mibs510/OpenXTCM5-Head-Unit/docs/portfolio/openxtcm5-head-unit/README.md

# OpenXTCM5 Portfolio Draft

This directory contains the long-form portfolio draft and editable Mermaid sources for the OpenXTCM5 project.

| Path | Purpose |
| --- | --- |
| [openxtcm5-head-unit.md](openxtcm5-head-unit.md) | Long-form technical portfolio draft. |
| [01-openxtcm5-recoverable-system-draft.md](01-openxtcm5-recoverable-system-draft.md) | Condensed first-article draft; explicitly pre-layout and not published. |
| [gap-analysis.md](gap-analysis.md) | Editorial and engineering evidence gaps before publication. |
| [publication-roadmap.md](publication-roadmap.md) | Three-revision plan: schematic, layout, then prototype evidence and corrections. |
| [diagrams/system-architecture.mmd](diagrams/system-architecture.mmd) | System ownership diagram. |
| [diagrams/power-state-machine.mmd](diagrams/power-state-machine.mmd) | Global power sequencing diagram. |
| [diagrams/display-touch-stack.mmd](diagrams/display-touch-stack.mmd) | Display-bias and GT911 touch diagram. |
| [diagrams/rp2354-firmware-update.mmd](diagrams/rp2354-firmware-update.mmd) | CM5-controlled RP2354 USB BOOTSEL firmware-update sequence, with recovery as a fallback use. |
| [diagrams/design-review-loop.mmd](diagrams/design-review-loop.mmd) | Iterative review and validation loop. |
| [diagrams/mermaid-static-config.json](diagrams/mermaid-static-config.json) | Shared visual style for static Mermaid renders. |
| [diagrams/static/](diagrams/static/) | High-resolution PNG renders ready to upload to Ghost. |

The Mermaid diagrams remain the editable source. The matching PNGs in `diagrams/static/` are the static article assets; regenerate them after changing a source diagram or the shared render configuration.
