mibs510/OpenXTCM5-Head-Unit/pcb/audio-amplifier.kicad_sch

## KiCad design pcb/audio-amplifier.kicad_sch (2026-10-04)

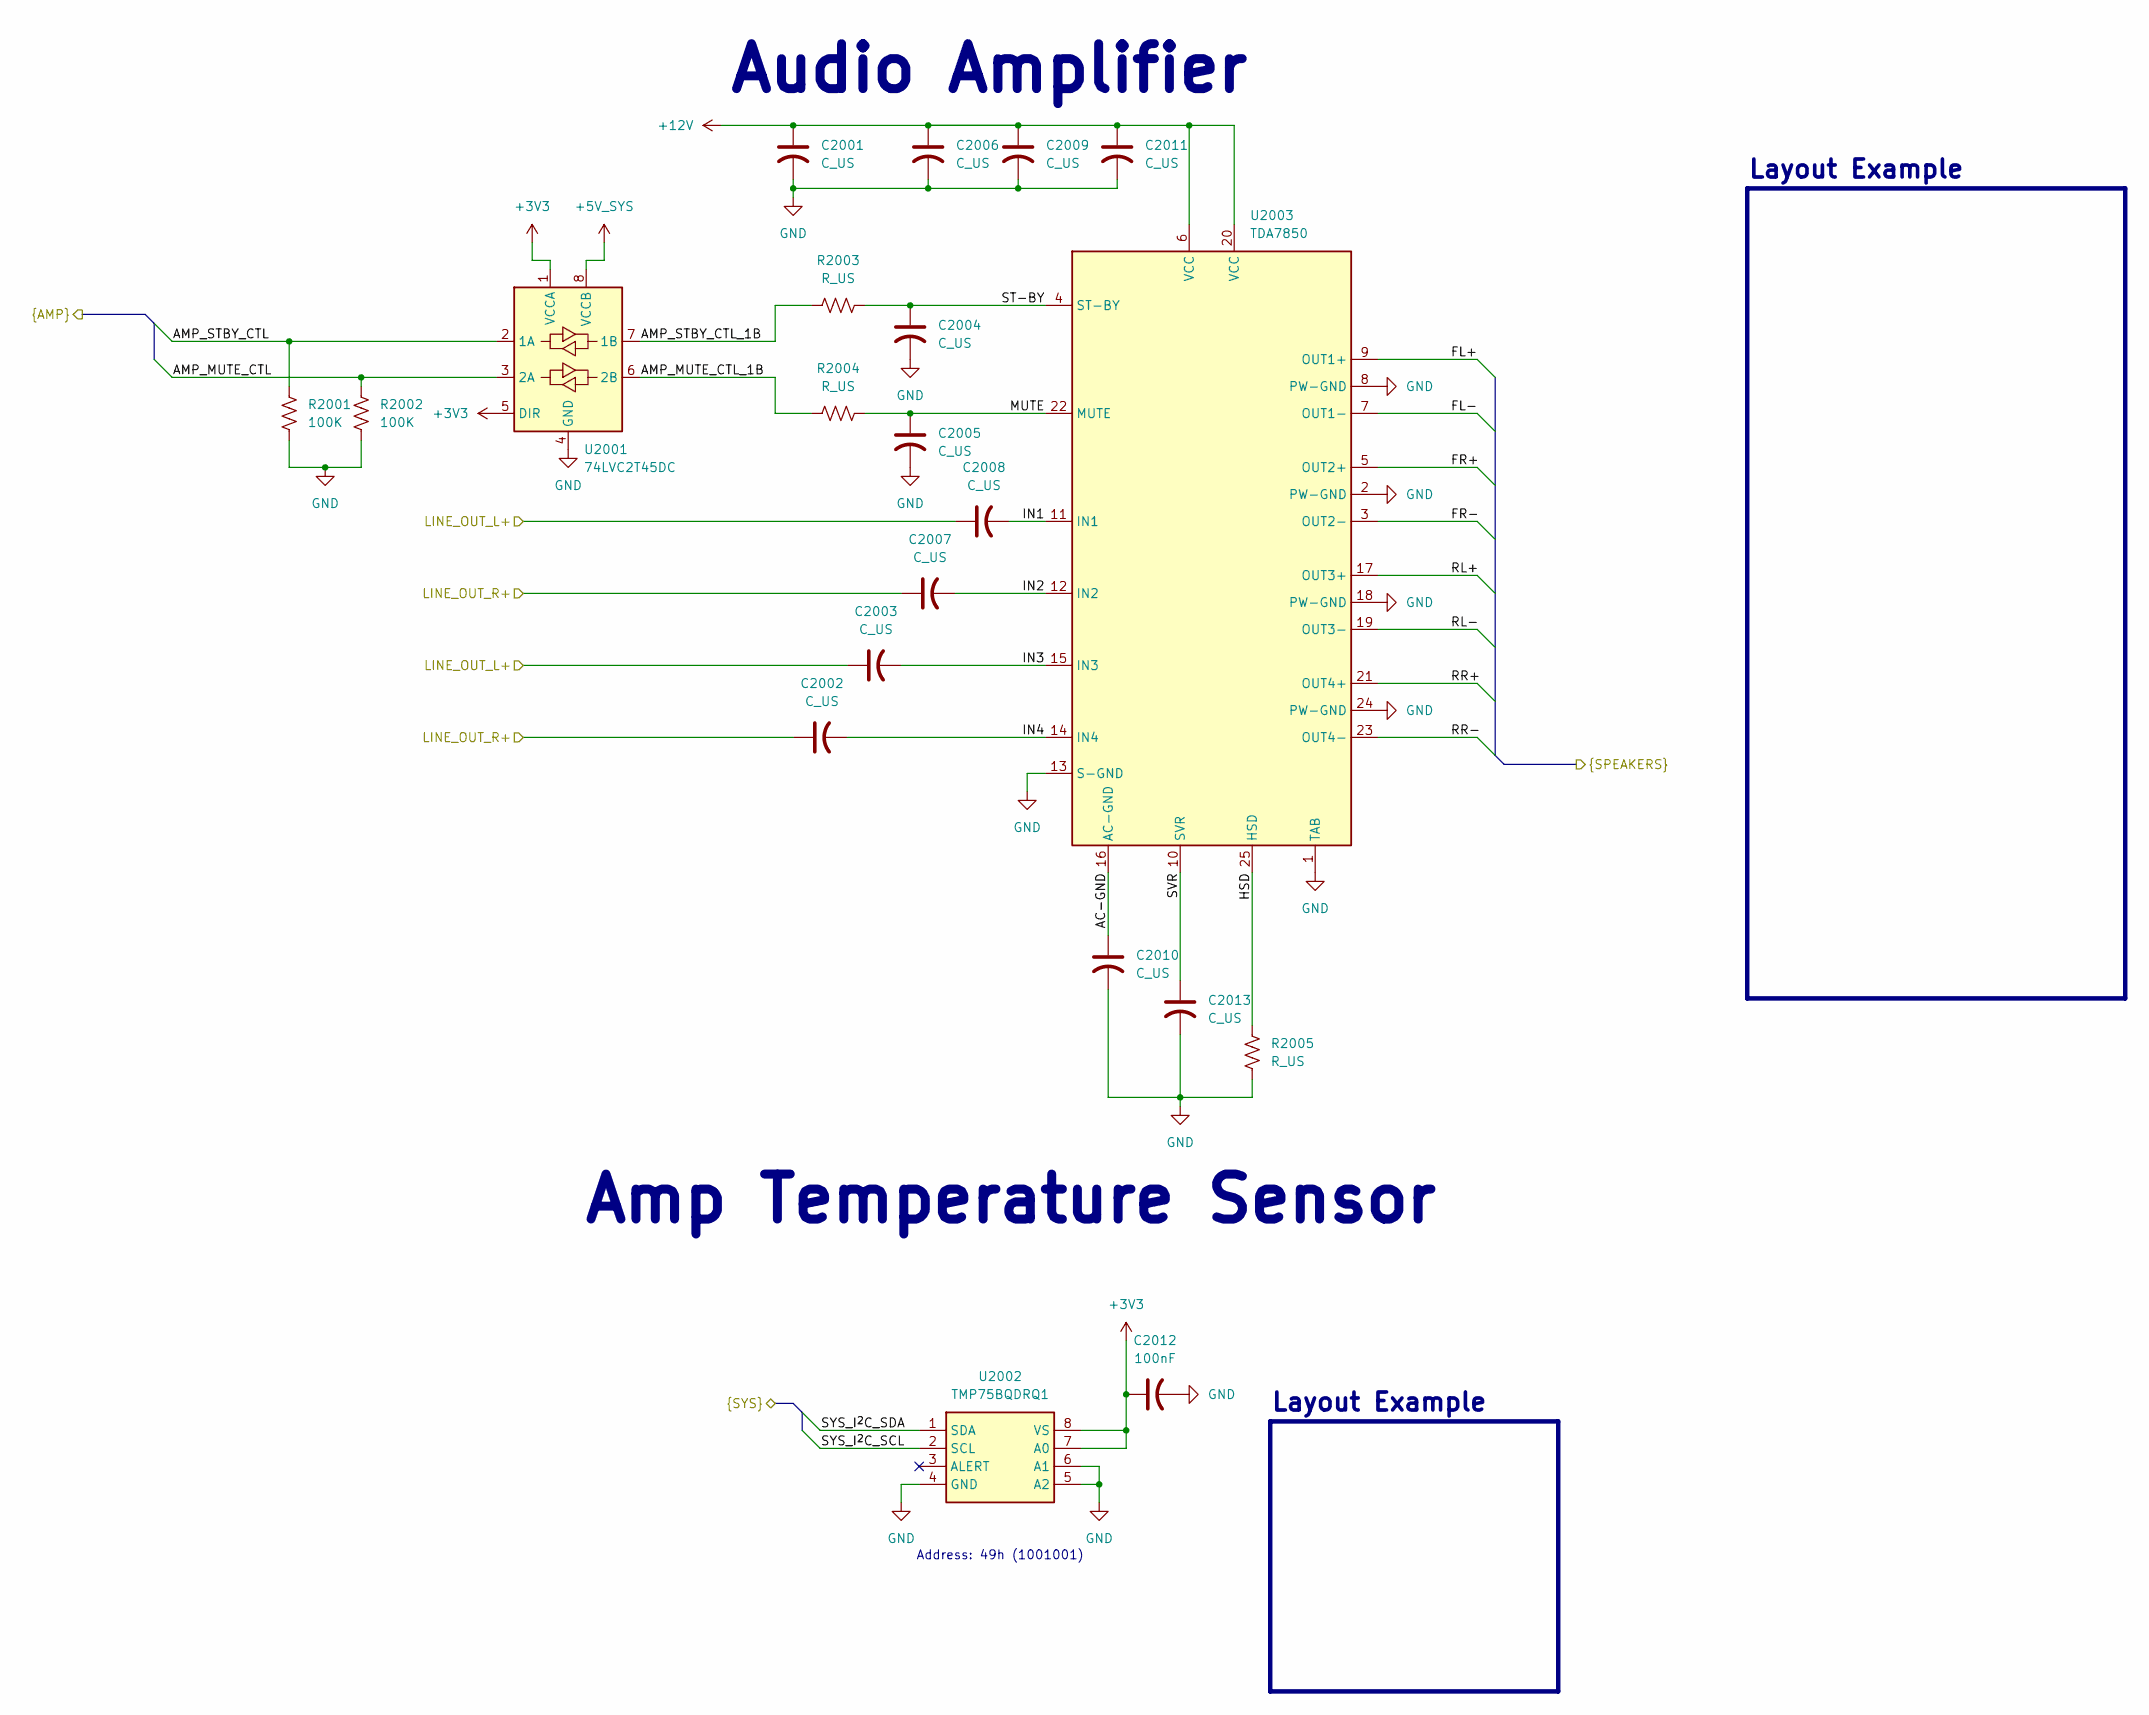
[picture p1: schematic audio-amplifier.kicad_sch]

Parts:
C2001, C2002, C2003, C2004, C2005, C2006, C2007, C2008, C2009, C2010, C2011, C2013: C_US; C_0603_1608Metric
C2012: 100nF; C_0603_1608Metric
R2001, R2002: 100K; R_0603_1608Metric
R2003, R2004, R2005: R_US; R_0603_1608Metric
U2001: 74LVC2T45DC; VSSOP-8_2.3x2mm_P0.5mm
U2002: TMP75BQDRQ1; SOIC127P600X175-8N; Mouser Part Number 595-TMP75BQDRQ1
U2003: TDA7850; TO100P465X2910X1977-25P; Mouser Part Number 511-TDA7850

Connections:
+3V3: C2012.1, U2001.1 (VCCA), U2001.5 (DIR), U2002.7 (A0), U2002.8 (VS)
+5V_SYS: U2001.8 (VCCB)
+12V: C2001.1, C2006.1, C2009.1, C2011.1, U2003.6 (VCC), U2003.20 (VCC)
AC-GND: C2010.1, U2003.16 (AC-GND)
AMP_MUTE_CTL: R2002.1, U2001.3 (2A)
AMP_MUTE_CTL_1B: R2004.1, U2001.6 (2B)
AMP_STBY_CTL: R2001.1, U2001.2 (1A)
AMP_STBY_CTL_1B: R2003.1, U2001.7 (1B)
FL+: U2003.9 (OUT1+)
FL-: U2003.7 (OUT1-)
FR+: U2003.5 (OUT2+)
FR-: U2003.3 (OUT2-)
GND: C2001.2, C2004.2, C2005.2, C2006.2, C2009.2, C2010.2, C2011.2, C2012.2, C2013.2, R2001.2, R2002.2, R2005.2, U2001.4 (GND), U2002.4 (GND), U2002.5 (A2), U2002.6 (A1), U2003.1 (TAB), U2003.2 (PW-GND), U2003.8 (PW-GND), U2003.13 (S-GND), U2003.18 (PW-GND), U2003.24 (PW-GND)
HSD: R2005.1, U2003.25 (HSD)
IN1: C2008.2, U2003.11 (IN1)
IN2: C2007.2, U2003.12 (IN2)
IN3: C2003.2, U2003.15 (IN3)
IN4: C2002.2, U2003.14 (IN4)
LINE_OUT_L+: C2003.1, C2008.1
LINE_OUT_R+: C2002.1, C2007.1
MUTE: C2005.1, R2004.2, U2003.22 (MUTE)
RL+: U2003.17 (OUT3+)
RL-: U2003.19 (OUT3-)
RR+: U2003.21 (OUT4+)
RR-: U2003.23 (OUT4-)
ST-BY: C2004.1, R2003.2, U2003.4 (ST-BY)
SVR: C2013.1, U2003.10 (SVR)
SYS_I^{2}C_SCL: U2002.2 (SCL)
SYS_I^{2}C_SDA: U2002.1 (SDA)

Notes on the sheet:
Audio Amplifier
Address: 49h (1001001)
Amp Temperature Sensor
Layout Example
