mibs510/OpenXTCM5-Head-Unit/pcb/audio.kicad_sch

## KiCad design pcb/audio.kicad_sch (2026-10-04)

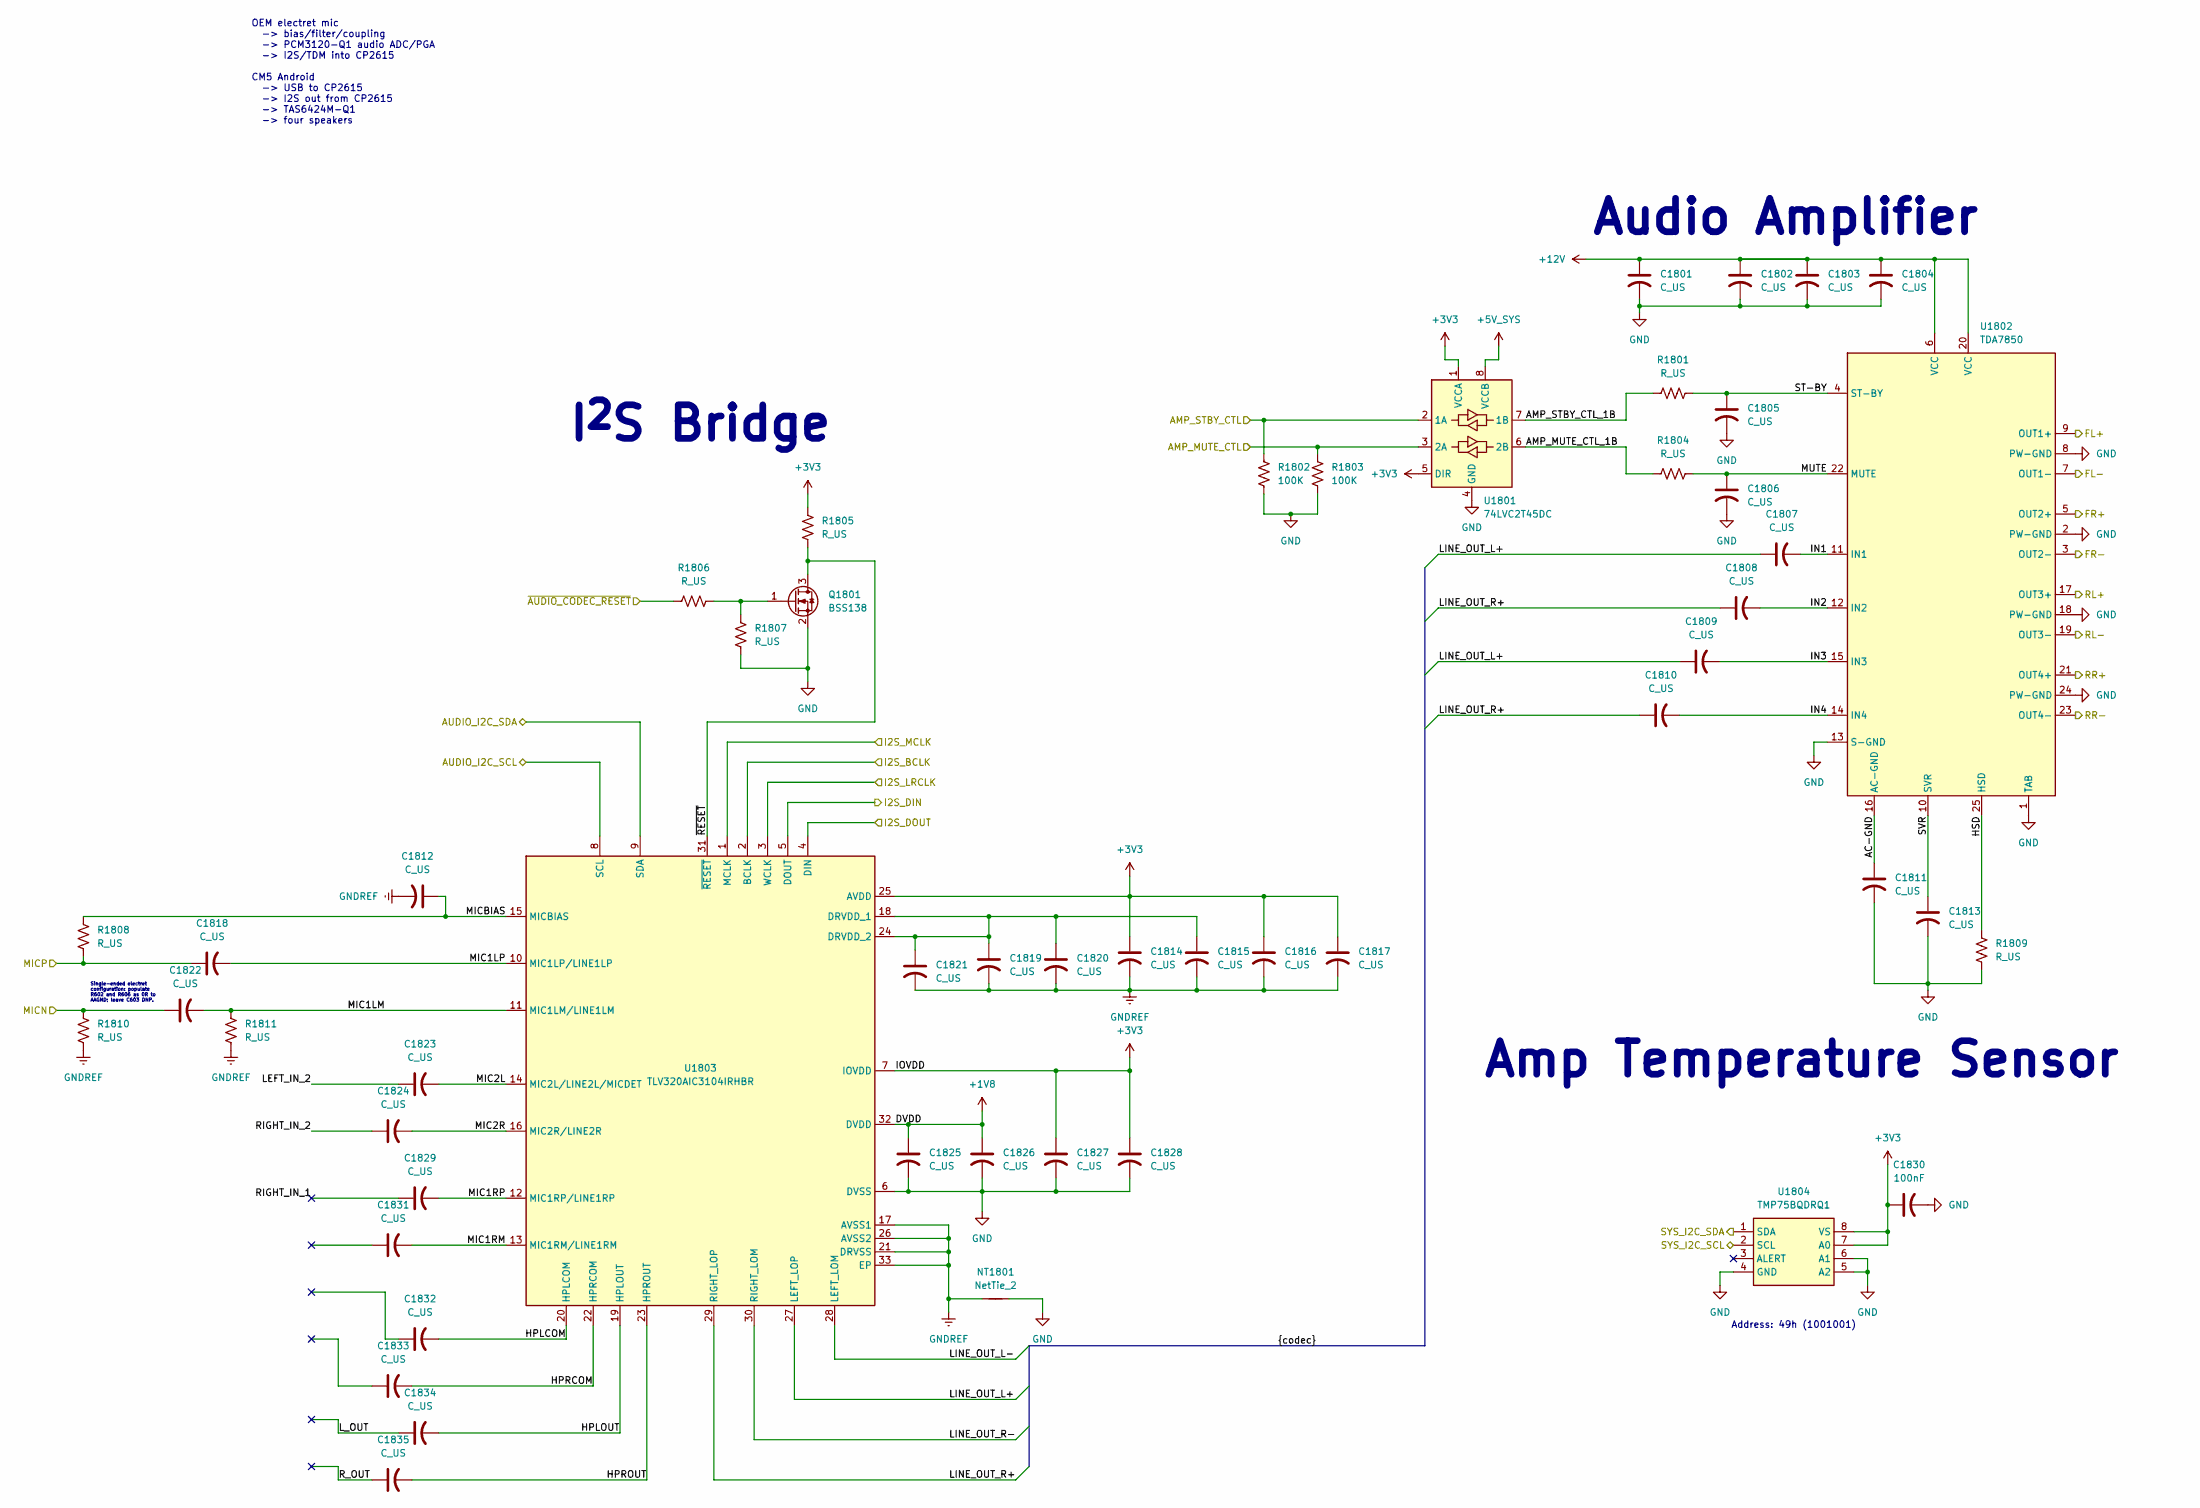
[picture p2: schematic audio.kicad_sch]

Parts:
C1801, C1802, C1803, C1804, C1805, C1806, C1807, C1808, C1809, C1810, C1811, C1812, C1813, C1818, C1822, C1823, C1824, C1829, C1831, C1832, C1833, C1834, C1835: C_US; C_0603_1608Metric
C1814, C1815, C1816, C1817, C1819, C1820, C1821, C1825, C1826, C1827, C1828: C_US; C_0805_2012Metric
C1830: 100nF; C_0603_1608Metric
NT1801: NetTie_2; NetTie-2_THT_Pad0.3mm
Q1801: BSS138; SOT-23
R1801, R1804, R1805, R1806, R1807, R1808, R1809, R1810, R1811: R_US; R_0603_1608Metric
R1802, R1803: 100K; R_0603_1608Metric
U1801: 74LVC2T45DC; VSSOP-8_2.3x2mm_P0.5mm
U1802: TDA7850; TO100P465X2910X1977-25P; Mouser Part Number 511-TDA7850
U1803: TLV320AIC3104IRHBR; QFN50P500X500X100-33N-D; Mouser Part Number 595-TLV320C3104IRHBR
U1804: TMP75BQDRQ1; SOIC127P600X175-8N; Mouser Part Number 595-TMP75BQDRQ1

Connections:
+1V8: C1825.1, C1826.1, U1803.32 (DVDD)
+3V3: C1814.1, C1816.1, C1817.1, C1827.1, C1828.1, C1830.1, R1805.2, U1801.1 (VCCA), U1801.5 (DIR), U1803.7 (IOVDD), U1803.25 (AVDD), U1804.7 (A0), U1804.8 (VS)
+5V_SYS: U1801.8 (VCCB)
+12V: C1801.1, C1802.1, C1803.1, C1804.1, U1802.6 (VCC), U1802.20 (VCC)
AC-GND: C1811.1, U1802.16 (AC-GND)
AMP_MUTE_CTL: R1803.1, U1801.3 (2A)
AMP_MUTE_CTL_1B: R1804.1, U1801.6 (2B)
AMP_STBY_CTL: R1802.1, U1801.2 (1A)
AMP_STBY_CTL_1B: R1801.1, U1801.7 (1B)
AUDIO_I2C_SCL: U1803.8 (SCL)
AUDIO_I2C_SDA: U1803.9 (SDA)
FL+: U1802.9 (OUT1+)
FL-: U1802.7 (OUT1-)
FR+: U1802.5 (OUT2+)
FR-: U1802.3 (OUT2-)
GND: C1801.2, C1802.2, C1803.2, C1804.2, C1805.2, C1806.2, C1811.2, C1813.2, C1825.2, C1826.2, C1827.2, C1828.2, C1830.2, NT1801.2, Q1801.2 (S), R1802.2, R1803.2, R1807.1, R1809.2, U1801.4 (GND), U1802.1 (TAB), U1802.2 (PW-GND), U1802.8 (PW-GND), U1802.13 (S-GND), U1802.18 (PW-GND), U1802.24 (PW-GND), U1803.6 (DVSS), U1804.4 (GND), U1804.5 (A2), U1804.6 (A1)
GNDREF: C1812.2, C1814.2, C1815.2, C1816.2, C1817.2, C1819.2, C1820.2, C1821.2, NT1801.1, R1810.2, R1811.2, U1803.17 (AVSS1), U1803.21 (DRVSS), U1803.26 (AVSS2), U1803.33 (EP)
HPLCOM: C1832.2, U1803.20 (HPLCOM)
HPLOUT: C1834.2, U1803.19 (HPLOUT)
HPRCOM: C1833.2, U1803.22 (HPRCOM)
HPROUT: C1835.2, U1803.23 (HPROUT)
HSD: R1809.1, U1802.25 (HSD)
I2S_BCLK: U1803.2 (BCLK)
I2S_DIN: U1803.5 (DOUT)
I2S_DOUT: U1803.4 (DIN)
I2S_LRCLK: U1803.3 (WCLK)
I2S_MCLK: U1803.1 (MCLK)
IN1: C1807.2, U1802.11 (IN1)
IN2: C1808.2, U1802.12 (IN2)
IN3: C1809.2, U1802.15 (IN3)
IN4: C1810.2, U1802.14 (IN4)
LEFT_IN_2: C1823.1
LINE_OUT_L+: C1807.1, C1809.1, U1803.27 (LEFT_LOP)
LINE_OUT_L-: U1803.28 (LEFT_LOM)
LINE_OUT_R+: C1808.1, C1810.1, U1803.29 (RIGHT_LOP)
LINE_OUT_R-: U1803.30 (RIGHT_LOM)
L_OUT: C1834.1
MIC1LM: C1822.2, R1811.1, U1803.11 (MIC1LM/LINE1LM)
MIC1LP: C1818.2, U1803.10 (MIC1LP/LINE1LP)
MIC1RM: C1831.2, U1803.13 (MIC1RM/LINE1RM)
MIC1RP: C1829.2, U1803.12 (MIC1RP/LINE1RP)
MIC2L: C1823.2, U1803.14 (MIC2L/LINE2L/MICDET)
MIC2R: C1824.2, U1803.16 (MIC2R/LINE2R)
MICBIAS: C1812.1, R1808.1, U1803.15 (MICBIAS)
MICN: C1822.1, R1810.1
MICP: C1818.1, R1808.2
MUTE: C1806.1, R1804.2, U1802.22 (MUTE)
unnamed: C1815.1, C1819.1, C1820.1, C1821.1, U1803.18 (DRVDD_1), U1803.24 (DRVDD_2)
unnamed: Q1801.1 (G), R1806.2, R1807.2
RIGHT_IN_1: C1829.1
RIGHT_IN_2: C1824.1
RL+: U1802.17 (OUT3+)
RL-: U1802.19 (OUT3-)
RR+: U1802.21 (OUT4+)
RR-: U1802.23 (OUT4-)
R_OUT: C1835.1
ST-BY: C1805.1, R1801.2, U1802.4 (ST-BY)
SVR: C1813.1, U1802.10 (SVR)
SYS_I2C_SCL: U1804.2 (SCL)
SYS_I2C_SDA: U1804.1 (SDA)
~AUDIO_CODEC_RESET: R1806.1
~RESET: Q1801.3 (D), R1805.1, U1803.31 (~RESET)

Notes on the sheet:
Address: 49h (1001001)
Single-ended electret configuration: populate R602 and R606 as 0R to AAGND; leave C603 DNP.
Amp Temperature Sensor
Audio Amplifier
I^{2}S Bridge
OEM electret mic -> bias/filter/coupling -> PCM3120-Q1 audio ADC/PGA -> I2S/TDM into CP2615 CM5 Android -> USB to CP2615 -> I2S out from CP2615 -> TAS6424M-Q1 -> four speakers
