mibs510/OpenXTCM5-Head-Unit/pcb/can.kicad_sch

## KiCad design pcb/can.kicad_sch (2026-10-04)

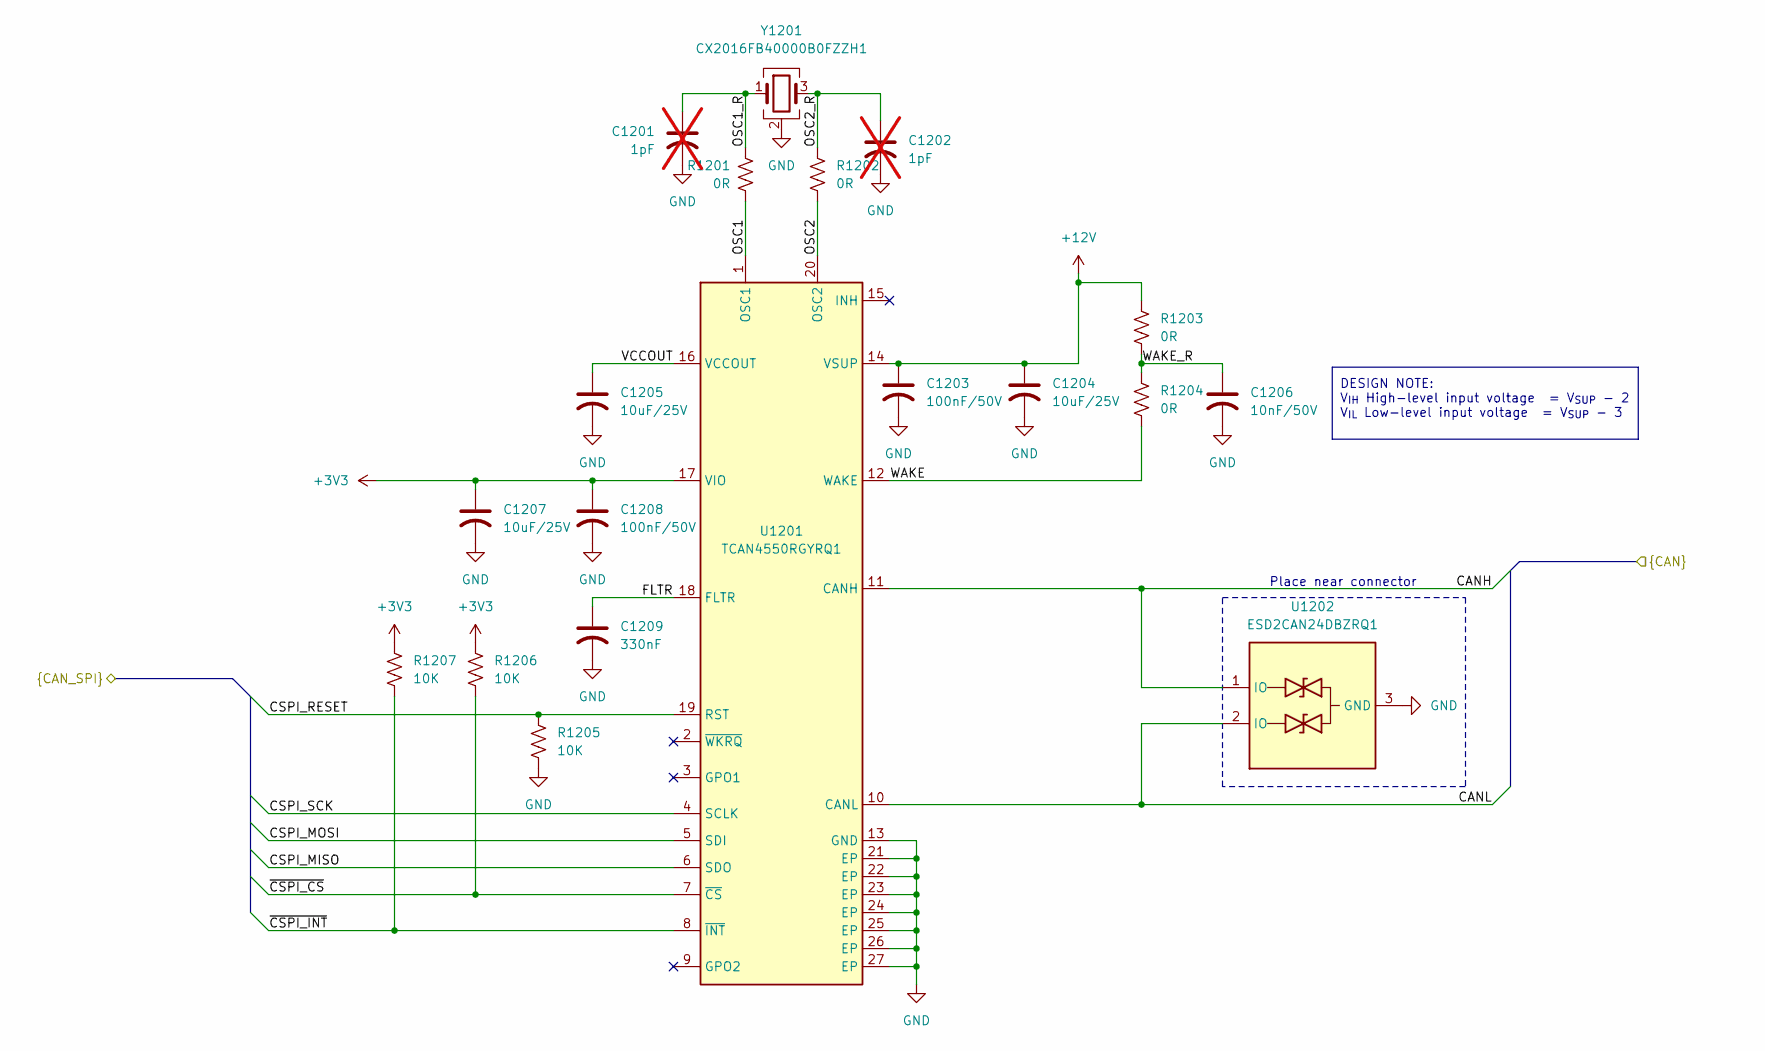
[picture p3: schematic can.kicad_sch]

Parts:
C1201, C1202: 1pF; C_0603_1608Metric; not fitted
C1203, C1208: 100nF/50V; C_0603_1608Metric
C1204, C1205, C1207: 10uF/25V; C_0805_2012Metric
C1206: 10nF/50V; C_0603_1608Metric
C1209: 330nF; C_0603_1608Metric
R1201, R1202, R1203, R1204: 0R; R_0603_1608Metric
R1205, R1206, R1207: 10K; R_0603_1608Metric
U1201: TCAN4550RGYRQ1; TCAN4551RGYRQ1; Mouser Part Number 595-TCAN4550RGYRQ1
U1202: ESD2CAN24DBZRQ1; SOT95P237X112-3N; Mouser Part Number 595-ESD2CAN24DBZRQ1
Y1201: CX2016FB40000B0FZZH1; Crystal_SMD_2016-4Pin_2.0x1.6mm

Connections:
+3V3: C1207.1, C1208.1, R1206.1, R1207.1, U1201.17 (VIO)
+12V: C1203.1, C1204.1, R1203.1, U1201.14 (VSUP)
CANH: U1201.11 (CANH), U1202.1 (IO)
CANL: U1201.10 (CANL), U1202.2 (IO)
CSPI_MISO: U1201.6 (SDO)
CSPI_MOSI: U1201.5 (SDI)
CSPI_RESET: R1205.1, U1201.19 (RST)
CSPI_SCK: U1201.4 (SCLK)
FLTR: C1209.1, U1201.18 (FLTR)
GND: C1201.2, C1202.2, C1203.2, C1204.2, C1205.2, C1206.2, C1207.2, C1208.2, C1209.2, R1205.2, U1201.13 (GND), U1201.21 (EP), U1201.22 (EP), U1201.23 (EP), U1201.24 (EP), U1201.25 (EP), U1201.26 (EP), U1201.27 (EP), U1202.3 (GND), Y1201.2 (G), Y1201.4 (G)
OSC1: R1201.2, U1201.1 (OSC1)
OSC1_R: C1201.1, R1201.1, Y1201.1
OSC2: R1202.2, U1201.20 (OSC2)
OSC2_R: C1202.1, R1202.1, Y1201.3
VCCOUT: C1205.1, U1201.16 (VCCOUT)
WAKE: R1204.2, U1201.12 (WAKE)
WAKE_R: C1206.1, R1203.2, R1204.1
~CSPI_CS: R1206.2, U1201.7 (~CS)
~CSPI_INT: R1207.2, U1201.8 (~INT)

Notes on the sheet:
DESIGN NOTE: V_{IH} High-level input voltage = V_{SUP} - 2 V_{IL} Low-level input voltage = V_{SUP} - 3
Place near connector
