mibs510/OpenXTCM5-Head-Unit/pcb/cm5.kicad_sch

## KiCad design pcb/cm5.kicad_sch (2026-10-04)

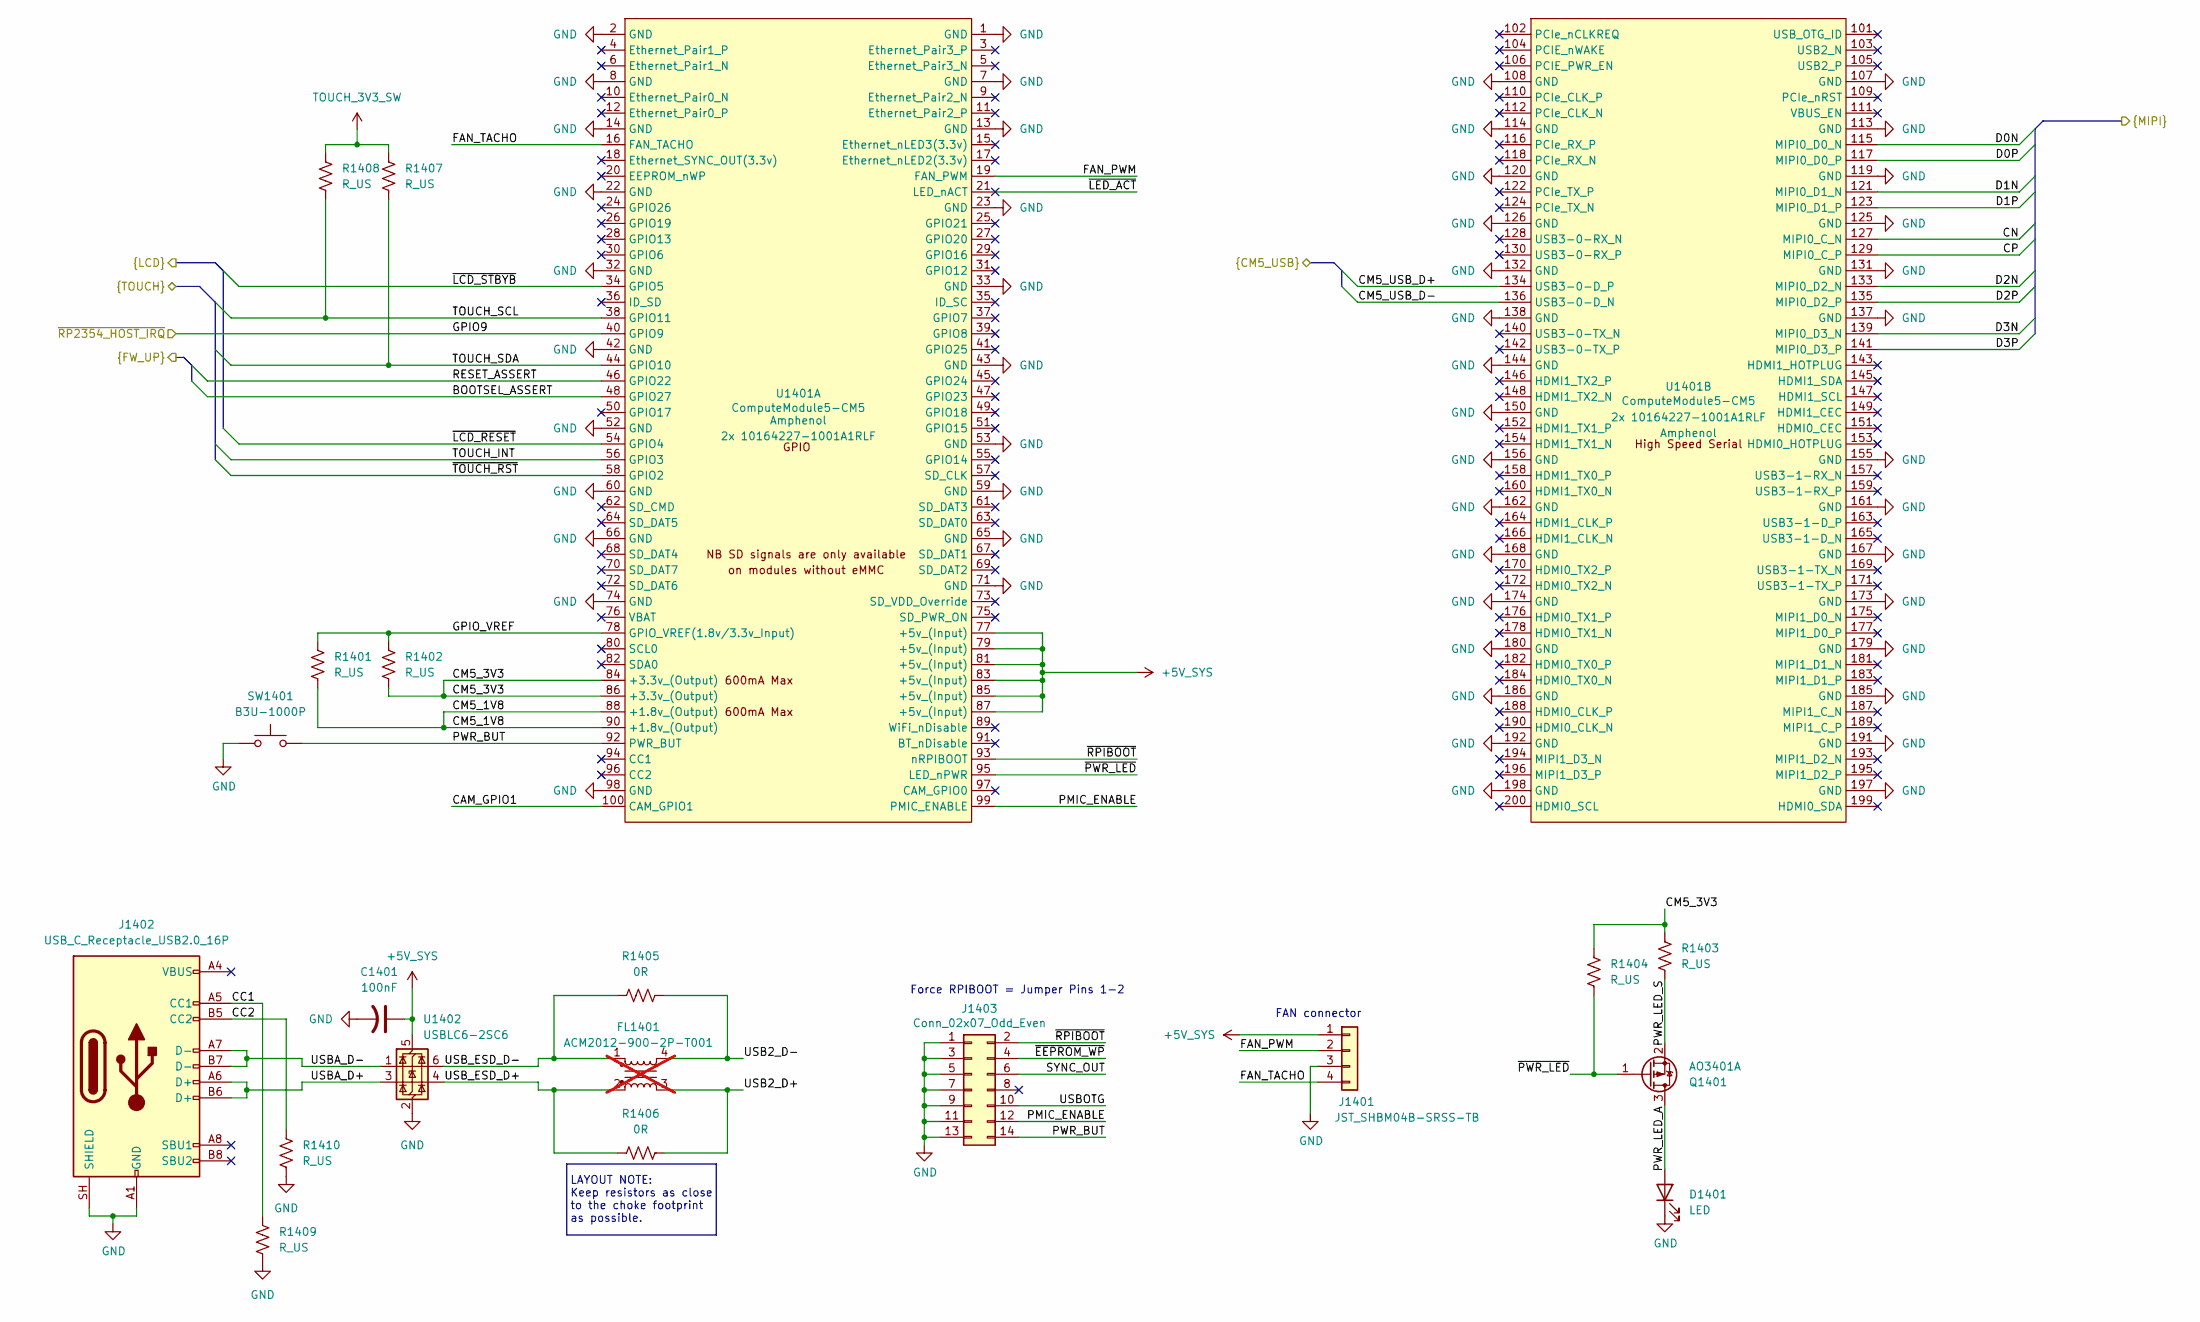
[picture p4: schematic cm5.kicad_sch]

Parts:
C1401: 100nF; C_0603_1608Metric
D1401: LED; LED_0805_2012Metric
FL1401: ACM2012-900-2P-T001; ACM20121022PT001; Mouser Part Number 810-ACM20129002PT001; not fitted
J1401: JST_SHBM04B-SRSS-TB; JST_SH_BM04B-SRSS-TB_1x04-1MP_P1.00mm_Vertical; Part Description 4 pin vertical 1mm pitch connector
J1402: USB_C_Receptacle_USB2.0_16P; USB_C_Receptacle_GCT_USB4105-xx-A_16P_TopMnt_Horizontal
J1403: Conn_02x07_Odd_Even; PinHeader_2x07_P2.54mm_Vertical; Part Description PinHeader_2x07_P2.54mm_Vertical
Q1401: AO3401A; SOT-23
R1401, R1402, R1403, R1404, R1407, R1408, R1409, R1410: R_US; R_0603_1608Metric
R1405, R1406: 0R; R_0603_1608Metric
SW1401: B3U-1000P; SW_SPST_B3U-1000P
U1401: ComputeModule5-CM5; Raspberry-Pi-5-Compute-Module; Part Description 100 Position Connector Receptacle, Cent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
U1402: USBLC6-2SC6; SOT-23-6

Connections:
+5V_SYS: C1401.1, J1401.1, U1401.77 (+5v_(Input)), U1401.79 (+5v_(Input)), U1401.81 (+5v_(Input)), U1401.83 (+5v_(Input)), U1401.85 (+5v_(Input)), U1401.87 (+5v_(Input)), U1402.5 (VBUS)
BOOTSEL_ASSERT: U1401.48 (GPIO27)
CAM_GPIO1: U1401.100 (CAM_GPIO1)
CC1: J1402.A5 (CC1), R1409.1
CC2: J1402.B5 (CC2), R1410.1
CM5_1V8: R1401.1, U1401.88 (+1.8v_(Output)), U1401.90 (+1.8v_(Output))
CM5_3V3: R1402.2, R1403.1, R1404.1, U1401.84 (+3.3v_(Output)), U1401.86 (+3.3v_(Output))
CM5_USB_D+: U1401.134 (USB3-0-D_P)
CM5_USB_D-: U1401.136 (USB3-0-D_N)
CN: U1401.127 (MIPI0_C_N)
CP: U1401.129 (MIPI0_C_P)
D0N: U1401.115 (MIPI0_D0_N)
D0P: U1401.117 (MIPI0_D0_P)
D1N: U1401.121 (MIPI0_D1_N)
D1P: U1401.123 (MIPI0_D1_P)
D2N: U1401.133 (MIPI0_D2_N)
D2P: U1401.135 (MIPI0_D2_P)
D3N: U1401.139 (MIPI0_D3_N)
D3P: U1401.141 (MIPI0_D3_P)
FAN_PWM: J1401.2, U1401.19 (FAN_PWM)
FAN_TACHO: J1401.4, U1401.16 (FAN_TACHO)
GND: C1401.2, D1401.1 (K), J1401.3, J1402.A1 (GND), J1402.A12 (GND), J1402.B1 (GND), J1402.B12 (GND), J1402.SH (SHIELD), J1403.1, J1403.3, J1403.5, J1403.7, J1403.9, J1403.11, J1403.13, R1409.2, R1410.2, SW1401.1, U1401.1 (GND), U1401.2 (GND), U1401.7 (GND), U1401.8 (GND), U1401.13 (GND), U1401.14 (GND), U1401.22 (GND), U1401.23 (GND), U1401.32 (GND), U1401.33 (GND), U1401.42 (GND), U1401.43 (GND), U1401.52 (GND), U1401.53 (GND), U1401.59 (GND), U1401.60 (GND), U1401.65 (GND), U1401.66 (GND), U1401.71 (GND), U1401.74 (GND), U1401.98 (GND), U1401.107 (GND), U1401.108 (GND), U1401.113 (GND), U1401.114 (GND), U1401.119 (GND), U1401.120 (GND), U1401.125 (GND), U1401.126 (GND), U1401.131 (GND), U1401.132 (GND), U1401.137 (GND), U1401.138 (GND), U1401.144 (GND), U1401.150 (GND), U1401.155 (GND), U1401.156 (GND), U1401.161 (GND), U1401.162 (GND), U1401.167 (GND), U1401.168 (GND), U1401.173 (GND), U1401.174 (GND), U1401.179 (GND), U1401.180 (GND), U1401.185 (GND), U1401.186 (GND), U1401.191 (GND), U1401.192 (GND), U1401.197 (GND), U1401.198 (GND), U1402.2 (GND)
GPIO9: U1401.40 (GPIO9)
GPIO_VREF: R1401.2, R1402.1, U1401.78 (GPIO_VREF(1.8v/3.3v_Input))
unnamed: J1402.A4 (VBUS), J1402.A9 (VBUS), J1402.B4 (VBUS), J1402.B9 (VBUS)
PMIC_ENABLE: J1403.12, U1401.99 (PMIC_ENABLE)
PWR_BUT: J1403.14, SW1401.2, U1401.92 (PWR_BUT)
PWR_LED_A: D1401.2 (A), Q1401.3 (D)
PWR_LED_S: Q1401.2 (S), R1403.2
RESET_ASSERT: U1401.46 (GPIO22)
SYNC_OUT: J1403.6
TOUCH_3V3_SW: R1407.1, R1408.1
TOUCH_INT: U1401.56 (GPIO3)
TOUCH_SCL: R1408.2, U1401.38 (GPIO11)
TOUCH_SDA: R1407.2, U1401.44 (GPIO10)
USB2_D+: FL1401.3, R1406.2
USB2_D-: FL1401.4, R1405.2
USBA_D+: J1402.A6 (D+), J1402.B6 (D+), U1402.3 (I/O2)
USBA_D-: J1402.A7 (D-), J1402.B7 (D-), U1402.1 (I/O1)
USBOTG: J1403.10
USB_ESD_D+: FL1401.2, R1406.1, U1402.4 (I/O2)
USB_ESD_D-: FL1401.1, R1405.1, U1402.6 (I/O1)
~EEPROM_WP: J1403.4
~LCD_RESET: U1401.54 (GPIO4)
~LCD_STBYB: U1401.34 (GPIO5)
~LED_ACT: U1401.21 (LED_nACT)
~PWR_LED: Q1401.1 (G), R1404.2, U1401.95 (LED_nPWR)
~RPIBOOT: J1403.2, U1401.93 (nRPIBOOT)
~TOUCH_RST: U1401.58 (GPIO2)

Notes on the sheet:
FAN connector
Force RPIBOOT = Jumper Pins 1-2
LAYOUT NOTE: Keep resistors as close to the choke footprint as possible.
