mibs510/OpenXTCM5-Head-Unit/pcb/display-power.kicad_sch

## KiCad design pcb/display-power.kicad_sch (2026-10-04)

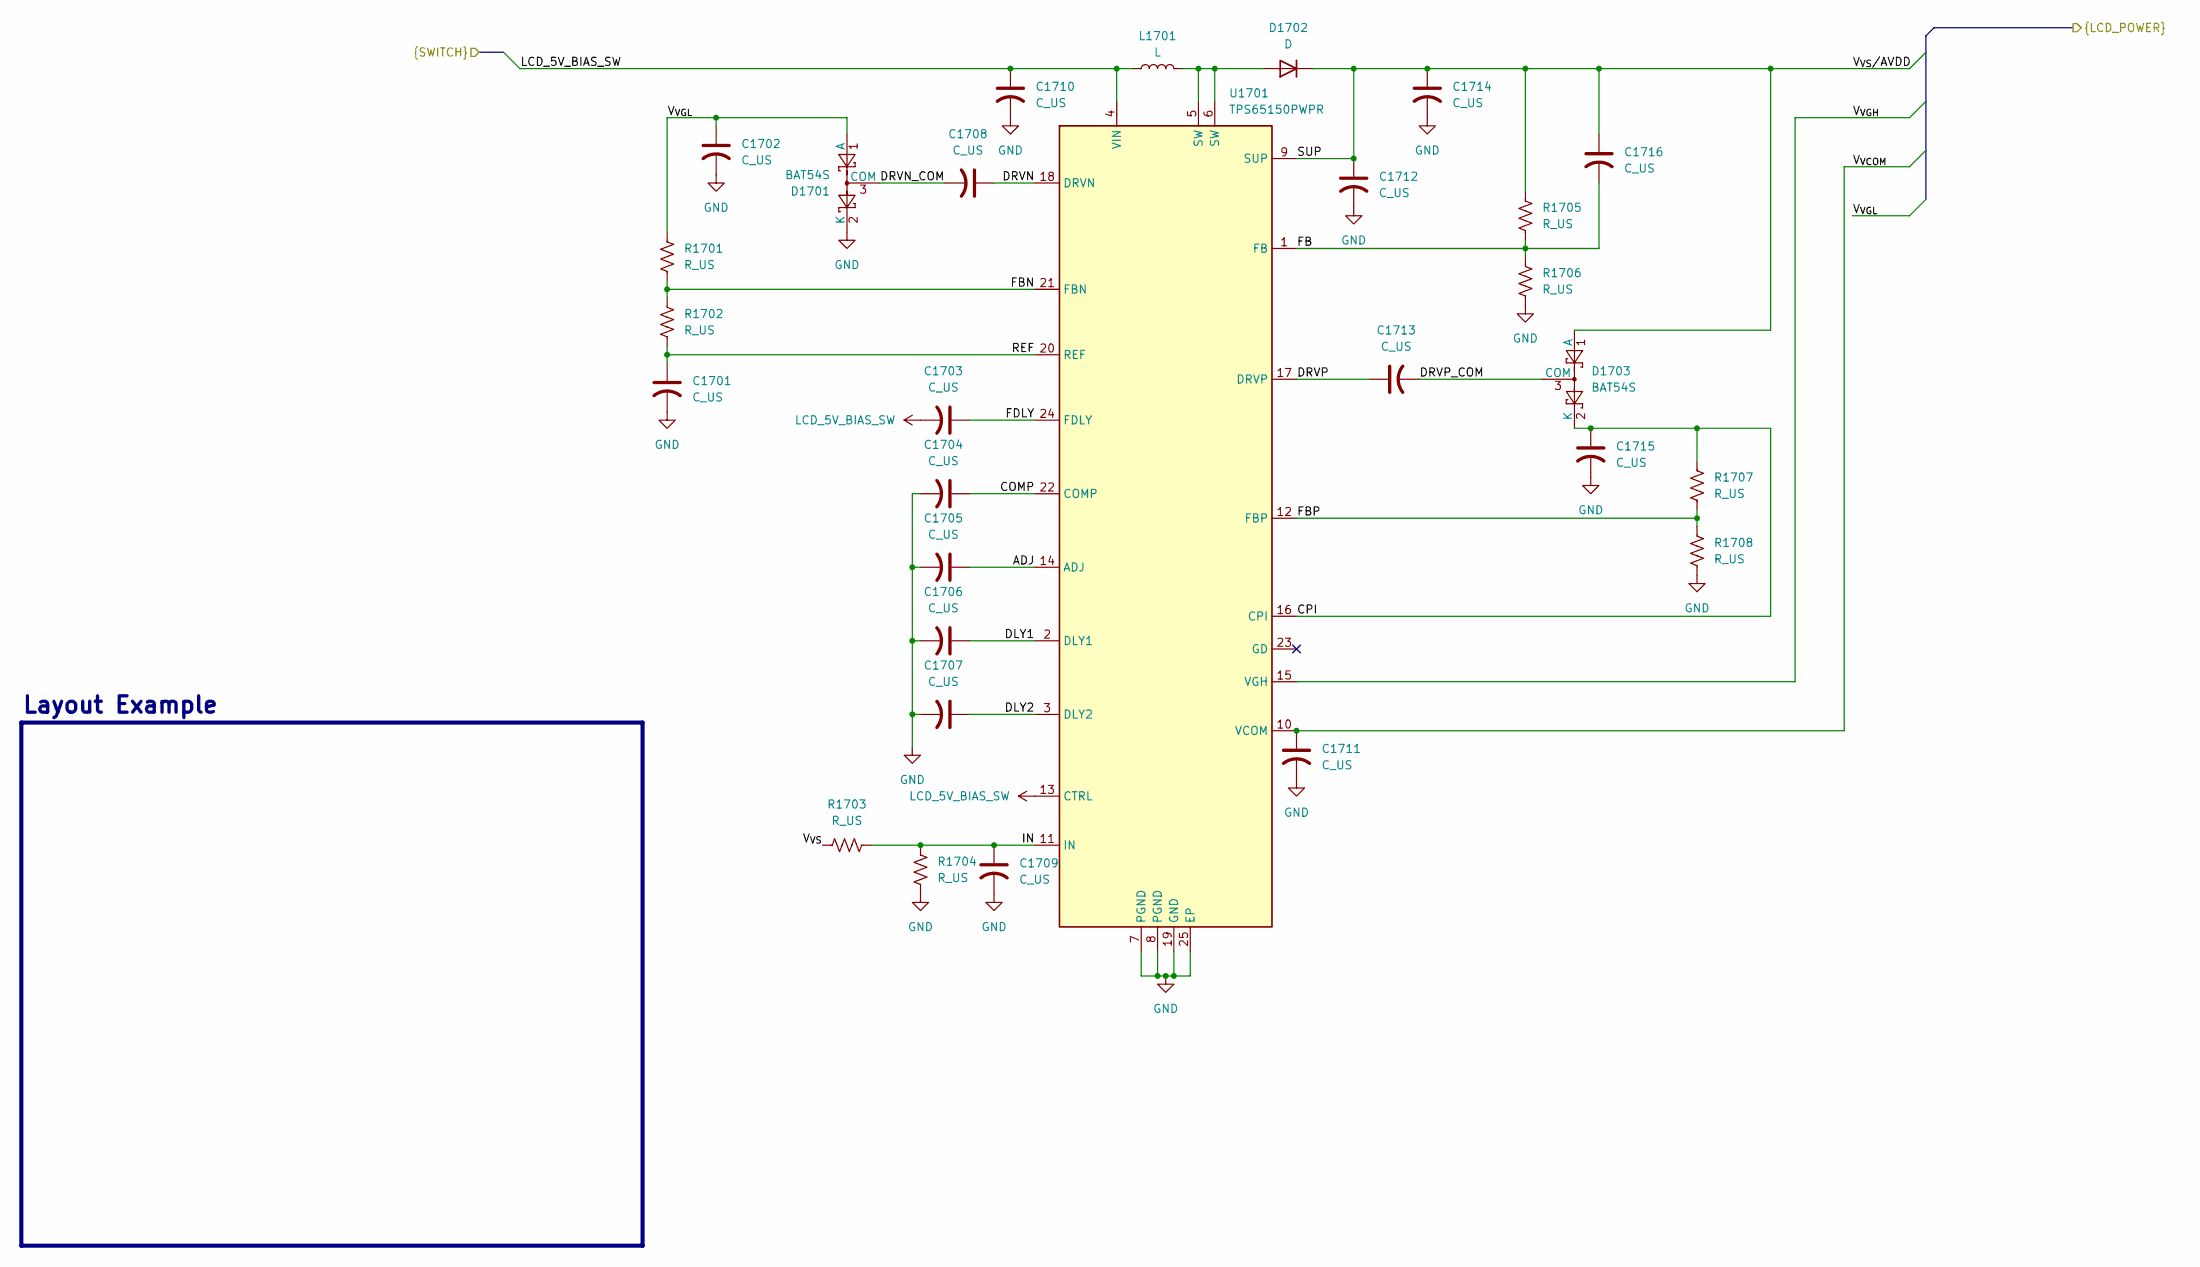
[picture p5: schematic display-power.kicad_sch]

Parts:
C1701, C1702, C1703, C1704, C1705, C1706, C1707, C1708, C1709, C1710, C1711, C1712, C1713, C1714, C1715, C1716: C_US; C_0805_2012Metric
D1701, D1703: BAT54S; SOT-23
D1702: D; D_SMB
L1701: L
R1701, R1702, R1703, R1704, R1705, R1706, R1707, R1708: R_US; R_0603_1608Metric
U1701: TPS65150PWPR; SOP65P640X120-25N; Mouser Part Number 595-TPS65150PWPR

Connections:
ADJ: C1705.1, U1701.14 (ADJ)
COMP: C1704.1, U1701.22 (COMP)
CPI: C1715.1, D1703.2 (K), R1707.1, U1701.16 (CPI)
DLY1: C1706.1, U1701.2 (DLY1)
DLY2: C1707.1, U1701.3 (DLY2)
DRVN: C1708.1, U1701.18 (DRVN)
DRVN_COM: C1708.2, D1701.3 (COM)
DRVP: C1713.1, U1701.17 (DRVP)
DRVP_COM: C1713.2, D1703.3 (COM)
FB: C1716.2, R1705.2, R1706.1, U1701.1 (FB)
FBN: R1701.2, R1702.1, U1701.21 (FBN)
FBP: R1707.2, R1708.1, U1701.12 (FBP)
FDLY: C1703.1, U1701.24 (FDLY)
GND: C1701.2, C1702.2, C1704.2, C1705.2, C1706.2, C1707.2, C1709.2, C1710.2, C1711.2, C1712.2, C1714.2, C1715.2, D1701.2 (K), R1704.2, R1706.2, R1708.2, U1701.7 (PGND), U1701.8 (PGND), U1701.19 (GND), U1701.25 (EP)
IN: C1709.1, R1703.2, R1704.1, U1701.11 (IN)
LCD_5V_BIAS_SW: C1703.2, C1710.1, L1701.1, U1701.4 (VIN), U1701.13 (CTRL)
unnamed: D1702.2 (A), L1701.2, U1701.5 (SW), U1701.6 (SW)
REF: C1701.1, R1702.2, U1701.20 (REF)
SUP: C1712.1, C1714.1, C1716.1, D1702.1 (K), D1703.1 (A), R1705.1, U1701.9 (SUP)
V_{VCOM}: C1711.1, U1701.10 (VCOM)
V_{VGH}: U1701.15 (VGH)
V_{VGL}: C1702.1, D1701.1 (A), R1701.1
V_{VS}: R1703.1

Notes on the sheet:
Layout Example
