mibs510/OpenXTCM5-Head-Unit/pcb/display.kicad_sch

## KiCad design pcb/display.kicad_sch (2026-10-04)

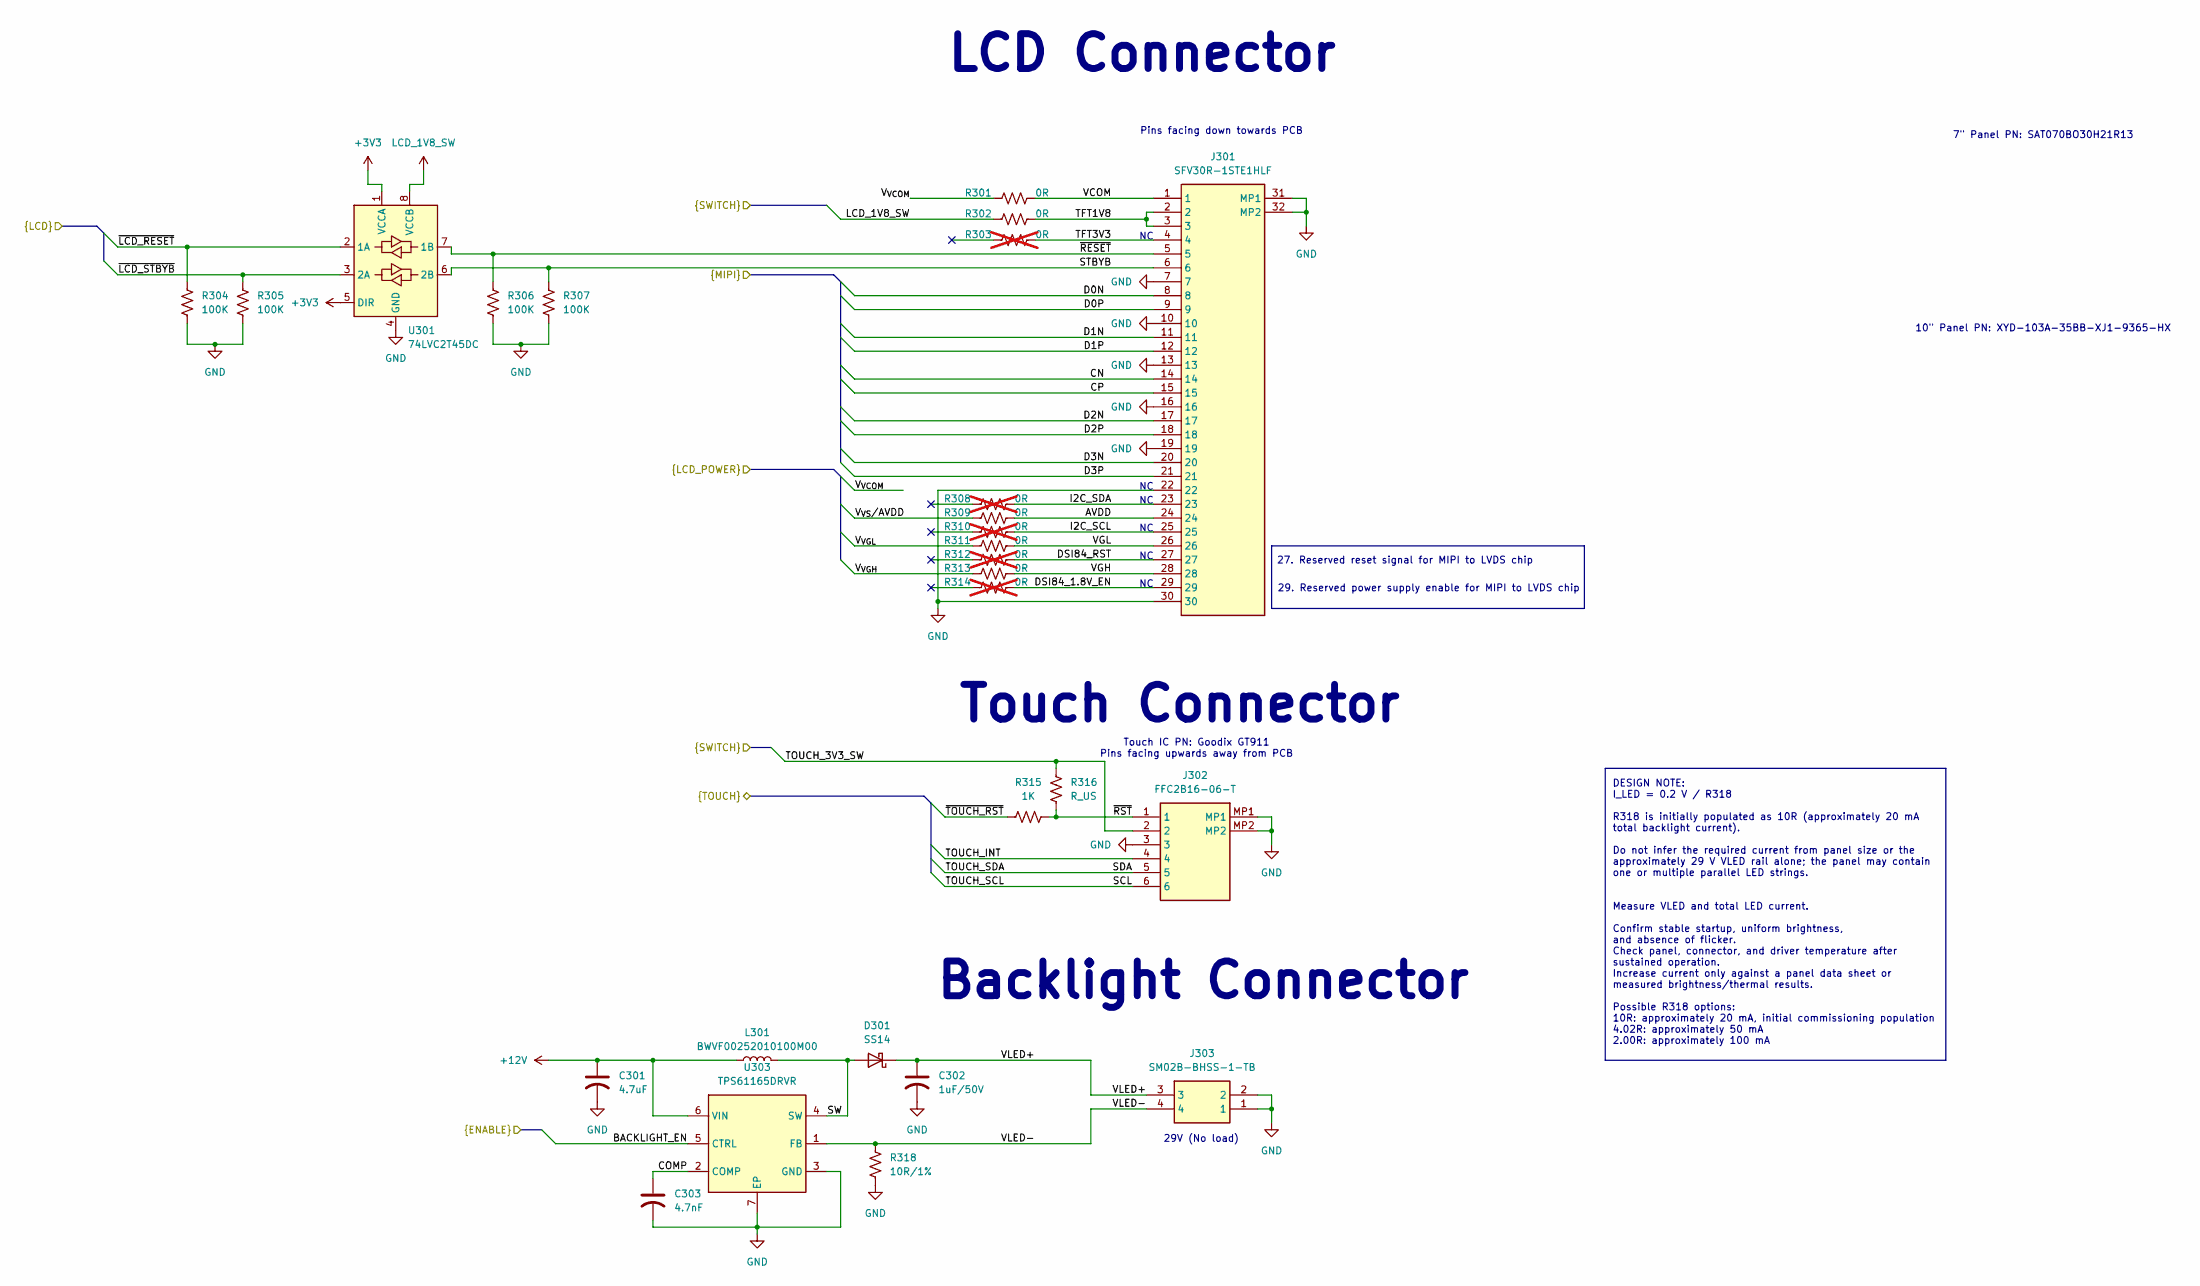
[picture p6: schematic display.kicad_sch]

Parts:
C301: 4.7uF; C_0603_1608Metric
C302: 1uF/50V; C_0603_1608Metric
C303: 4.7nF; C_0603_1608Metric
D301: SS14; D_SMA
J301: SFV30R-1STE1HLF; SFV30R1STE1HLF; Manufacturer_Part_Number SFV30R-1STE1HLF
J302: FFC2B16-06-T; FFC2B1606T; Manufacturer_Part_Number FFC2B16-06-T
J303: SM02B-BHSS-1-TB; SM02BBHSS1TBLFSN; Mouser Part Number 306-SM02BBHSS1TBLFSN
L301: BWVF00252010100M00; L_1008_2520Metric
R301, R302, R309, R311, R313: 0R; R_0603_1608Metric
R303, R308, R310, R312, R314: 0R; R_0603_1608Metric; not fitted
R304, R305, R306, R307: 100K; R_0603_1608Metric
R315: 1K; R_0603_1608Metric
R316: R_US; R_0603_1608Metric
R318: 10R/1%; R_0603_1608Metric
U301: 74LVC2T45DC; VSSOP-8_2.3x2mm_P0.5mm
U303: TPS61165DRVR; Mouser Part Number 595-TPS61165DRVR

Connections:
+3V3: U301.1 (VCCA), U301.5 (DIR)
+12V: C301.1, L301.1, U303.6 (VIN)
AVDD: J301.24, R309.1
BACKLIGHT_EN: U303.5 (CTRL)
CN: J301.14
COMP: C303.1, U303.2 (COMP)
CP: J301.15
D0N: J301.8
D0P: J301.9
D1N: J301.11
D1P: J301.12
D2N: J301.17
D2P: J301.18
D3N: J301.20
D3P: J301.21
DSI84_1.8V_EN: J301.29, R314.1
DSI84_RST: J301.27, R312.1
GND: C301.2, C302.2, C303.2, J301.7, J301.10, J301.13, J301.16, J301.19, J301.22, J301.30, J301.31 (MP1), J301.32 (MP2), J302.3, J302.MP1, J302.MP2, J303.1, J303.2, R304.2, R305.2, R306.2, R307.2, R318.2, U301.4 (GND), U303.3 (GND), U303.7 (EP)
I2C_SCL: J301.25, R310.1
I2C_SDA: J301.23, R308.1
LCD_1V8_SW: R302.2, U301.8 (VCCB)
SCL: J302.6
SDA: J302.5
STBYB: J301.6, R307.1, U301.6 (2B)
SW: D301.2 (A), L301.2, U303.4 (SW)
TFT1V8: J301.2, J301.3, R302.1
TFT3V3: J301.4, R303.1
TOUCH_3V3_SW: J302.2, R316.1
TOUCH_INT: J302.4
VCOM: J301.1, R301.1
VGH: J301.28, R313.1
VGL: J301.26, R311.1
VLED+: C302.1, D301.1 (K), J303.3
VLED-: J303.4, R318.1, U303.1 (FB)
V_{VCOM}: R301.2
V_{VGH}: R313.2
V_{VGL}: R311.2
V_{VS}/AVDD: R309.2
~LCD_RESET: R304.1, U301.2 (1A)
~LCD_STBYB: R305.1, U301.3 (2A)
~RESET: J301.5, R306.1, U301.7 (1B)
~RST: J302.1, R315.2, R316.2
~TOUCH_RST: R315.1

Notes on the sheet:
DESIGN NOTE: I_LED = 0.2 V / R318 R318 is initially populated as 10R (approximately 20 mA total backlight current). Do not infer the required current from panel size or the approximately 29 V VLED rail alone; the panel may contain one or multiple parallel LED strings. Measure VLED and total LED cur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
Pins facing down towards PCB
LCD Connector
10" Panel PN: XYD-103A-35BB-XJ1-9365-HX
27. Reserved reset signal for MIPI to LVDS chip
29. Reserved power supply enable for MIPI to LVDS chip
29V (No load)
Backlight Connector
Touch IC PN: Goodix GT911 Pins facing upwards away from PCB
7" Panel PN: SAT070BO30H21R13
Touch Connector
