mibs510/OpenXTCM5-Head-Unit/pcb/fan.kicad_sch

## KiCad design pcb/fan.kicad_sch (2026-10-04)

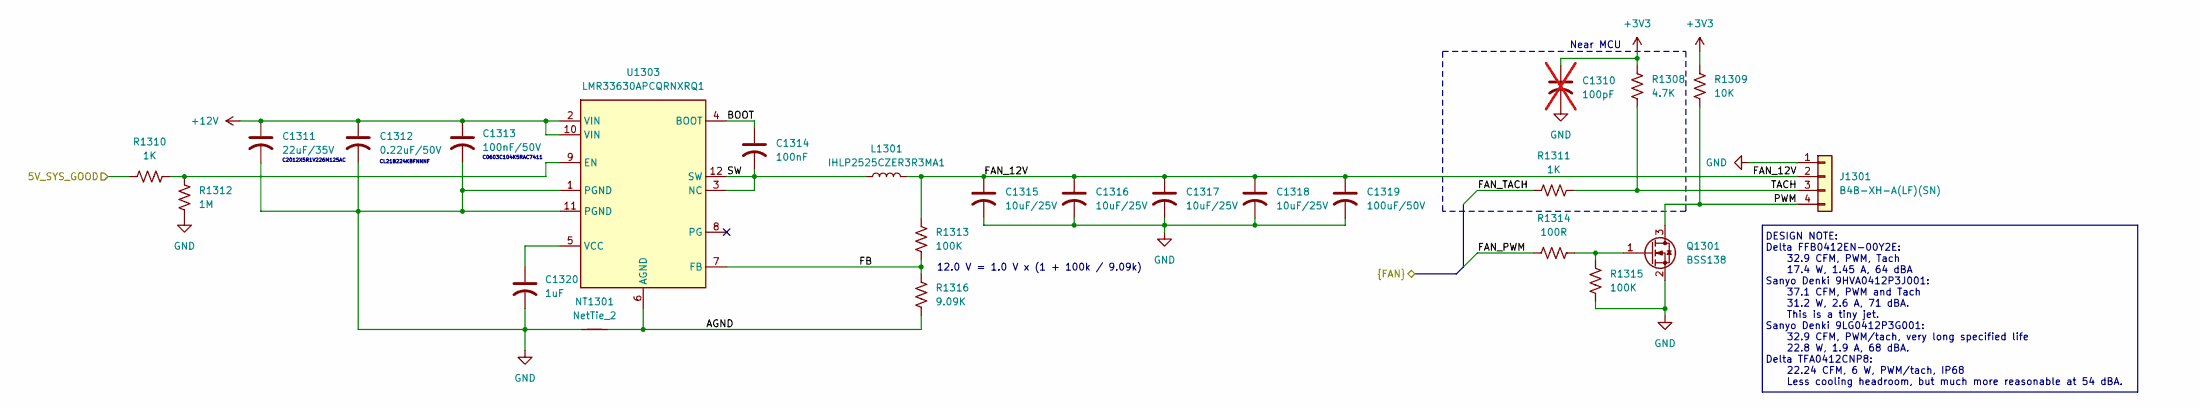
[picture p7: schematic fan.kicad_sch]

Parts:
C1310: 100pF; C_0603_1608Metric; not fitted
C1311: 22uF/35V; C_0805_2012Metric
C1312: 0.22uF/50V; C_0603_1608Metric
C1313: 100nF/50V; C_0805_2012Metric
C1314: 100nF; C_0603_1608Metric
C1315, C1316, C1317, C1318: 10uF/25V; C_0805_2012Metric
C1319: 100uF/50V; C_1206_3216Metric
C1320: 1uF; C_0805_2012Metric
J1301: B4B-XH-A(LF)(SN); JST_XH_B4B-XH-AM_1x04_P2.50mm_Vertical
L1301: IHLP2525CZER3R3MA1; INDPM6965X300N
NT1301: NetTie_2; NetTie-2_THT_Pad0.3mm
Q1301: BSS138; SOT-23
R1308: 4.7K; R_0603_1608Metric
R1309: 10K; R_0603_1608Metric
R1310, R1311: 1K; R_0603_1608Metric
R1312: 1M; R_0603_1608Metric
R1313, R1315: 100K; R_0603_1608Metric
R1314: 100R; R_0603_1608Metric
R1316: 9.09K; R_0603_1608Metric
U1303: LMR33630APCQRNXRQ1; Mouser Part Number 595-R33630APCQRNXRQ1

Connections:
5V_SYS_GOOD: R1310.1
+3V3: C1310.1, R1308.1, R1309.1
+12V: C1311.1, C1312.1, C1313.1, U1303.2 (VIN), U1303.10 (VIN)
AGND: NT1301.2, R1316.2, U1303.6 (AGND)
BOOT: C1314.1, U1303.4 (BOOT)
FAN_12V: C1315.1, C1316.1, C1317.1, C1318.1, C1319.1, J1301.2, L1301.2, R1313.1
FAN_PWM: R1314.1
FAN_TACH: R1311.1
FB: R1313.2, R1316.1, U1303.7 (FB)
GND: C1310.2, C1311.2, C1312.2, C1313.2, C1315.2, C1316.2, C1317.2, C1318.2, C1319.2, C1320.2, J1301.1, NT1301.1, Q1301.2 (S), R1312.2, R1315.2, U1303.1 (PGND), U1303.11 (PGND)
unnamed: C1320.1, U1303.5 (VCC)
unnamed: Q1301.1 (G), R1314.2, R1315.1
unnamed: R1310.2, R1312.1, U1303.9 (EN)
PWM: J1301.4, Q1301.3 (D), R1309.2
SW: C1314.2, L1301.1, U1303.3 (NC), U1303.12 (SW)
TACH: J1301.3, R1308.2, R1311.2

Notes on the sheet:
Near MCU
CL21B224KBFNNNF
C0603C104K5RAC7411
C2012X5R1V226M125AC
DESIGN NOTE: Delta FFB0412EN-00Y2E: 32.9 CFM, PWM, Tach 17.4 W, 1.45 A, 64 dBA Sanyo Denki 9HVA0412P3J001: 37.1 CFM, PWM and Tach 31.2 W, 2.6 A, 71 dBA. This is a tiny jet. Sanyo Denki 9LG0412P3G001: 32.9 CFM, PWM/tach, very long specified life 22.8 W, 1.9 A, 68 dBA. Delta TFA0412CNP8: 22.24 CFM, 6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
12.0 V = 1.0 V x (1 + 100k / 9.09k)
