mibs510/OpenXTCM5-Head-Unit/pcb/front_io.kicad_sch

## KiCad design pcb/front_io.kicad_sch (2026-10-04)

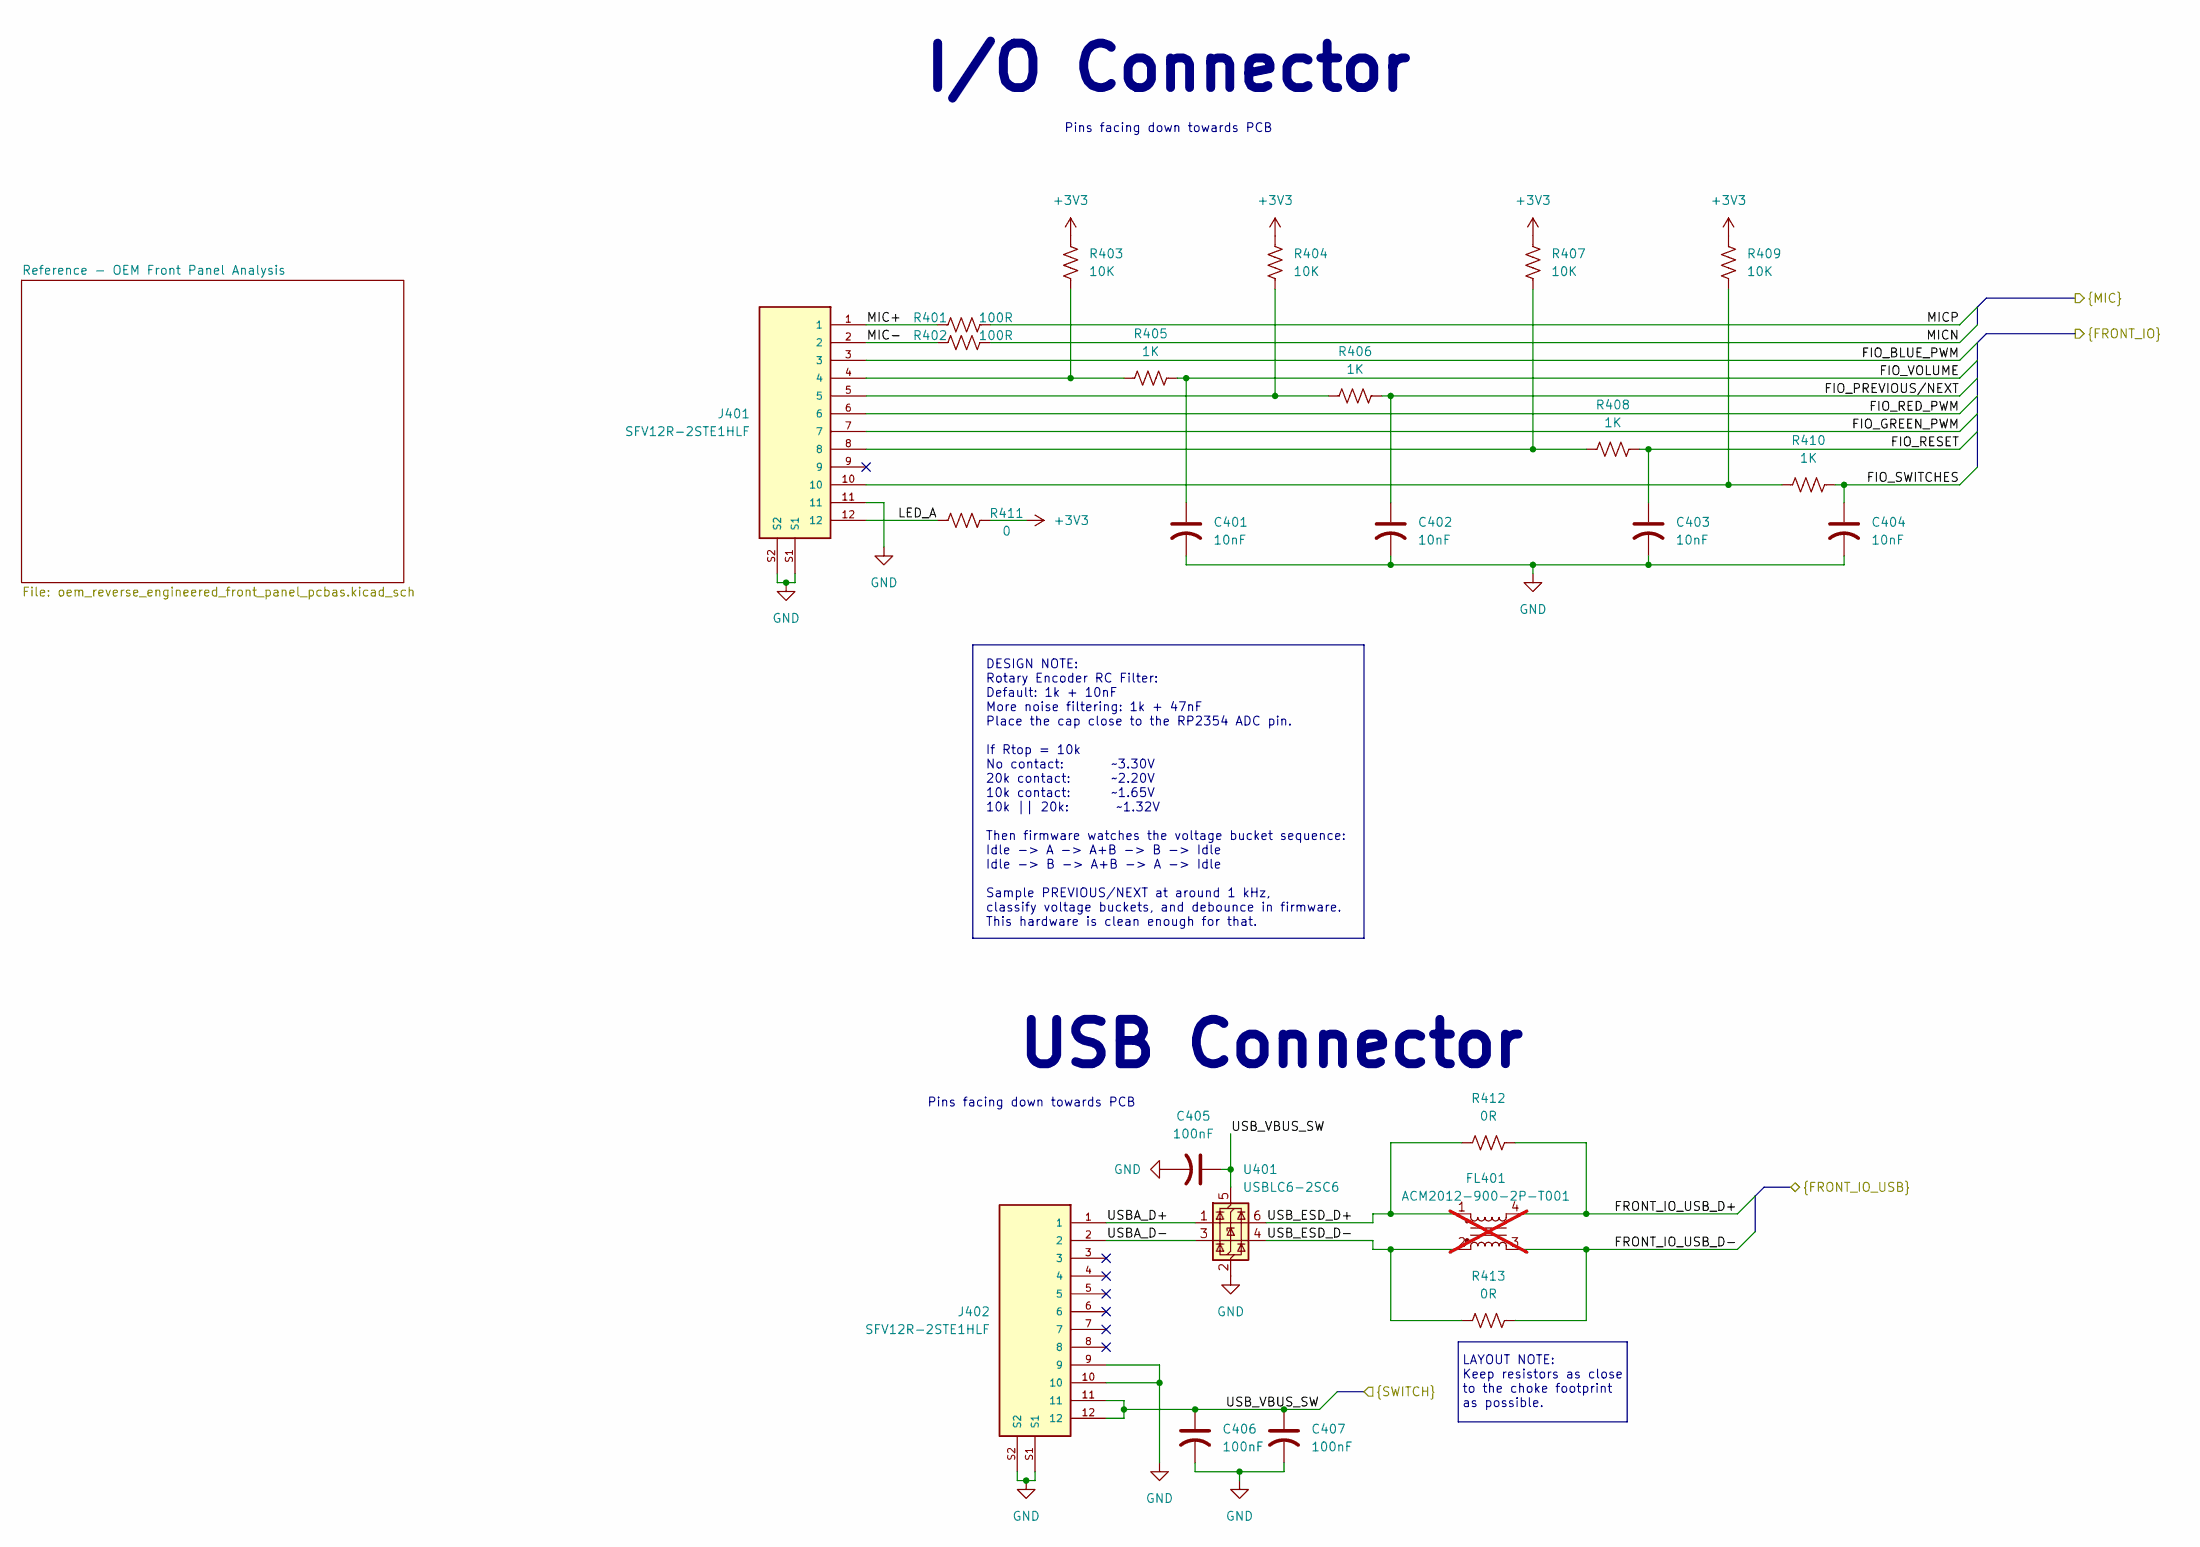
[picture p8: schematic front_io.kicad_sch]

Parts:
C401, C402, C403, C404: 10nF; C_0603_1608Metric
C405, C406, C407: 100nF; C_0603_1608Metric
FL401: ACM2012-900-2P-T001; ACM20121022PT001; Mouser Part Number 810-ACM20129002PT001; not fitted
J401, J402: SFV12R-2STE1HLF; AMPHENOL_SFV12R-2STE1HLF; PARTREV C
R401, R402: 100R; R_0603_1608Metric
R403, R404, R407, R409: 10K; R_0603_1608Metric
R405, R406, R408, R410: 1K; R_0603_1608Metric
R411: 0; R_0603_1608Metric
R412, R413: 0R; R_0603_1608Metric
U401: USBLC6-2SC6; SOT-23-6

Connections:
+3V3: R403.1, R404.1, R407.1, R409.1, R411.2
FIO_BLUE_PWM: J401.3
FIO_GREEN_PWM: J401.7
FIO_PREVIOUS/NEXT: C402.1, R406.2
FIO_RED_PWM: J401.6
FIO_RESET: C403.1, R408.2
FIO_SWITCHES: C404.1, R410.2
FIO_VOLUME: C401.1, R405.2
FRONT_IO_USB_D+: FL401.4, R412.2
FRONT_IO_USB_D-: FL401.3, R413.2
GND: C401.2, C402.2, C403.2, C404.2, C405.2, C406.2, C407.2, J401.11, J401.S1, J401.S2, J402.9, J402.10, J402.S1, J402.S2, U401.2 (GND)
LED_A: J401.12, R411.1
MIC+: J401.1, R401.1
MIC-: J401.2, R402.1
MICN: R402.2
MICP: R401.2
unnamed: J401.4, R403.2, R405.1
unnamed: J401.5, R404.2, R406.1
unnamed: J401.8, R407.2, R408.1
unnamed: J401.10, R409.2, R410.1
USBA_D+: J402.1, U401.1 (I/O1)
USBA_D-: J402.2, U401.3 (I/O2)
USB_ESD_D+: FL401.1, R412.1, U401.6 (I/O1)
USB_ESD_D-: FL401.2, R413.1, U401.4 (I/O2)
USB_VBUS_SW: C405.1, C406.1, C407.1, J402.11, J402.12, U401.5 (VBUS)

Notes on the sheet:
DESIGN NOTE: Rotary Encoder RC Filter: Default: 1k + 10nF More noise filtering: 1k + 47nF Place the cap close to the RP2354 ADC pin. If Rtop = 10k No contact: ~3.30V 20k contact: ~2.20V 10k contact: ~1.65V 10k || 20k: ~1.32V Then firmware watches the voltage bucket sequence: Idle -> A -> A+B -> B -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
LAYOUT NOTE: Keep resistors as close to the choke footprint as possible.
Pins facing down towards PCB
USB Connector
I/O Connector
