mibs510/OpenXTCM5-Head-Unit/pcb/i2s-bridge.kicad_sch

## KiCad design pcb/i2s-bridge.kicad_sch (2026-10-04)

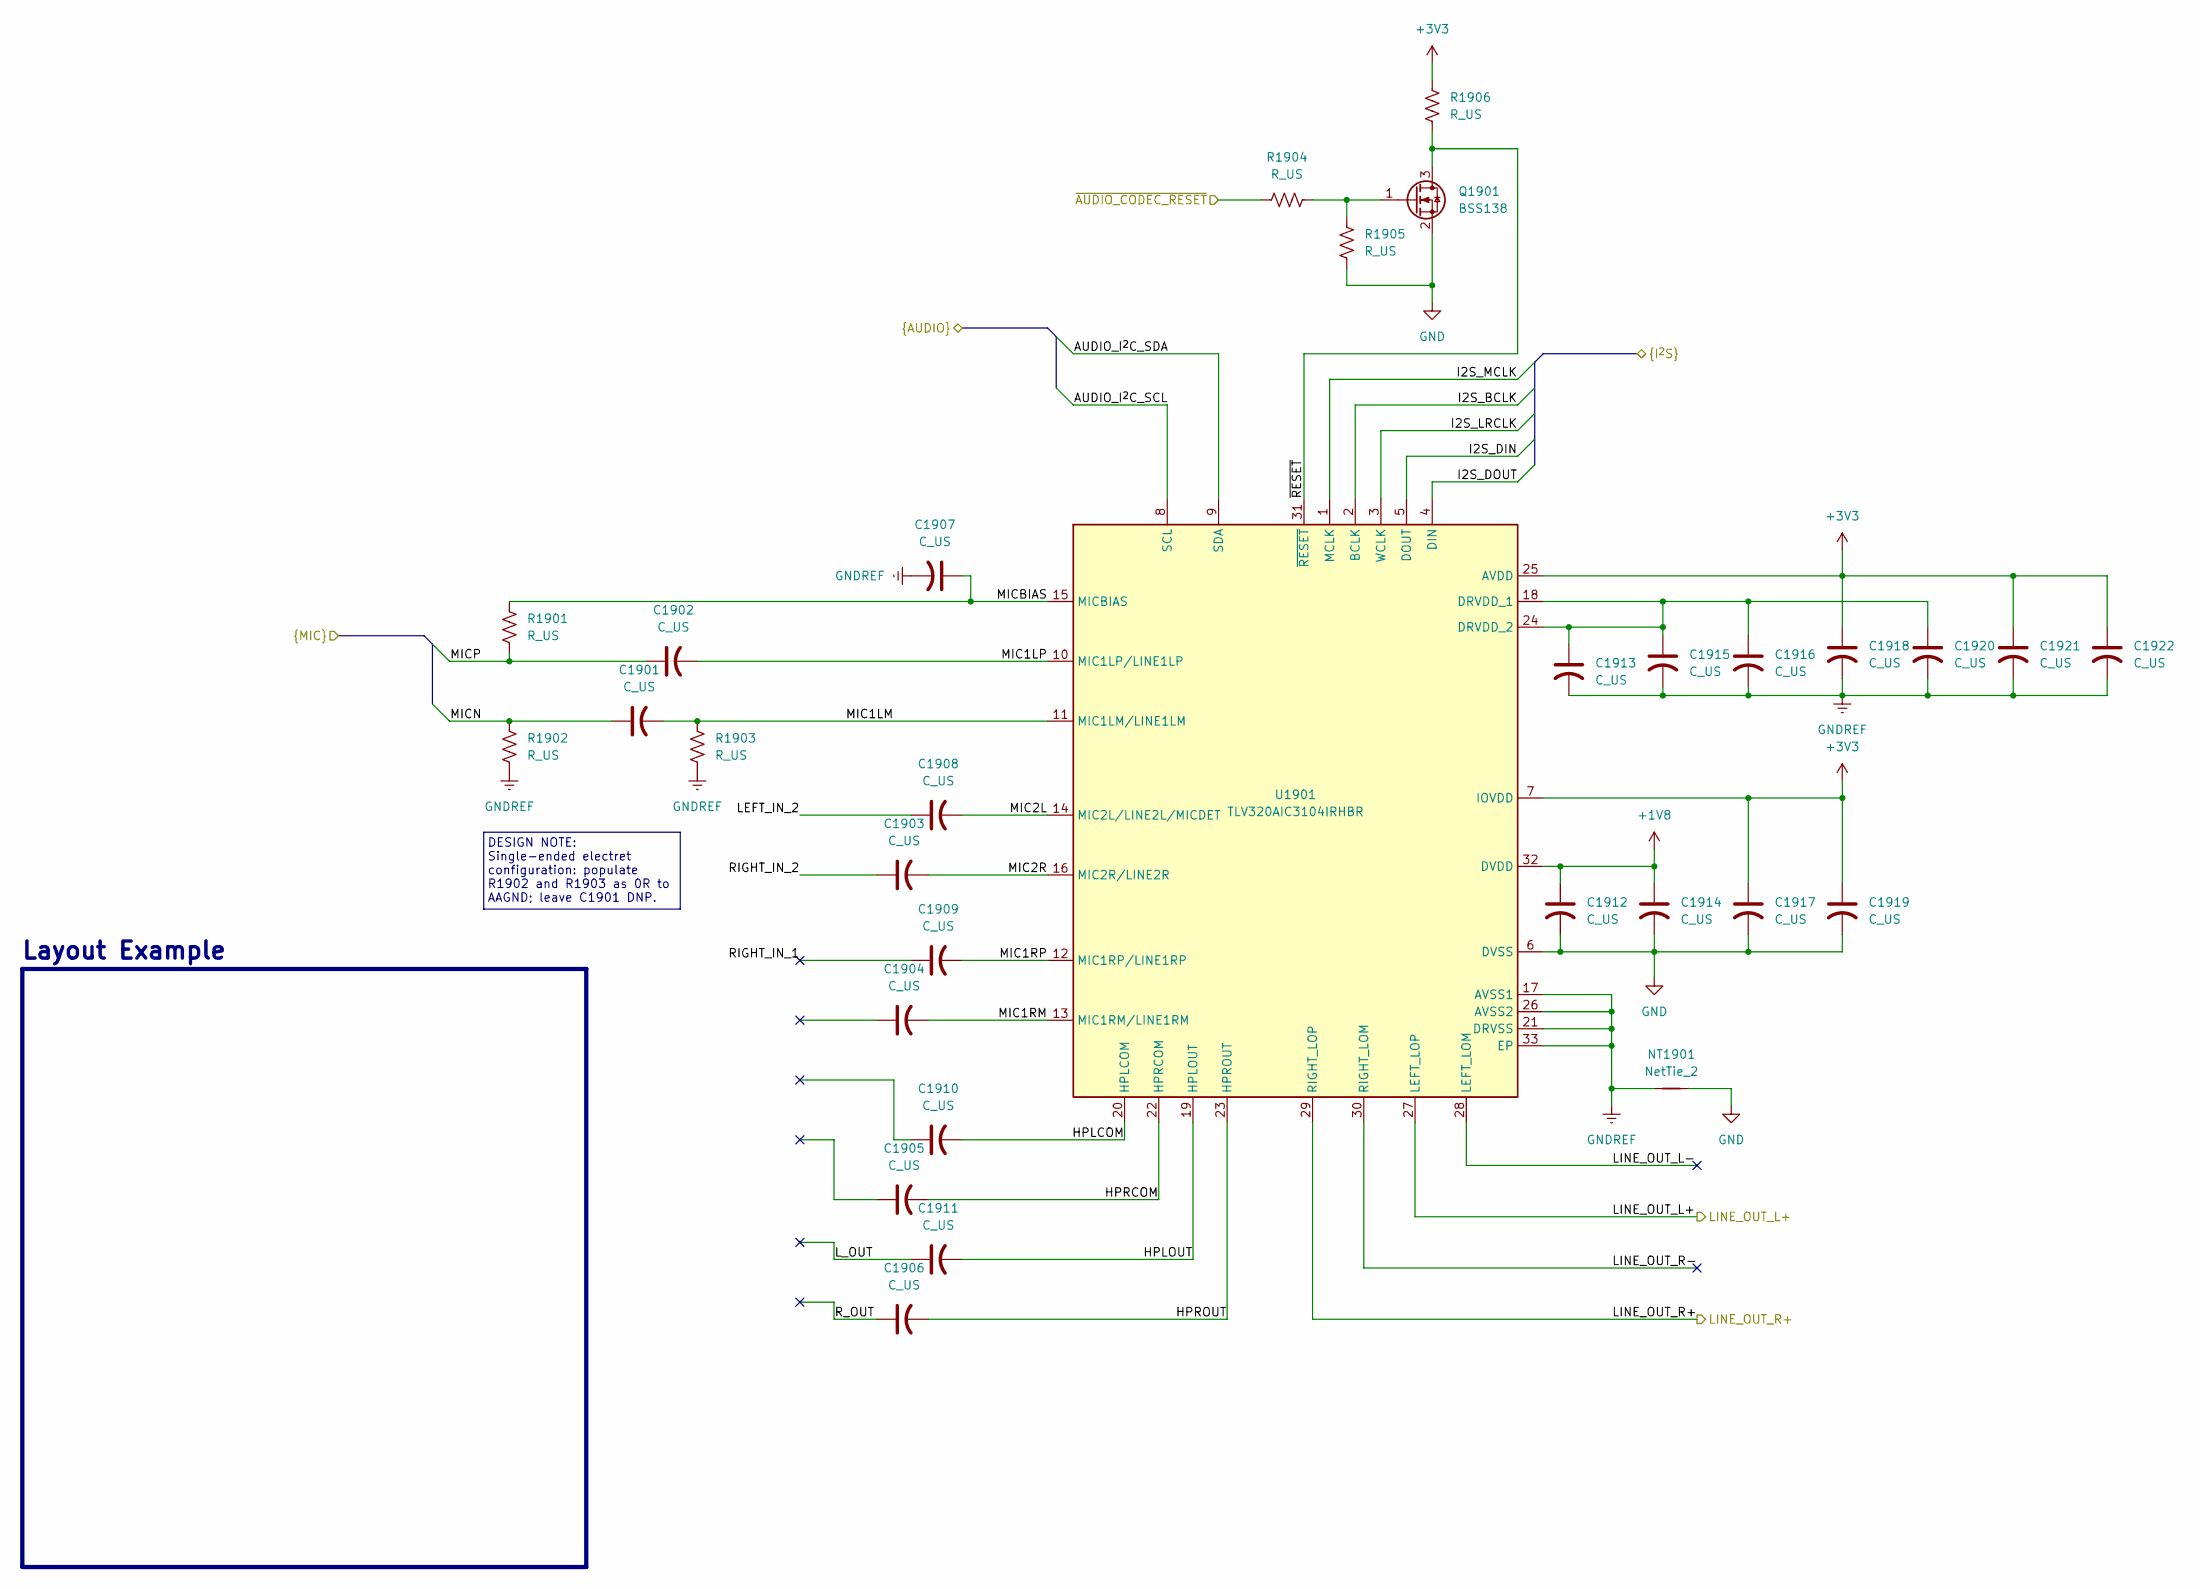
[picture p9: schematic i2s-bridge.kicad_sch]

Parts:
C1901, C1902, C1903, C1904, C1905, C1906, C1907, C1908, C1909, C1910, C1911: C_US; C_0603_1608Metric
C1912, C1913, C1914, C1915, C1916, C1917, C1918, C1919, C1920, C1921, C1922: C_US; C_0805_2012Metric
NT1901: NetTie_2; NetTie-2_THT_Pad0.3mm
Q1901: BSS138; SOT-23
R1901, R1902, R1903, R1904, R1905, R1906: R_US; R_0603_1608Metric
U1901: TLV320AIC3104IRHBR; QFN50P500X500X100-33N-D; Mouser Part Number 595-TLV320C3104IRHBR

Connections:
+1V8: C1912.1, C1914.1, U1901.32 (DVDD)
+3V3: C1917.1, C1918.1, C1919.1, C1921.1, C1922.1, R1906.2, U1901.7 (IOVDD), U1901.25 (AVDD)
AUDIO_I^{2}C_SCL: U1901.8 (SCL)
AUDIO_I^{2}C_SDA: U1901.9 (SDA)
GND: C1912.2, C1914.2, C1917.2, C1919.2, NT1901.2, Q1901.2 (S), R1905.1, U1901.6 (DVSS)
GNDREF: C1907.2, C1913.2, C1915.2, C1916.2, C1918.2, C1920.2, C1921.2, C1922.2, NT1901.1, R1902.2, R1903.2, U1901.17 (AVSS1), U1901.21 (DRVSS), U1901.26 (AVSS2), U1901.33 (EP)
HPLCOM: C1910.2, U1901.20 (HPLCOM)
HPLOUT: C1911.2, U1901.19 (HPLOUT)
HPRCOM: C1905.2, U1901.22 (HPRCOM)
HPROUT: C1906.2, U1901.23 (HPROUT)
I2S_BCLK: U1901.2 (BCLK)
I2S_DIN: U1901.5 (DOUT)
I2S_DOUT: U1901.4 (DIN)
I2S_LRCLK: U1901.3 (WCLK)
I2S_MCLK: U1901.1 (MCLK)
LEFT_IN_2: C1908.1
LINE_OUT_L+: U1901.27 (LEFT_LOP)
LINE_OUT_L-: U1901.28 (LEFT_LOM)
LINE_OUT_R+: U1901.29 (RIGHT_LOP)
LINE_OUT_R-: U1901.30 (RIGHT_LOM)
L_OUT: C1911.1
MIC1LM: C1901.2, R1903.1, U1901.11 (MIC1LM/LINE1LM)
MIC1LP: C1902.2, U1901.10 (MIC1LP/LINE1LP)
MIC1RM: C1904.2, U1901.13 (MIC1RM/LINE1RM)
MIC1RP: C1909.2, U1901.12 (MIC1RP/LINE1RP)
MIC2L: C1908.2, U1901.14 (MIC2L/LINE2L/MICDET)
MIC2R: C1903.2, U1901.16 (MIC2R/LINE2R)
MICBIAS: C1907.1, R1901.1, U1901.15 (MICBIAS)
MICN: C1901.1, R1902.1
MICP: C1902.1, R1901.2
unnamed: C1913.1, C1915.1, C1916.1, C1920.1, U1901.18 (DRVDD_1), U1901.24 (DRVDD_2)
unnamed: Q1901.1 (G), R1904.2, R1905.2
RIGHT_IN_1: C1909.1
RIGHT_IN_2: C1903.1
R_OUT: C1906.1
~AUDIO_CODEC_RESET: R1904.1
~RESET: Q1901.3 (D), R1906.1, U1901.31 (~RESET)

Notes on the sheet:
Layout Example
DESIGN NOTE: Single-ended electret configuration: populate R1902 and R1903 as 0R to AAGND; leave C1901 DNP.
