mibs510/OpenXTCM5-Head-Unit/pcb/modem.kicad_sch

## KiCad design pcb/modem.kicad_sch (2026-10-04)

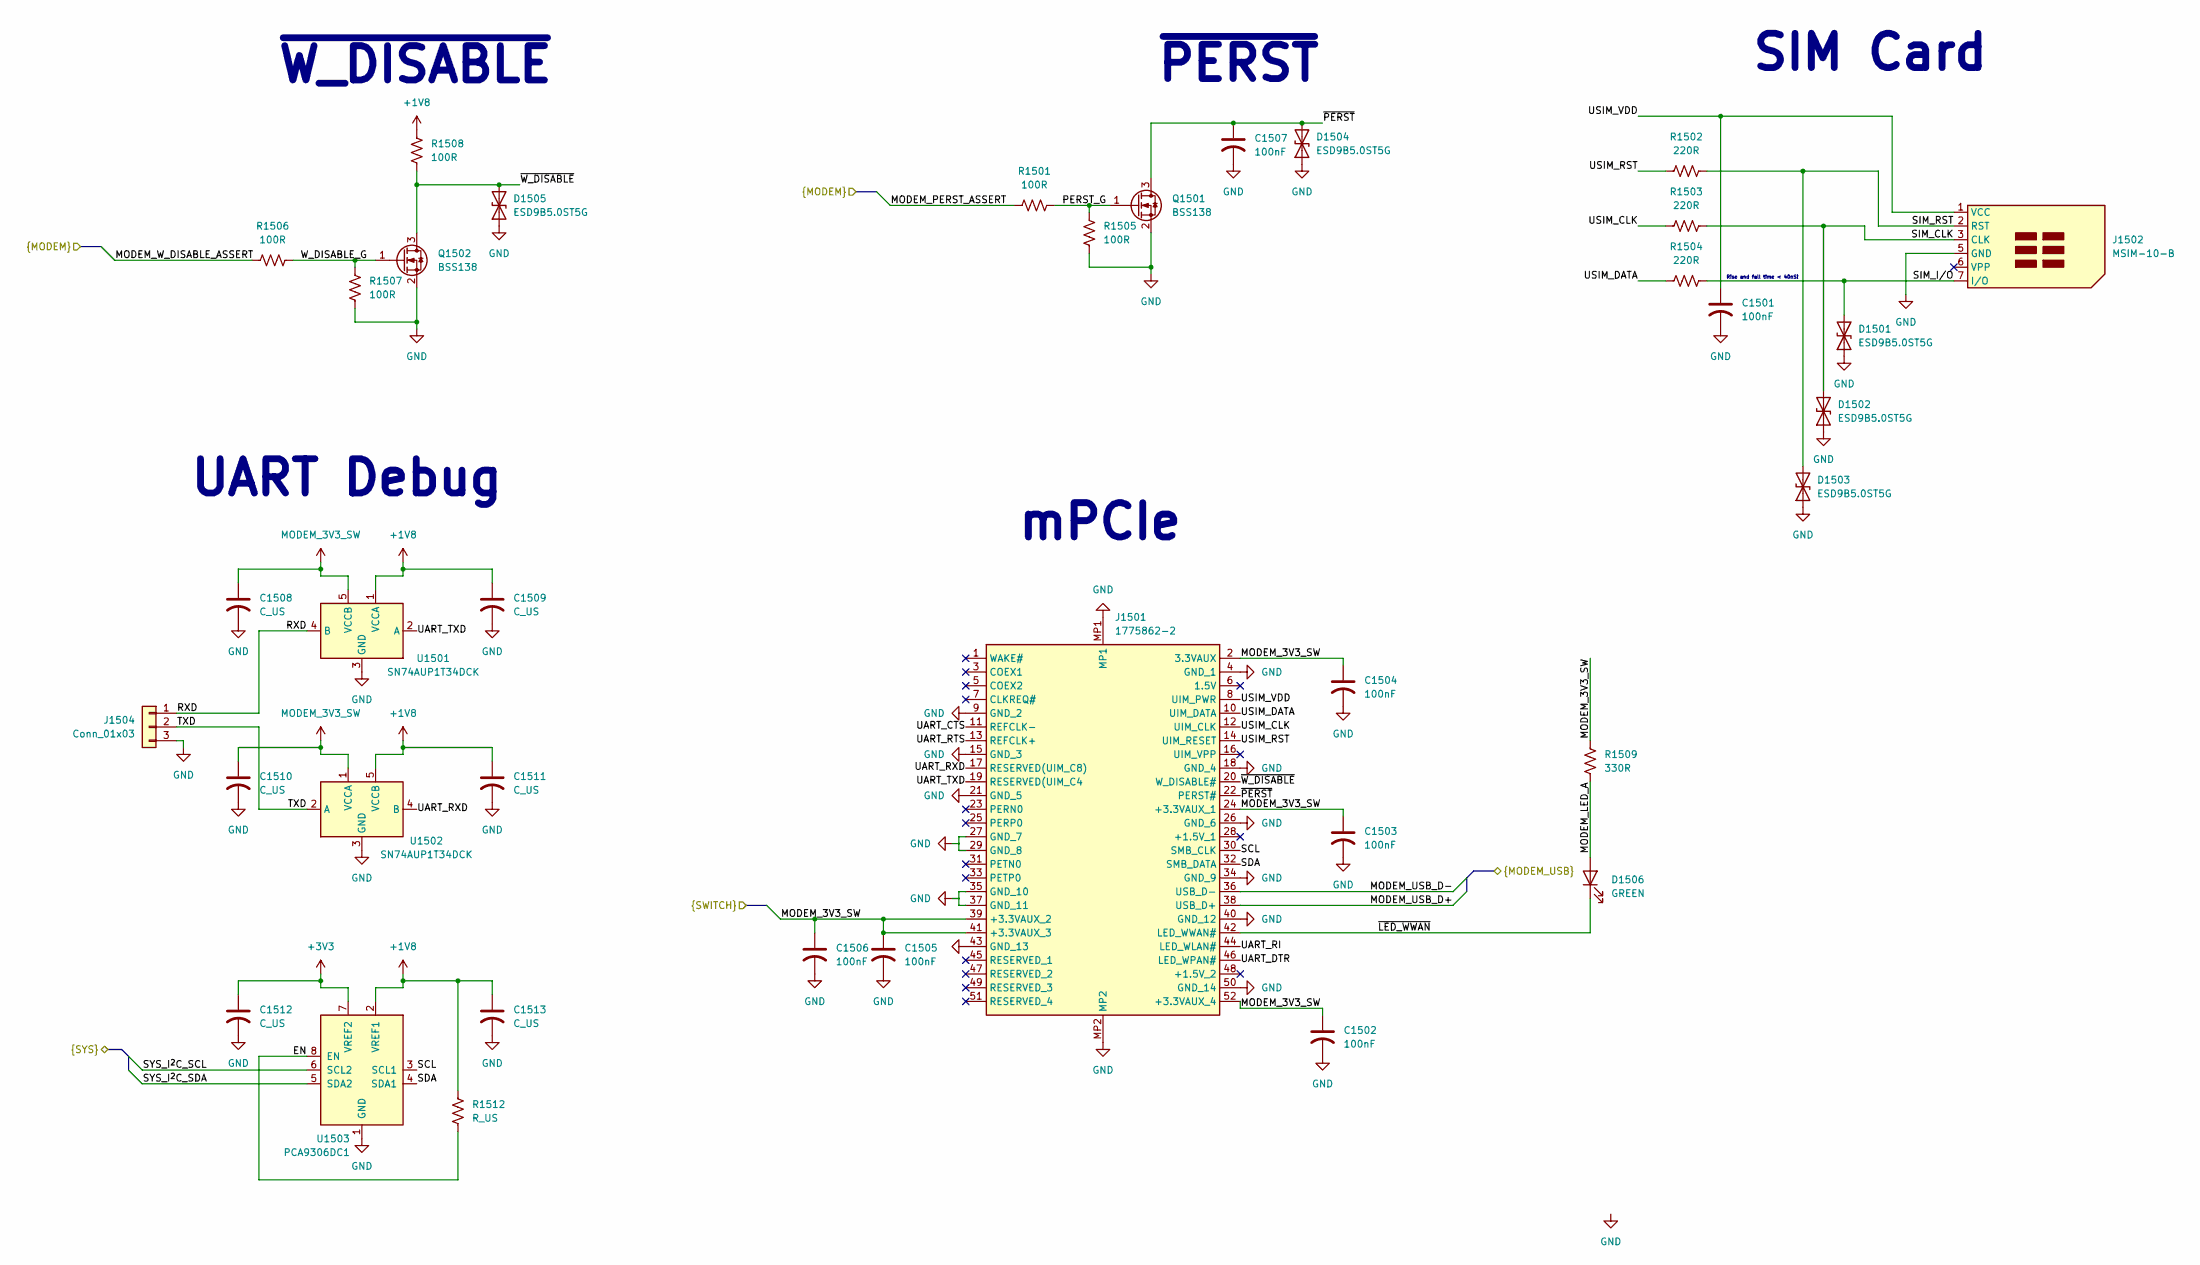
[picture p10: schematic modem.kicad_sch]

Parts:
C1501, C1502, C1503, C1504, C1505, C1506, C1507: 100nF; C_0603_1608Metric
C1508, C1509, C1510, C1511, C1512, C1513: C_US; C_0603_1608Metric
D1501, D1502, D1503, D1504, D1505: ESD9B5.0ST5G; D_SOD-923
D1506: GREEN; LED_0805_2012Metric
J1501: 1775862-2; 17758622; Mouser Part Number 571-1775862-2
J1502: MSIM-10-B; MSIM10B
J1504: Conn_01x03; JST_ZH_B3B-ZR_1x03_P1.50mm_Vertical
Q1501, Q1502: BSS138; SOT-23
R1501, R1505, R1506, R1507, R1508: 100R; R_0603_1608Metric
R1502, R1503, R1504: 220R; R_0603_1608Metric
R1509: 330R; R_0603_1608Metric
R1512: R_US; R_0603_1608Metric
U1501, U1502: SN74AUP1T34DCK; SOT-353_SC-70-5
U1503: PCA9306DC1; VSSOP-8_2.3x2mm_P0.5mm

Connections:
+1V8: C1509.1, C1511.1, C1513.1, R1508.2, R1512.2, U1501.1 (VCCA), U1502.5 (VCCB), U1503.2 (VREF1)
+3V3: C1512.1, U1503.7 (VREF2)
EN: R1512.1, U1503.8 (EN)
GND: C1501.2, C1502.2, C1503.2, C1504.2, C1505.2, C1506.2, C1507.2, C1508.2, C1509.2, C1510.2, C1511.2, C1512.2, C1513.2, D1501.1 (A1), D1502.1 (A1), D1503.1 (A1), D1504.1 (A1), D1505.1 (A1), J1501.4 (GND_1), J1501.9 (GND_2), J1501.15 (GND_3), J1501.18 (GND_4), J1501.21 (GND_5), J1501.26 (GND_6), J1501.27 (GND_7), J1501.29 (GND_8), J1501.34 (GND_9), J1501.35 (GND_10), J1501.37 (GND_11), J1501.40 (GND_12), J1501.43 (GND_13), J1501.50 (GND_14), J1501.MP1, J1501.MP2, J1502.5 (GND), J1504.3, Q1501.2 (S), Q1502.2 (S), R1505.1, R1507.1, U1501.3 (GND), U1502.3 (GND), U1503.1 (GND)
MODEM_3V3_SW: C1502.1, C1503.1, C1504.1, C1505.1, C1506.1, C1508.1, C1510.1, J1501.2 (3.3VAUX), J1501.24 (+3.3VAUX_1), J1501.39 (+3.3VAUX_2), J1501.41 (+3.3VAUX_3), J1501.52 (+3.3VAUX_4), R1509.1, U1501.5 (VCCB), U1502.1 (VCCA)
MODEM_LED_A: D1506.2 (A), R1509.2
MODEM_PERST_ASSERT: R1501.1
MODEM_USB_D+: J1501.38 (USB_D+)
MODEM_USB_D-: J1501.36 (USB_D-)
MODEM_W_DISABLE_ASSERT: R1506.1
PERST_G: Q1501.1 (G), R1501.2, R1505.2
RXD: J1504.1, U1501.4 (B)
SCL: J1501.30 (SMB_CLK), U1503.3 (SCL1)
SDA: J1501.32 (SMB_DATA), U1503.4 (SDA1)
SIM_CLK: D1502.2 (A2), J1502.3 (CLK), R1503.2
SIM_I/O: D1501.2 (A2), J1502.7 (I/O), R1504.2
SIM_RST: D1503.2 (A2), J1502.2 (RST), R1502.2
SYS_I^{2}C_SCL: U1503.6 (SCL2)
SYS_I^{2}C_SDA: U1503.5 (SDA2)
TXD: J1504.2, U1502.2 (A)
UART_CTS: J1501.11 (REFCLK-)
UART_DTR: J1501.46 (LED_WPAN#)
UART_RI: J1501.44 (LED_WLAN#)
UART_RTS: J1501.13 (REFCLK+)
UART_RXD: J1501.17 (RESERVED(UIM_C8)), U1502.4 (B)
UART_TXD: J1501.19 (RESERVED(UIM_C4), U1501.2 (A)
USIM_CLK: J1501.12 (UIM_CLK), R1503.1
USIM_DATA: J1501.10 (UIM_DATA), R1504.1
USIM_RST: J1501.14 (UIM_RESET), R1502.1
USIM_VDD: C1501.1, J1501.8 (UIM_PWR), J1502.1 (VCC)
W_DISABLE_G: Q1502.1 (G), R1506.2, R1507.2
~LED_WWAN: D1506.1 (K), J1501.42 (LED_WWAN#)
~PERST: C1507.1, D1504.2 (A2), J1501.22 (PERST#), Q1501.3 (D)
~W_DISABLE: D1505.2 (A2), J1501.20 (W_DISABLE#), Q1502.3 (D), R1508.1

Notes on the sheet:
Rise and fall time < 40nS!
mPCIe
UART Debug
~{PERST}
~{W_DISABLE}
SIM Card
