mibs510/OpenXTCM5-Head-Unit/pcb/oem_reverse_engineered_front_panel_pcbas.kicad_sch

## KiCad design pcb/oem_reverse_engineered_front_panel_pcbas.kicad_sch (2026-10-04)

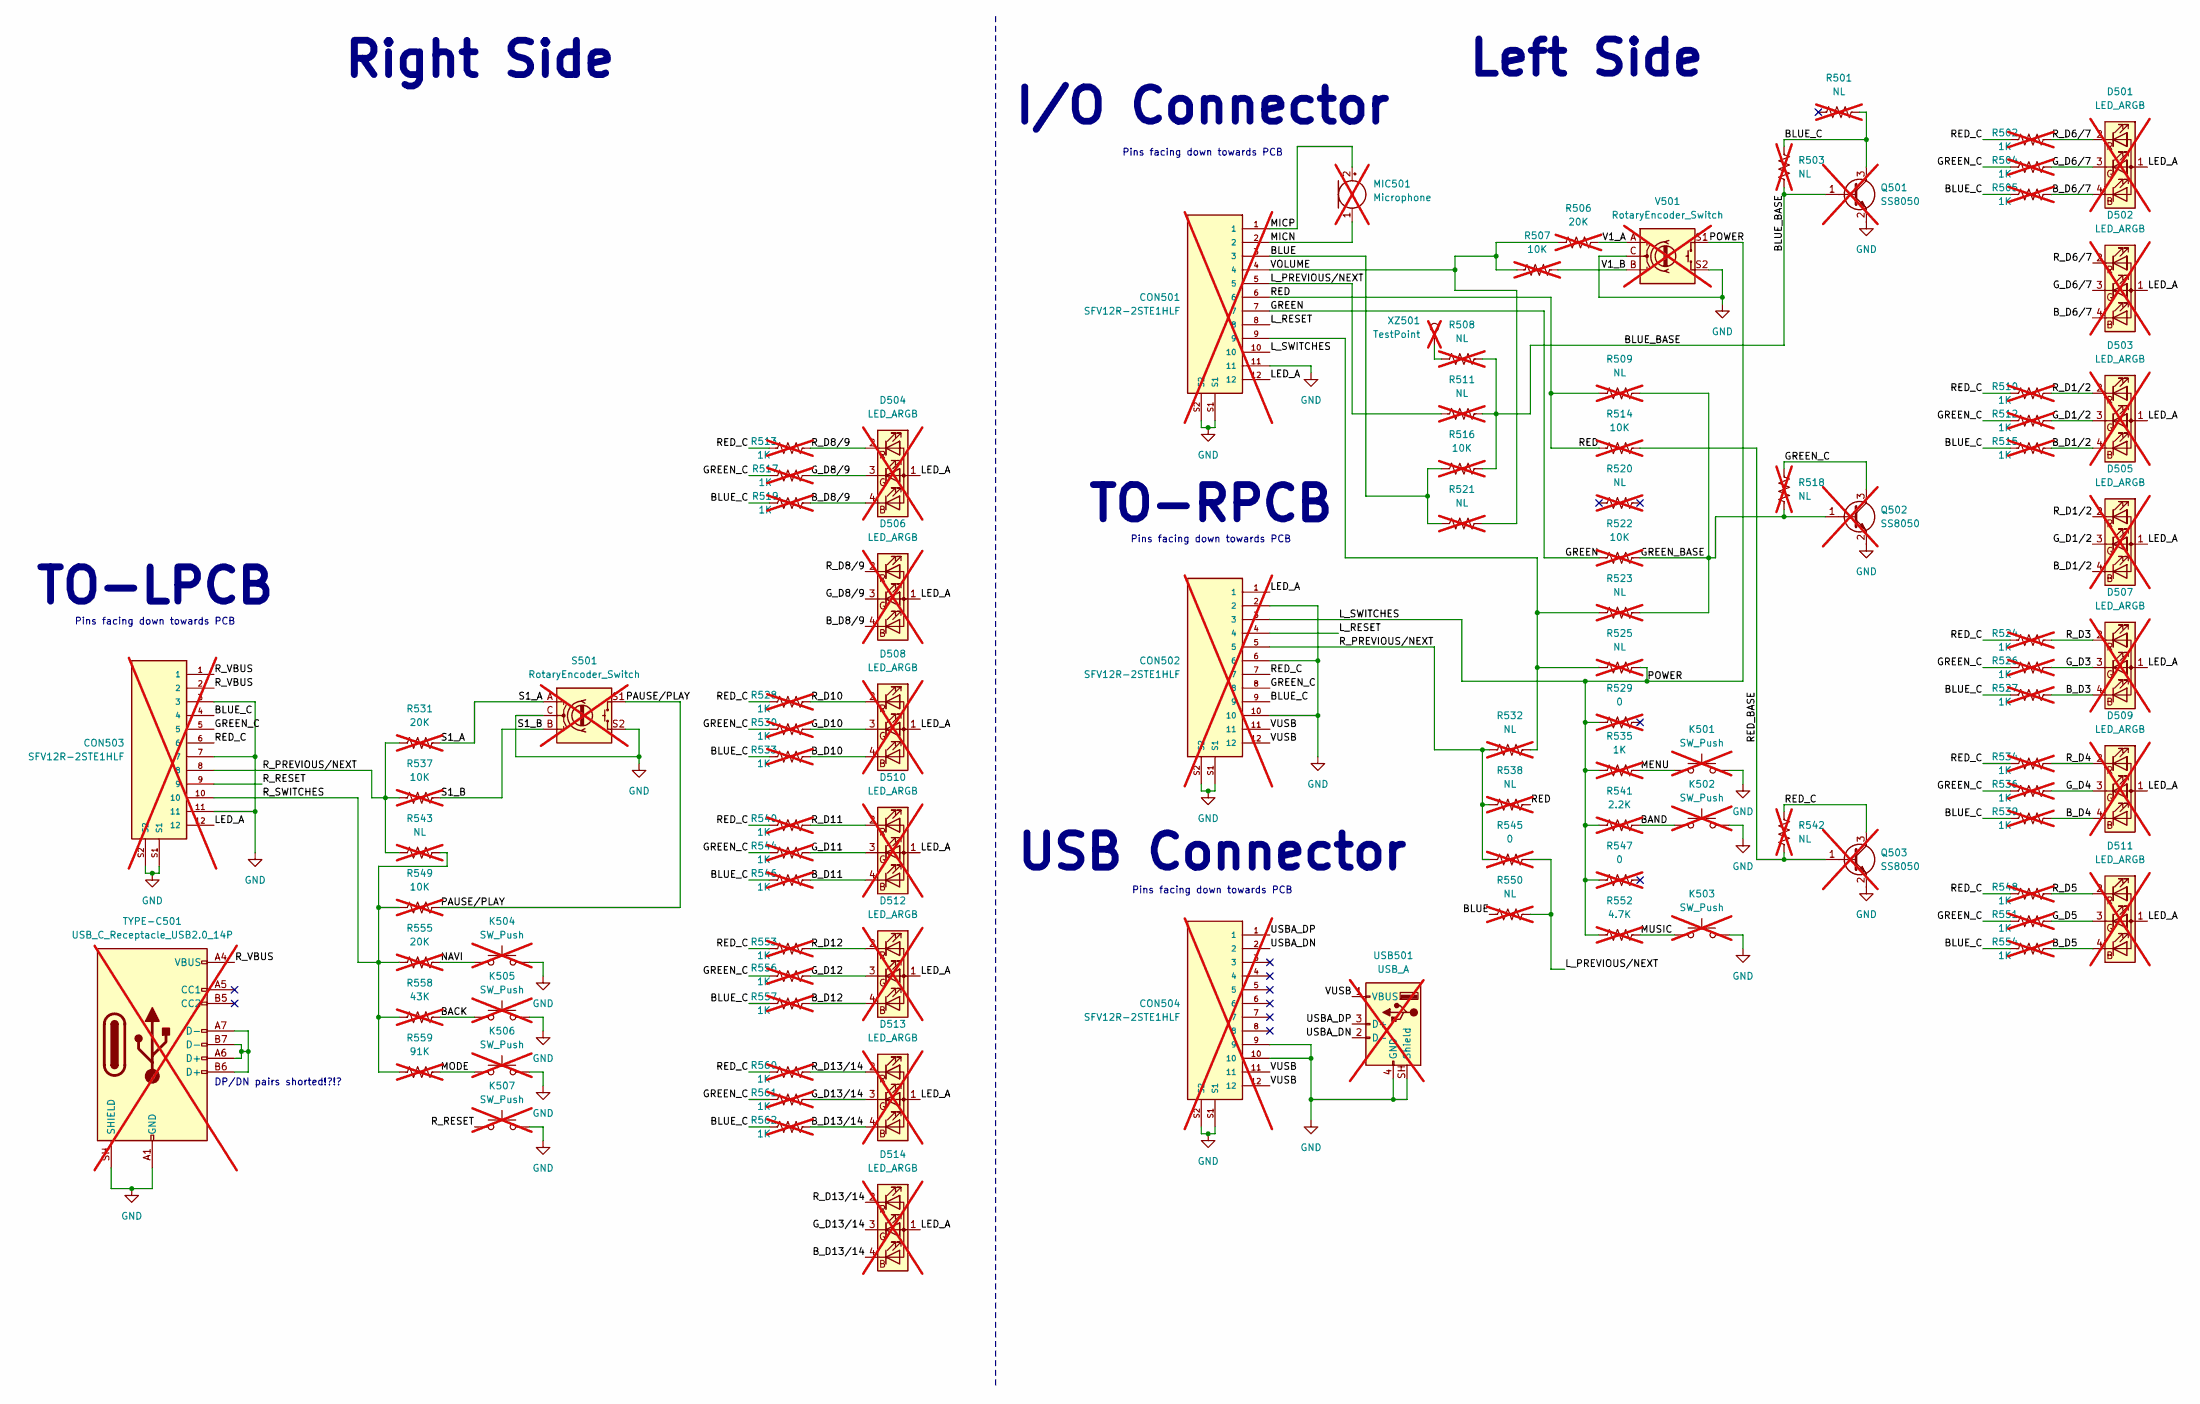
[picture p11: schematic oem_reverse_engineered_front_panel_pcbas.kicad_sch]

Parts:
CON501, CON502, CON503, CON504: SFV12R-2STE1HLF; AMPHENOL_SFV12R-2STE1HLF; PARTREV C; not fitted
D501, D502, D503, D504, D505, D506, D507, D508, D509, D510, D511, D512, D513, D514: LED_ARGB; not fitted
K501, K502, K503, K504, K505, K506, K507: SW_Push; not fitted
MIC501: Microphone; not fitted
Q501, Q502, Q503: SS8050; SOT-23; not fitted
R501, R503, R508, R509, R511, R518, R520, R521, R523, R525, R532, R538, R542, R543, R550: NL; not fitted
R502, R504, R505, R510, R512, R513, R515, R517, R519, R524, R526, R527, R528, R530, R533, R534, R535, R536, R539, R540, R544, R546, R548, R551, R553, R554, R556, R557, R560, R561, R562: 1K; not fitted
R506, R531, R555: 20K; not fitted
R507, R514, R516, R522, R537, R549: 10K; not fitted
R529, R545, R547: 0; not fitted
R541: 2.2K; not fitted
R552: 4.7K; not fitted
R558: 43K; not fitted
R559: 91K; not fitted
S501: RotaryEncoder_Switch; not fitted
TYPE-C501: USB_C_Receptacle_USB2.0_14P; USB_C_Receptacle_G-Switch_GT-USB-7051x; not fitted
USB501: USB_A; not fitted
V501: RotaryEncoder_Switch; not fitted
XZ501: TestPoint; not fitted

Connections:
BACK: K505.1, R558.2
BAND: K502.1, R541.2
BLUE: CON501.3, R516.1, R521.1, R550.1
BLUE_BASE: Q501.1 (B), R503.2, R508.2, R511.2, R516.2
BLUE_C: CON502.9, CON503.4, Q501.3 (C), R501.1, R503.1, R505.1, R515.1, R519.1, R527.1, R533.1, R539.1, R546.1, R554.1, R557.1, R562.1
B_D1/2: D503.4 (BK), D505.4 (BK), R515.2
B_D3: D507.4 (BK), R527.2
B_D4: D509.4 (BK), R539.2
B_D5: D511.4 (BK), R554.2
B_D6/7: D501.4 (BK), D502.4 (BK), R505.2
B_D8/9: D504.4 (BK), D506.4 (BK), R519.2
B_D10: D508.4 (BK), R533.2
B_D11: D510.4 (BK), R546.2
B_D12: D512.4 (BK), R557.2
B_D13/14: D513.4 (BK), D514.4 (BK), R562.2
GND: CON501.11, CON501.S1, CON501.S2, CON502.2, CON502.6, CON502.10, CON502.S1, CON502.S2, CON503.3, CON503.7, CON503.11, CON503.S1, CON503.S2, CON504.9, CON504.10, CON504.S1, CON504.S2, K501.2, K502.2, K503.2, K504.2, K505.2, K506.2, K507.2, Q501.2 (E), Q502.2 (E), Q503.2 (E), S501.C, S501.S2, TYPE-C501.A1 (GND), TYPE-C501.A12 (GND), TYPE-C501.B1 (GND), TYPE-C501.B12 (GND), TYPE-C501.SH (SHIELD), USB501.4 (GND), USB501.SH (Shield), V501.C, V501.S2
GREEN: CON501.7, R522.1
GREEN_BASE: Q502.1 (B), R509.2, R518.2, R522.2, R523.2
GREEN_C: CON502.8, CON503.5, Q502.3 (C), R504.1, R512.1, R517.1, R518.1, R526.1, R530.1, R536.1, R544.1, R551.1, R556.1, R561.1
G_D1/2: D503.3 (GK), D505.3 (GK), R512.2
G_D3: D507.3 (GK), R526.2
G_D4: D509.3 (GK), R536.2
G_D5: D511.3 (GK), R551.2
G_D6/7: D501.3 (GK), D502.3 (GK), R504.2
G_D8/9: D504.3 (GK), D506.3 (GK), R517.2
G_D10: D508.3 (GK), R530.2
G_D11: D510.3 (GK), R544.2
G_D12: D512.3 (GK), R556.2
G_D13/14: D513.3 (GK), D514.3 (GK), R561.2
LED_A: CON501.12, CON502.1, CON503.12, D501.1 (A), D502.1 (A), D503.1 (A), D504.1 (A), D505.1 (A), D506.1 (A), D507.1 (A), D508.1 (A), D509.1 (A), D510.1 (A), D511.1 (A), D512.1 (A), D513.1 (A), D514.1 (A)
L_PREVIOUS/NEXT: CON501.5, R511.1, R545.2, R550.2
L_RESET: CON501.8, CON502.4
L_SWITCHES: CON501.10, CON502.3, R525.2, R529.1, R535.1, R541.1, R547.1, R552.1, V501.S1
MENU: K501.1, R535.2
MICN: CON501.2, MIC501.1 (-)
MICP: CON501.1, MIC501.2 (+)
MODE: K506.1, R559.2
MUSIC: K503.1, R552.2
NAVI: K504.1, R555.2
unnamed: CON501.9, R523.1, R525.1, R532.2
unnamed: R508.1, XZ501.1
unnamed: TYPE-C501.A6 (D+), TYPE-C501.A7 (D-), TYPE-C501.B6 (D+), TYPE-C501.B7 (D-)
PAUSE/PLAY: R549.2, S501.S1
RED: CON501.6, R509.1, R514.1, R538.2
RED_BASE: Q503.1 (B), R514.2, R542.2
RED_C: CON502.7, CON503.6, Q503.3 (C), R502.1, R510.1, R513.1, R524.1, R528.1, R534.1, R540.1, R542.1, R548.1, R553.1, R560.1
R_D1/2: D503.2 (RK), D505.2 (RK), R510.2
R_D3: D507.2 (RK), R524.2
R_D4: D509.2 (RK), R534.2
R_D5: D511.2 (RK), R548.2
R_D6/7: D501.2 (RK), D502.2 (RK), R502.2
R_D8/9: D504.2 (RK), D506.2 (RK), R513.2
R_D10: D508.2 (RK), R528.2
R_D11: D510.2 (RK), R540.2
R_D12: D512.2 (RK), R553.2
R_D13/14: D513.2 (RK), D514.2 (RK), R560.2
R_PREVIOUS/NEXT: CON502.5, CON503.8, R531.1, R532.1, R537.1, R538.1, R543.1, R545.1
R_RESET: CON503.9, K507.1
R_SWITCHES: CON503.10, R543.2, R549.1, R555.1, R558.1, R559.1
R_VBUS: CON503.1, CON503.2, TYPE-C501.A4 (VBUS), TYPE-C501.A9 (VBUS), TYPE-C501.B4 (VBUS), TYPE-C501.B9 (VBUS)
S1_A: R531.2, S501.A
S1_B: R537.2, S501.B
USBA_DN: CON504.2, USB501.2 (D-)
USBA_DP: CON504.1, USB501.3 (D+)
V1_A: R506.2, V501.A
V1_B: R507.2, V501.B
VOLUME: CON501.4, R506.1, R507.1, R521.2
VUSB: CON502.11, CON502.12, CON504.11, CON504.12, USB501.1 (VBUS)

Notes on the sheet:
Pins facing down towards PCB
Left Side
I/O Connector
TO-LPCB
DP/DN pairs shorted!?!?
USB Connector
TO-RPCB
Right Side
