mibs510/OpenXTCM5-Head-Unit/pcb/power-rails.kicad_sch

## KiCad design pcb/power-rails.kicad_sch (2026-10-04)

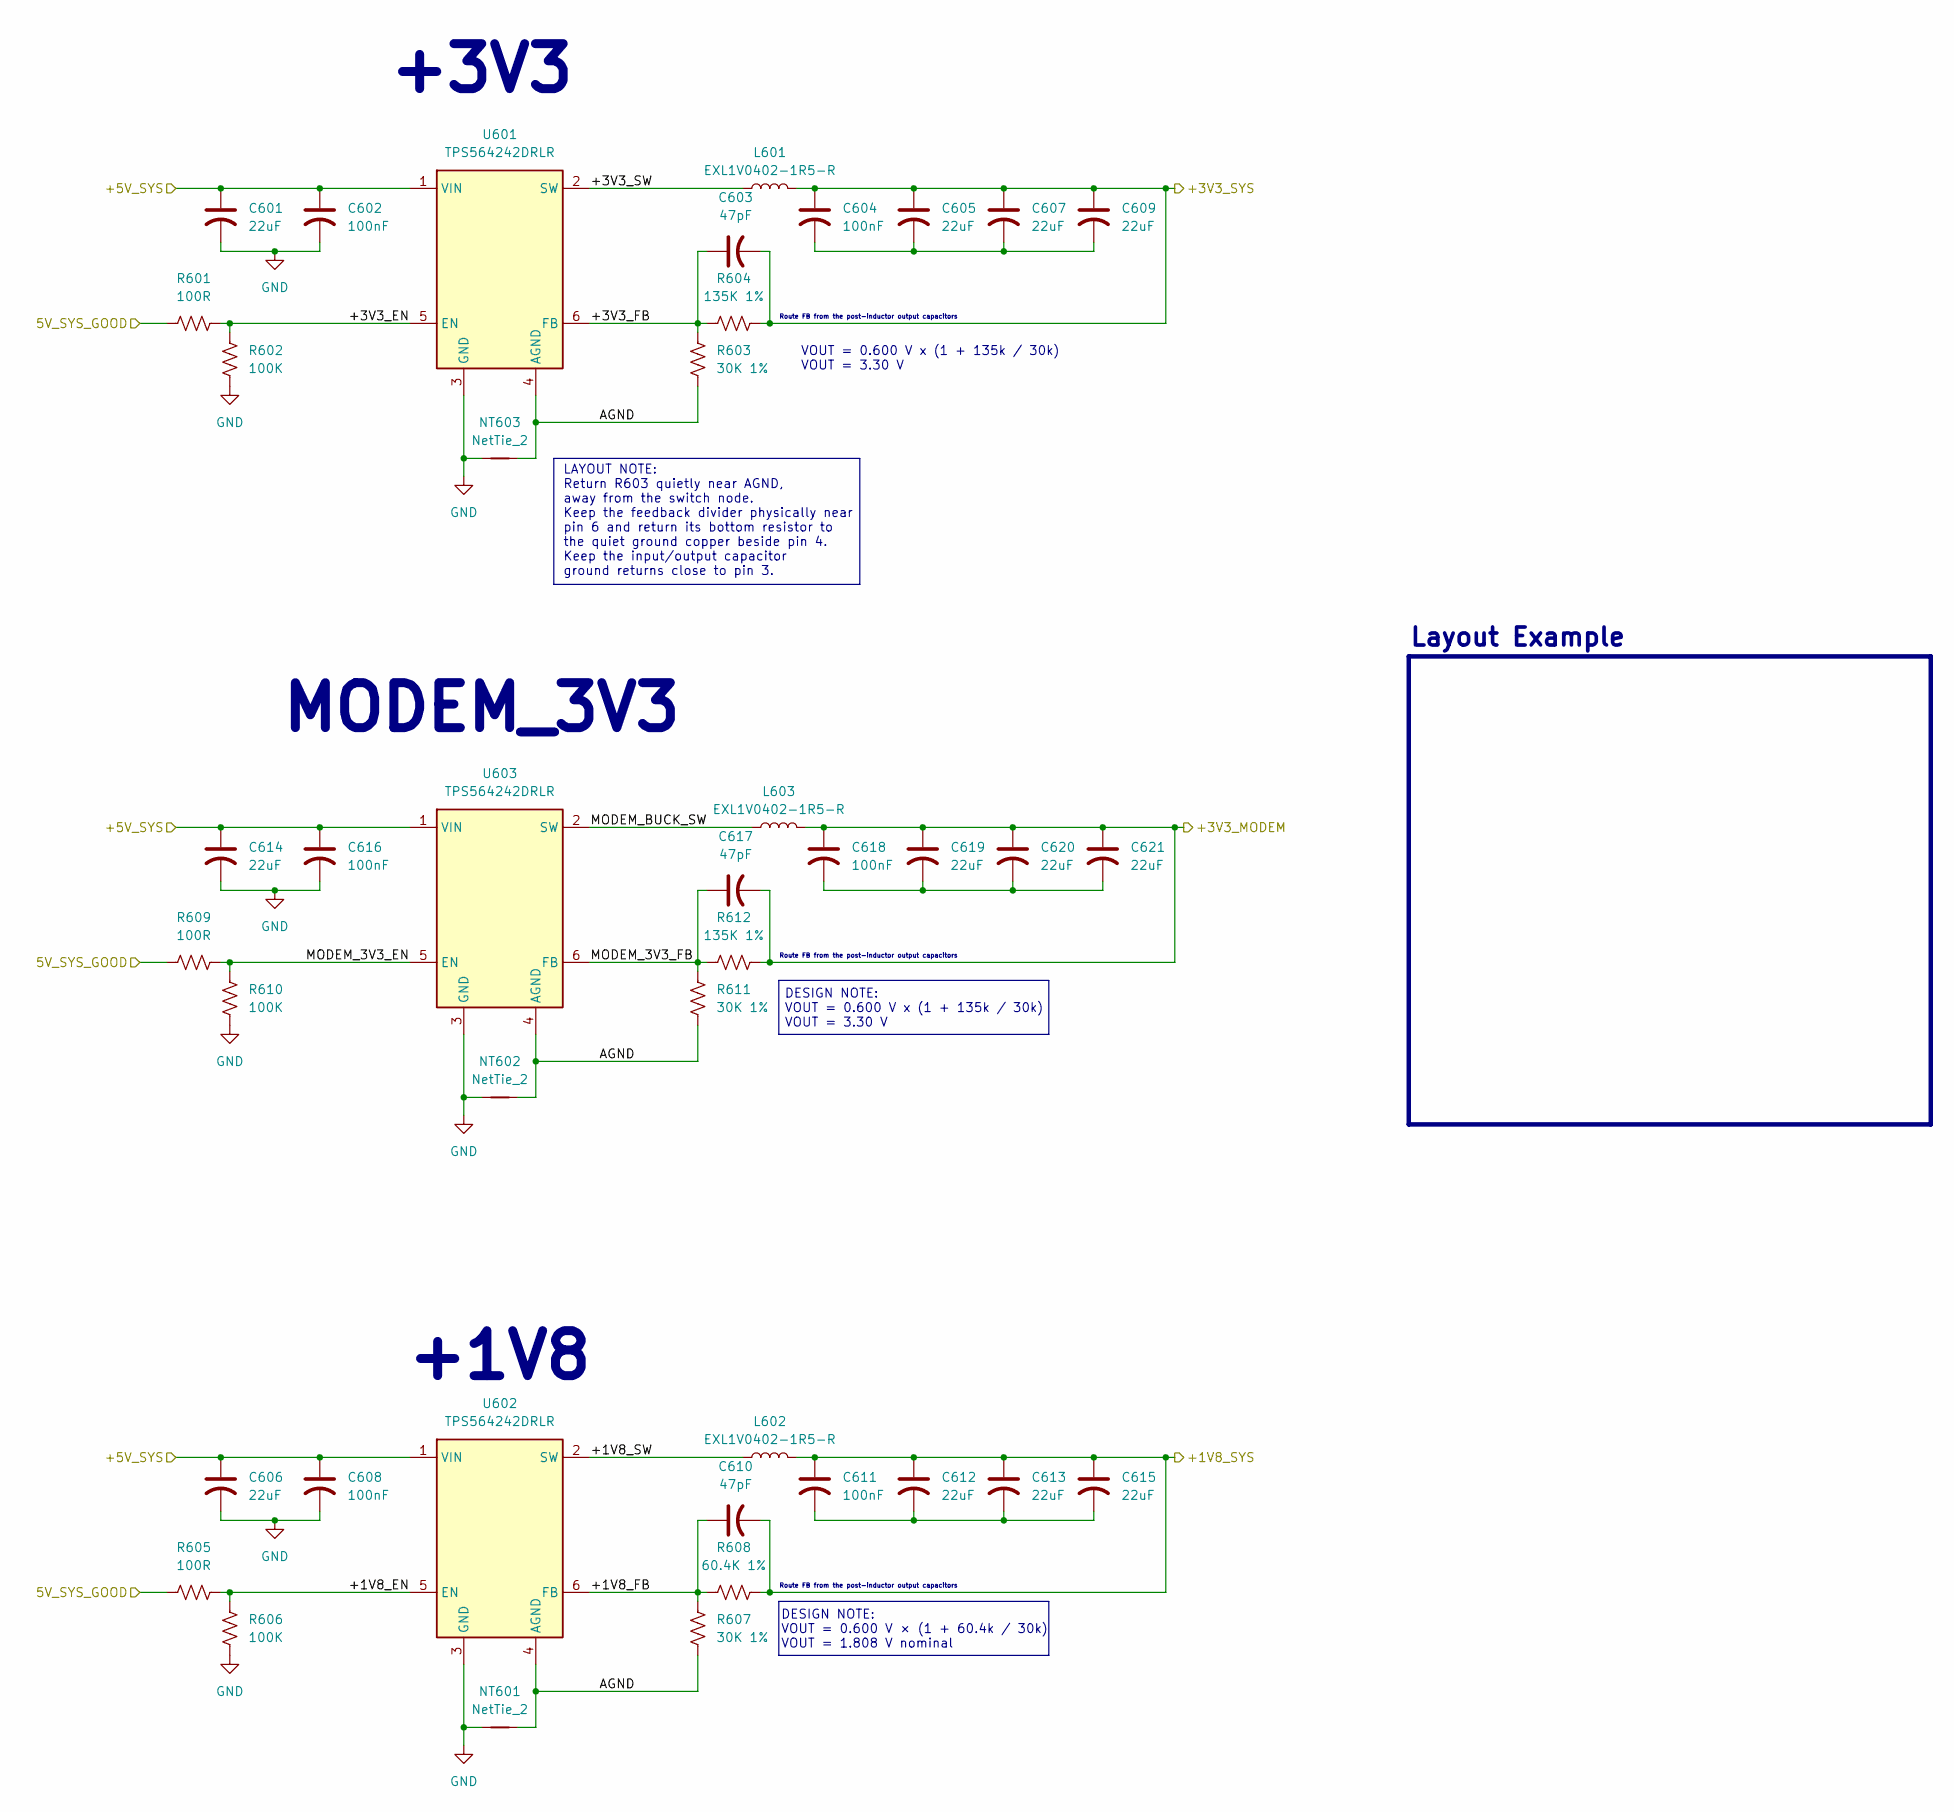
[picture p12: schematic power-rails.kicad_sch]

Parts:
C601, C605, C606, C607, C609, C612, C613, C614, C615, C619, C620, C621: 22uF; C_0805_2012Metric
C602, C604, C608, C611, C616, C618: 100nF; C_0603_1608Metric
C603, C610, C617: 47pF; C_0603_1608Metric
L601, L602, L603: EXL1V0402-1R5-R
NT601, NT602, NT603: NetTie_2; NetTie-2_THT_Pad0.3mm
R601, R605, R609: 100R; R_0603_1608Metric
R602, R606, R610: 100K; R_0603_1608Metric
R603, R607, R611: 30K 1%; R_0603_1608Metric
R604, R612: 135K 1%; R_0603_1608Metric
R608: 60.4K 1%; R_0603_1608Metric
U601, U602, U603: TPS564242DRLR; SOTFL50P160X60-6N; Mouser Part Number 595-TPS564242DRLR

Connections:
5V_SYS_GOOD: R601.1, R605.1, R609.1
+1V8_EN: R605.2, R606.1, U602.5 (EN)
+1V8_FB: C610.1, R607.2, R608.1, U602.6 (FB)
+1V8_SW: L602.1, U602.2 (SW)
+1V8_SYS: C610.2, C611.1, C612.1, C613.1, C615.1, L602.2, R608.2
+3V3_EN: R601.2, R602.1, U601.5 (EN)
+3V3_FB: C603.1, R603.2, R604.1, U601.6 (FB)
+3V3_MODEM: C617.2, C618.1, C619.1, C620.1, C621.1, L603.2, R612.2
+3V3_SW: L601.1, U601.2 (SW)
+3V3_SYS: C603.2, C604.1, C605.1, C607.1, C609.1, L601.2, R604.2
+5V_SYS: C601.1, C602.1, C606.1, C608.1, C614.1, C616.1, U601.1 (VIN), U602.1 (VIN), U603.1 (VIN)
AGND: NT601.2, NT602.2, NT603.2, R603.1, R607.1, R611.1, U601.4 (AGND), U602.4 (AGND), U603.4 (AGND)
GND: C601.2, C602.2, C606.2, C608.2, C614.2, C616.2, NT601.1, NT602.1, NT603.1, R602.2, R606.2, R610.2, U601.3 (GND), U602.3 (GND), U603.3 (GND)
MODEM_3V3_EN: R609.2, R610.1, U603.5 (EN)
MODEM_3V3_FB: C617.1, R611.2, R612.1, U603.6 (FB)
MODEM_BUCK_SW: L603.1, U603.2 (SW)
unnamed: C604.2, C605.2, C607.2, C609.2
unnamed: C611.2, C612.2, C613.2, C615.2
unnamed: C618.2, C619.2, C620.2, C621.2

Notes on the sheet:
Route FB from the post-inductor output capacitors
LAYOUT NOTE: Return R603 quietly near AGND, away from the switch node. Keep the feedback divider physically near pin 6 and return its bottom resistor to the quiet ground copper beside pin 4. Keep the input/output capacitor ground returns close to pin 3.
MODEM_3V3
+1V8
+3V3
DESIGN NOTE: VOUT = 0.600 V × (1 + 60.4k / 30k) VOUT = 1.808 V nominal
Layout Example
DESIGN NOTE: VOUT = 0.600 V x (1 + 135k / 30k) VOUT = 3.30 V
VOUT = 0.600 V x (1 + 135k / 30k) VOUT = 3.30 V
