mibs510/OpenXTCM5-Head-Unit/pcb/power.kicad_sch

## KiCad design pcb/power.kicad_sch (2026-10-04)

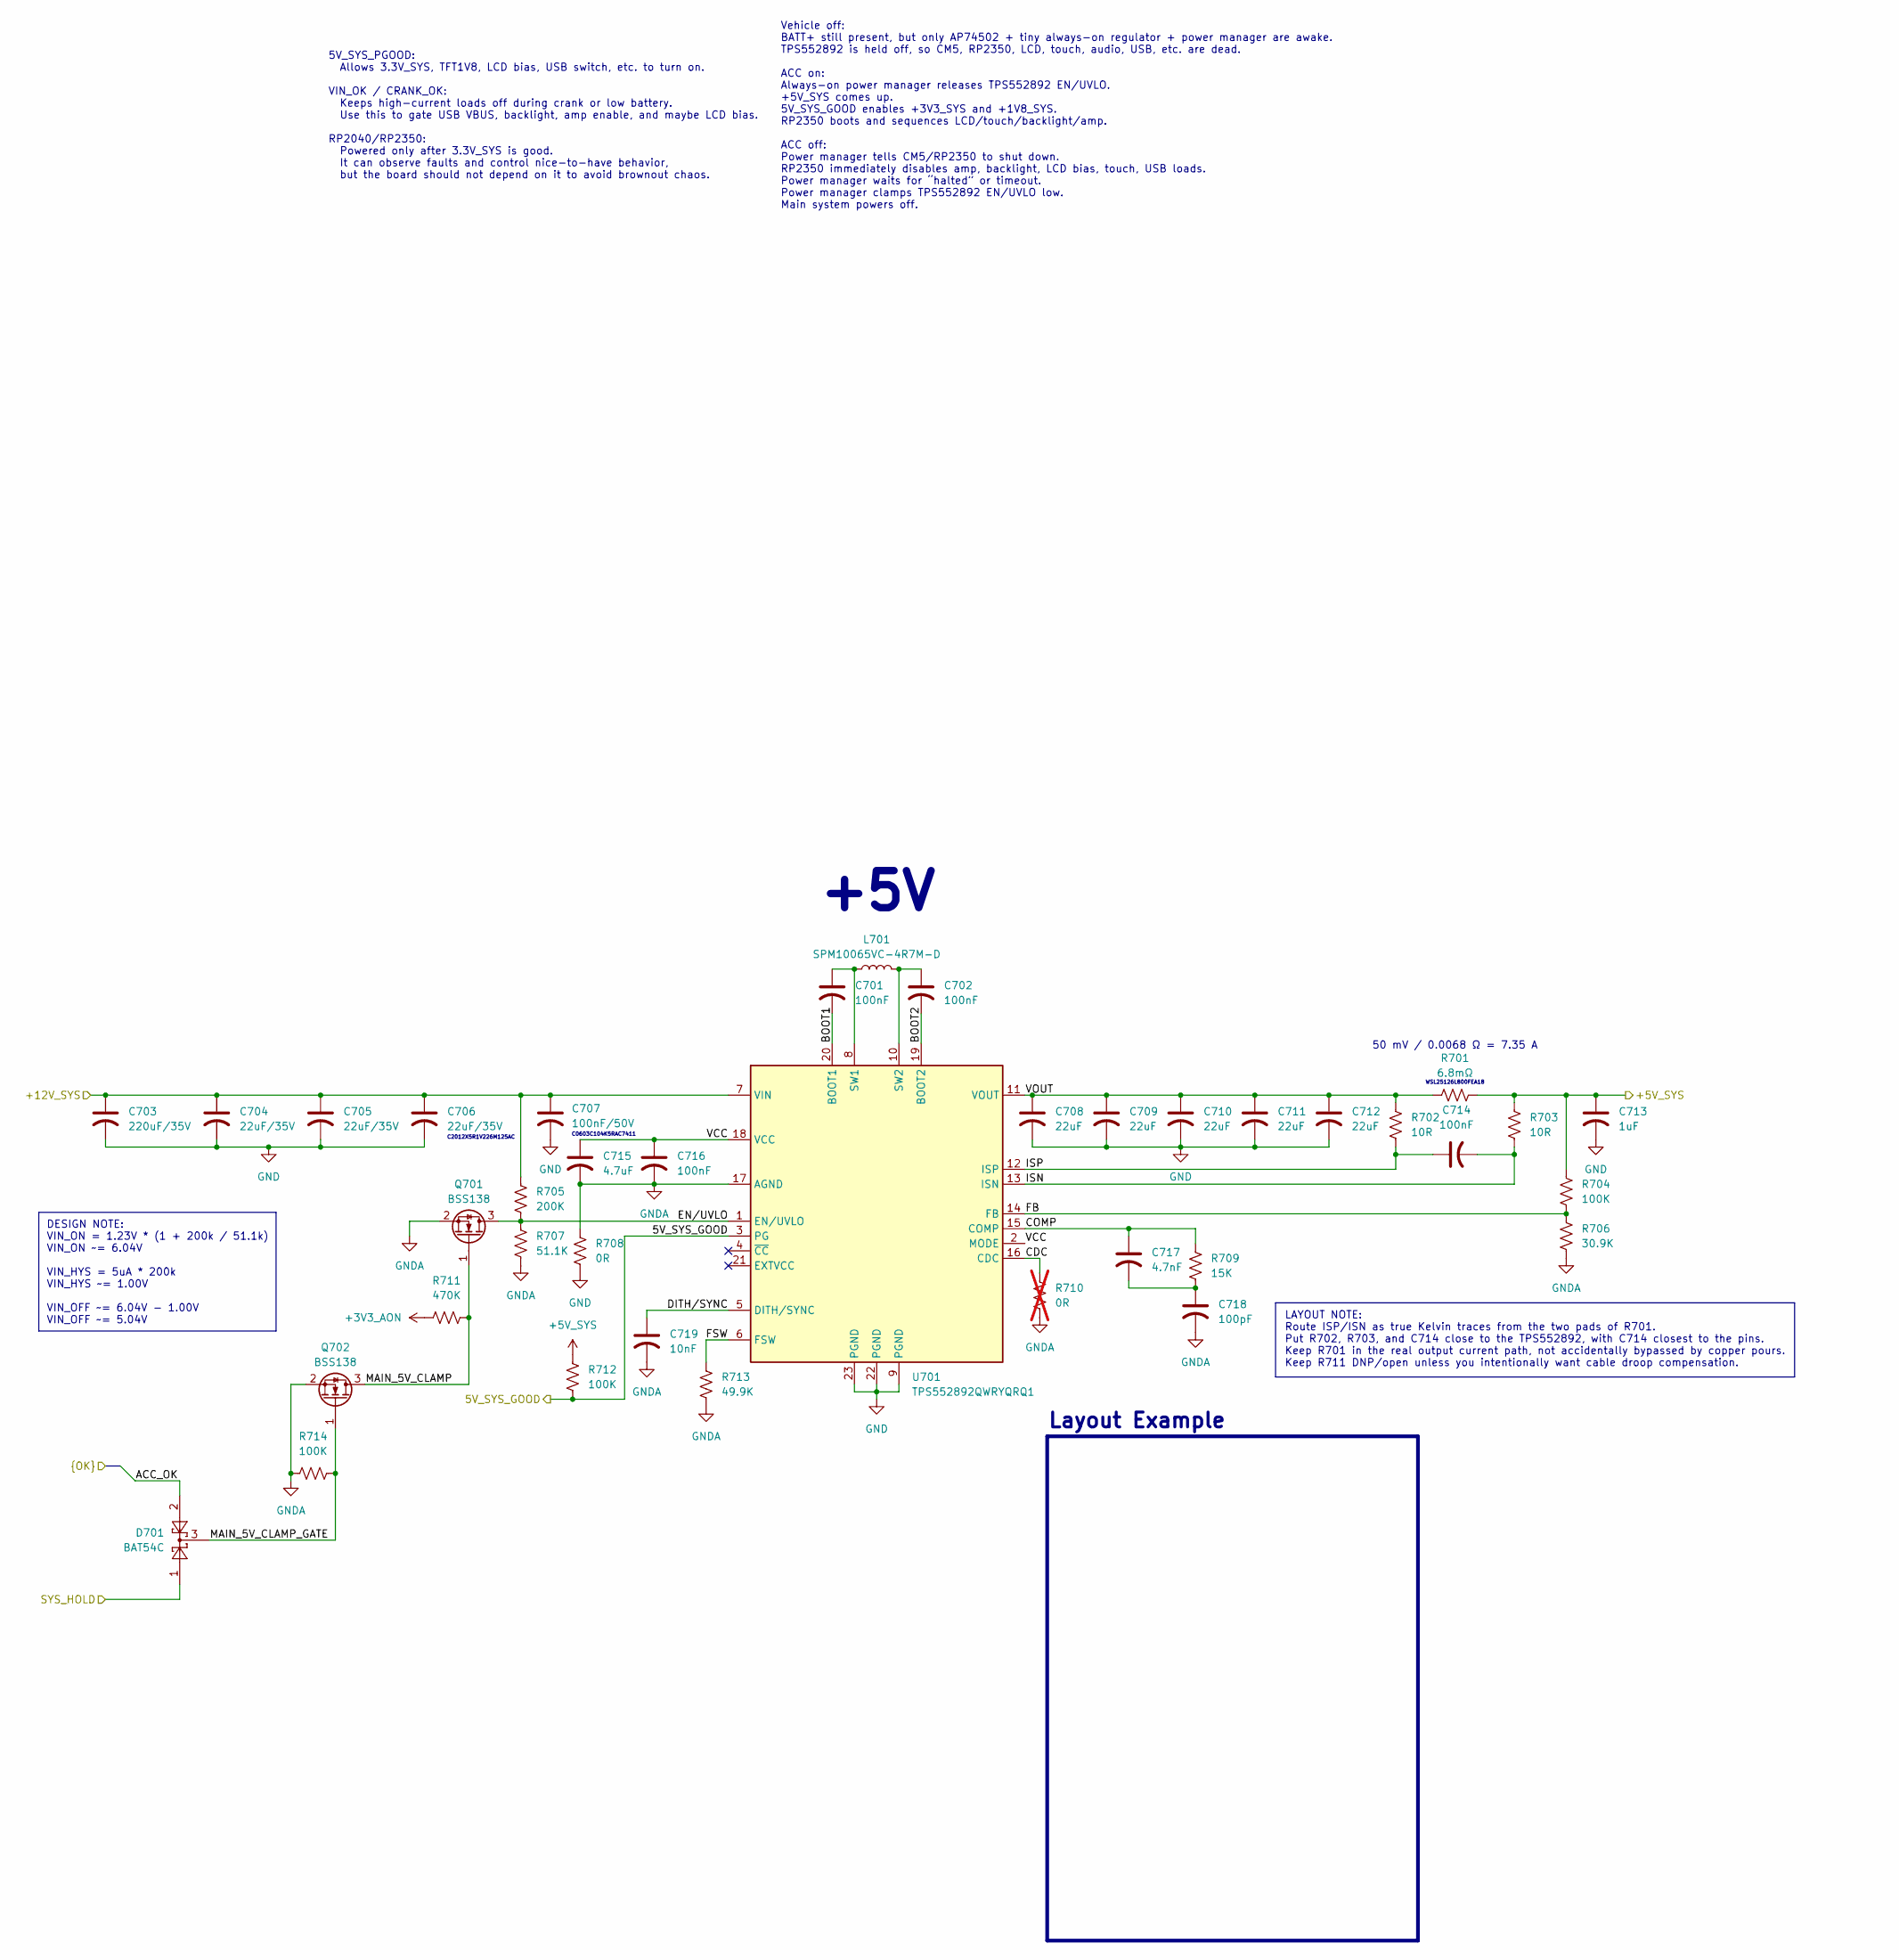
[picture p13: schematic power.kicad_sch]

Parts:
C701, C702, C714, C716: 100nF; C_0603_1608Metric
C703: 220uF/35V; CP_Elec_8x10.5
C704, C705, C706: 22uF/35V; C_0805_2012Metric
C707: 100nF/50V; C_0805_2012Metric
C708, C709, C710, C711: 22uF; C_0805_2012Metric
C712: 22uF; CP_Elec_8x10.5
C713: 1uF; C_0603_1608Metric
C715: 4.7uF; C_0603_1608Metric
C717: 4.7nF; C_0603_1608Metric
C718: 100pF; C_0603_1608Metric
C719: 10nF; C_0603_1608Metric
D701: BAT54C; SOT-23
L701: SPM10065VC-4R7M-D; SPM10065VC3R3MD
Q701, Q702: BSS138; SOT-23-3
R701: 6.8mΩ; D_2512_6332Metric
R702, R703: 10R; R_0603_1608Metric
R704, R712, R714: 100K; R_0603_1608Metric
R705: 200K; R_0603_1608Metric
R706: 30.9K; R_0603_1608Metric
R707: 51.1K; R_0603_1608Metric
R708: 0R; R_0603_1608Metric
R709: 15K; R_0603_1608Metric
R710: 0R; R_0603_1608Metric; not fitted
R711: 470K; R_0603_1608Metric
R713: 49.9K; R_0603_1608Metric
U701: TPS552892QWRYQRQ1; Mouser Part Number 595-PS552892QWRYQRQ1

Connections:
5V_SYS_GOOD: R712.2, U701.3 (PG)
+3V3_AON: R711.1
+5V_SYS: C713.1, R701.2, R703.1, R704.1, R712.1
+12V_SYS: C703.1, C704.1, C705.1, C706.1, C707.1, R705.1, U701.7 (VIN)
ACC_OK: D701.2
BOOT1: C701.2, U701.20 (BOOT1)
BOOT2: C702.2, U701.19 (BOOT2)
CDC: R710.1, U701.16 (CDC)
COMP: C717.1, R709.1, U701.15 (COMP)
DITH/SYNC: C719.1, U701.5 (DITH/SYNC)
EN/UVLO: Q701.3 (D), R705.2, R707.1, U701.1 (EN/UVLO)
FB: R704.2, R706.1, U701.14 (FB)
FSW: R713.1, U701.6 (FSW)
GND: C703.2, C704.2, C705.2, C706.2, C707.2, C708.2, C709.2, C710.2, C711.2, C712.2, C713.2, R708.2, U701.9 (PGND), U701.22 (PGND), U701.23 (PGND)
GNDA: C715.2, C716.2, C718.2, C719.2, Q701.2 (S), Q702.2 (S), R706.2, R707.2, R708.1, R710.2, R713.2, R714.1, U701.17 (AGND)
ISN: C714.2, R703.2, U701.13 (ISN)
ISP: C714.1, R702.2, U701.12 (ISP)
MAIN_5V_CLAMP: Q701.1 (G), Q702.3 (D), R711.2
MAIN_5V_CLAMP_GATE: D701.3, Q702.1 (G), R714.2
unnamed: C701.1, L701.1, U701.8 (SW1)
unnamed: C702.1, L701.2, U701.10 (SW2)
unnamed: C717.2, C718.1, R709.2
SYS_HOLD: D701.1
VCC: C715.1, C716.1, U701.2 (MODE), U701.18 (VCC)
VOUT: C708.1, C709.1, C710.1, C711.1, C712.1, R701.1, R702.1, U701.11 (VOUT)

Notes on the sheet:
DESIGN NOTE: VIN_ON = 1.23V * (1 + 200k / 51.1k) VIN_ON ~= 6.04V VIN_HYS = 5uA * 200k VIN_HYS ~= 1.00V VIN_OFF ~= 6.04V - 1.00V VIN_OFF ~= 5.04V
5V_SYS_PGOOD: Allows 3.3V_SYS, TFT1V8, LCD bias, USB switch, etc. to turn on. VIN_OK / CRANK_OK: Keeps high-current loads off during crank or low battery. Use this to gate USB VBUS, backlight, amp enable, and maybe LCD bias. RP2040/RP2350: Powered only after 3.3V_SYS is good. It can observe faults 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
LAYOUT NOTE: Route ISP/ISN as true Kelvin traces from the two pads of R701. Put R702, R703, and C714 close to the TPS552892, with C714 closest to the pins. Keep R701 in the real output current path, not accidentally bypassed by copper pours. Keep R711 DNP/open unless you intentionally want cable dr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
C2012X5R1V226M125AC
Layout Example
50 mV / 0.0068 Ω = 7.35 A
Vehicle off: BATT+ still present, but only AP74502 + tiny always-on regulator + power manager are awake. TPS552892 is held off, so CM5, RP2350, LCD, touch, audio, USB, etc. are dead. ACC on: Always-on power manager releases TPS552892 EN/UVLO. +5V_SYS comes up. 5V_SYS_GOOD enables +3V3_SYS and +1V8_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
+5V
C0603C104K5RAC7411
WSL25126L800FEA18
