mibs510/OpenXTCM5-Head-Unit/pcb/power_switches.kicad_sch

## KiCad design pcb/power_switches.kicad_sch (2026-10-04)

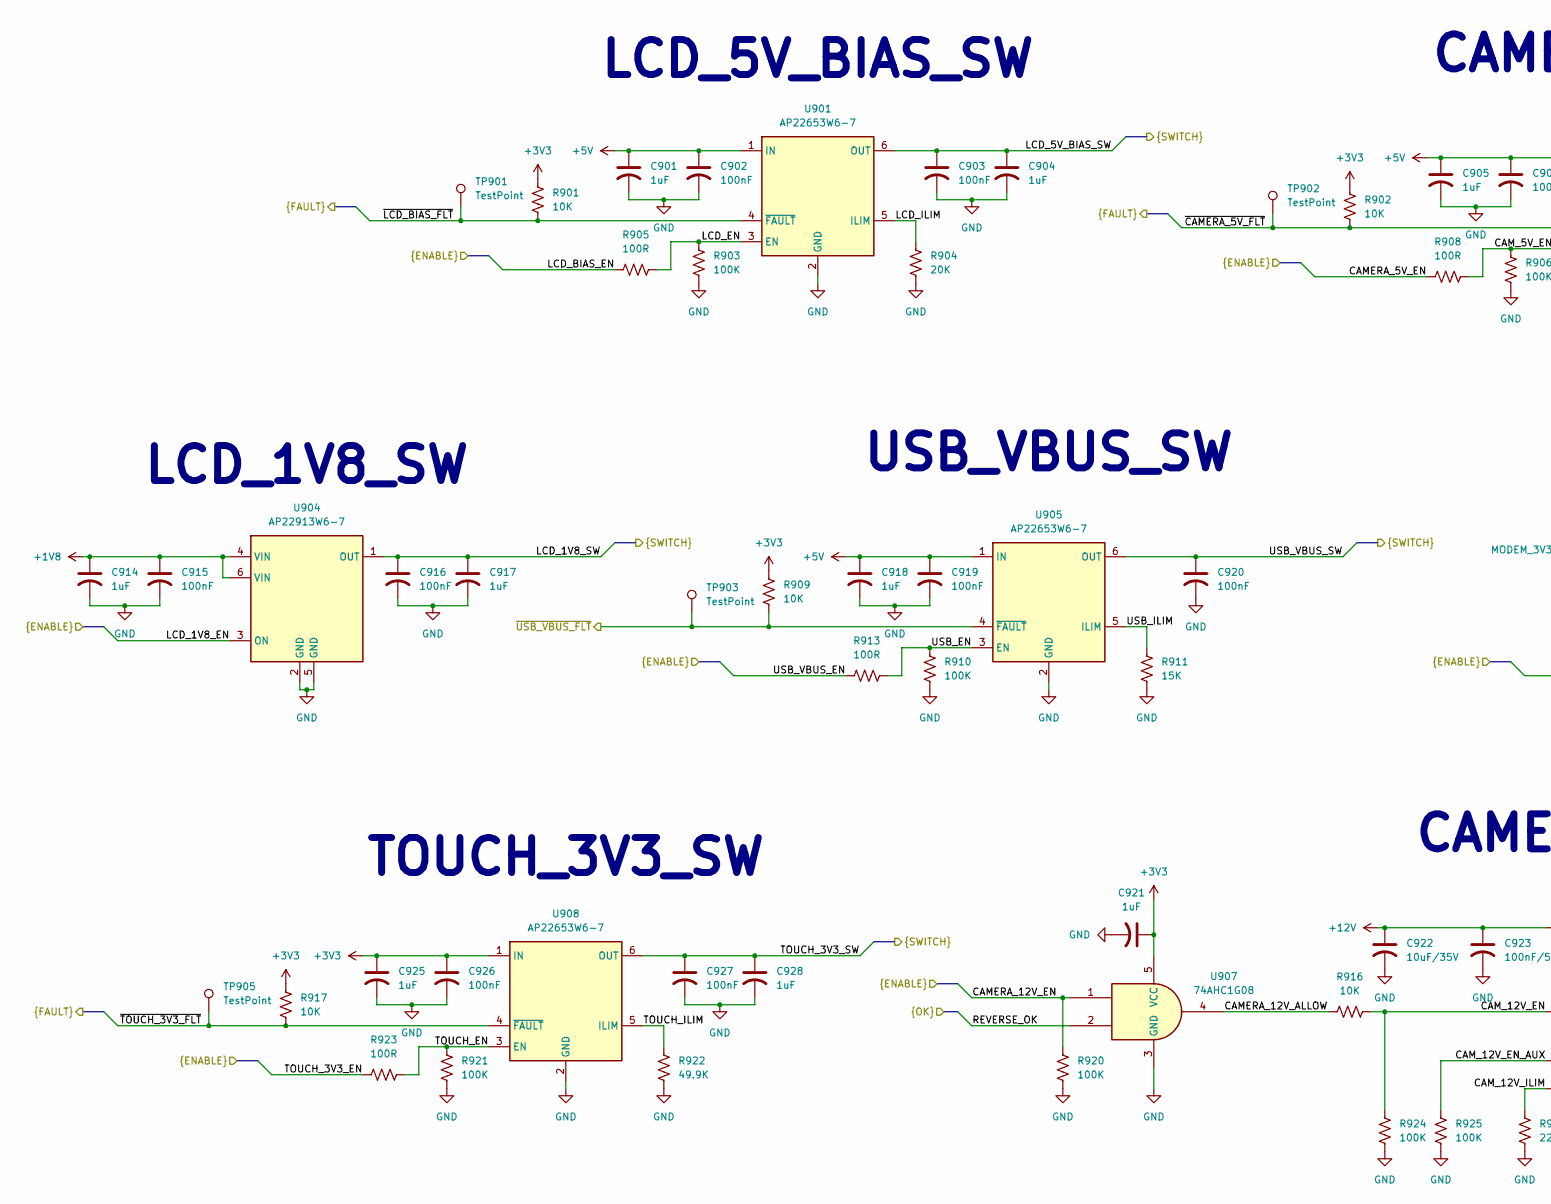
[picture p14: schematic power_switches.kicad_sch, part in row 1, column 1]

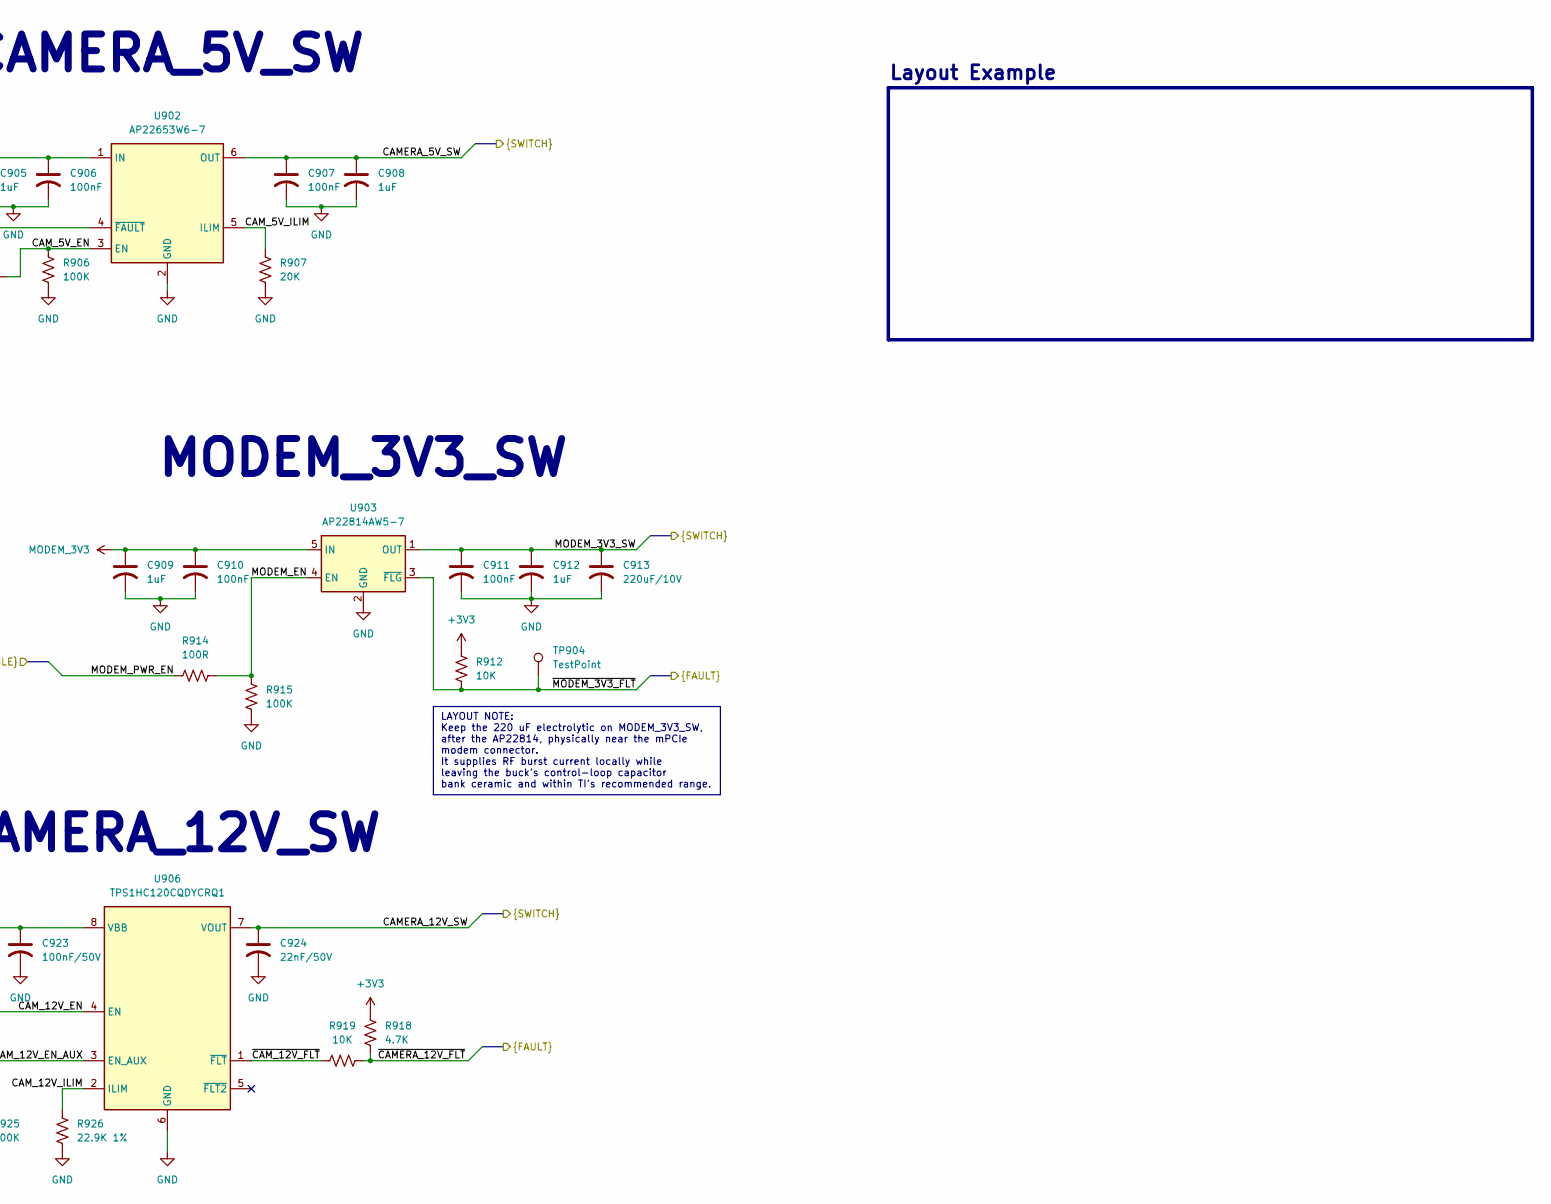
[picture p15: schematic power_switches.kicad_sch, part in row 1, column 2]

Parts:
C901, C904, C905, C908, C909, C912, C914, C917, C918, C921, C925, C928: 1uF; C_0603_1608Metric
C902, C903, C906, C907, C910, C911, C915, C916, C919, C920, C926, C927: 100nF; C_0603_1608Metric
C913: 220uF/10V; C_Elec_6.3x5.4
C922: 10uF/35V; C_0603_1608Metric
C923: 100nF/50V; C_0603_1608Metric
C924: 22nF/50V; C_0603_1608Metric
R901, R902, R909, R912, R916, R917, R919: 10K; R_0603_1608Metric
R903, R906, R910, R915, R920, R921, R924, R925: 100K; R_0603_1608Metric
R904, R907: 20K; R_0603_1608Metric
R905, R908, R913, R914, R923: 100R; R_0603_1608Metric
R911: 15K; R_0603_1608Metric
R918: 4.7K; R_0603_1608Metric
R922: 49.9K; R_0603_1608Metric
R926: 22.9K 1%; R_0603_1608Metric
TP901, TP902, TP903, TP904, TP905: TestPoint; TestPoint_Pad_D2.5mm
U901, U902, U905, U908: AP22653W6-7; SOT95P280X145-6N; Manufacturer_Part_Number AP22653W6-7; Mouser Part Number 621-AP22653W6-7
U903: AP22814AW5-7; SOT-23-5
U904: AP22913W6-7; SOT95P285X140-6N; Mouser Part Number 621-AP22913W6-7
U906: TPS1HC120CQDYCRQ1; SOTFL50P160X60-8N; Manufacturer_Part_Number TPS1HC120CQDYCRQ1
U907: 74AHC1G08; SOT-23-5

Connections:
+1V8: C914.1, C915.1, U904.4 (VIN), U904.6 (VIN)
+3V3: C921.1, C925.1, C926.1, R901.1, R902.1, R909.1, R912.1, R917.1, R918.1, U907.5 (VCC), U908.1 (IN)
+5V: C901.1, C902.1, C905.1, C906.1, C918.1, C919.1, U901.1 (IN), U902.1 (IN), U905.1 (IN)
+12V: C922.1, C923.1, U906.8 (VBB)
CAMERA_5V_EN: R908.1
CAMERA_5V_SW: C907.1, C908.1, U902.6 (OUT)
CAMERA_12V_ALLOW: R916.1, U907.4
CAMERA_12V_EN: R920.1, U907.1
CAMERA_12V_SW: C924.1, U906.7 (VOUT)
CAM_5V_EN: R906.1, R908.2, U902.3 (EN)
CAM_5V_ILIM: R907.1, U902.5 (ILIM)
CAM_12V_EN: R916.2, R924.1, U906.4 (EN)
CAM_12V_EN_AUX: R925.1, U906.3 (EN_AUX)
CAM_12V_ILIM: R926.1, U906.2 (ILIM)
GND: C901.2, C902.2, C903.2, C904.2, C905.2, C906.2, C907.2, C908.2, C909.2, C910.2, C911.2, C912.2, C913.2, C914.2, C915.2, C916.2, C917.2, C918.2, C919.2, C920.2, C921.2, C922.2, C923.2, C924.2, C925.2, C926.2, C927.2, C928.2, R903.2, R904.2, R906.2, R907.2, R910.2, R911.2, R915.2, R920.2, R921.2, R922.2, R924.2, R925.2, R926.2, U901.2 (GND), U902.2 (GND), U903.2 (GND), U904.2 (GND), U904.5 (GND), U905.2 (GND), U906.6 (GND), U907.3 (GND), U908.2 (GND)
LCD_1V8_EN: U904.3 (ON)
LCD_1V8_SW: C916.1, C917.1, U904.1 (OUT)
LCD_5V_BIAS_SW: C903.1, C904.1, U901.6 (OUT)
LCD_BIAS_EN: R905.1
LCD_EN: R903.1, R905.2, U901.3 (EN)
LCD_ILIM: R904.1, U901.5 (ILIM)
MODEM_3V3: C909.1, C910.1, U903.5 (IN)
MODEM_3V3_SW: C911.1, C912.1, C913.1, U903.1 (OUT)
MODEM_EN: R914.2, R915.1, U903.4 (EN)
MODEM_PWR_EN: R914.1
REVERSE_OK: U907.2
TOUCH_3V3_EN: R923.1
TOUCH_3V3_SW: C927.1, C928.1, U908.6 (OUT)
TOUCH_EN: R921.1, R923.2, U908.3 (EN)
TOUCH_ILIM: R922.1, U908.5 (ILIM)
USB_EN: R910.1, R913.2, U905.3 (EN)
USB_ILIM: R911.1, U905.5 (ILIM)
USB_VBUS_EN: R913.1
USB_VBUS_SW: C920.1, U905.6 (OUT)
~CAMERA_5V_FLT: R902.2, TP902.1, U902.4 (~FAULT)
~CAMERA_12V_FLT: R918.2, R919.2
~CAM_12V_FLT: R919.1, U906.1 (~FLT)
~LCD_BIAS_FLT: R901.2, TP901.1, U901.4 (~FAULT)
~MODEM_3V3_FLT: R912.2, TP904.1, U903.3 (~FLG)
~TOUCH_3V3_FLT: R917.2, TP905.1, U908.4 (~FAULT)
~USB_VBUS_FLT: R909.2, TP903.1, U905.4 (~FAULT)

Notes on the sheet:
MODEM_3V3_SW
LCD_5V_BIAS_SW
TOUCH_3V3_SW
CAMERA_5V_SW
CAMERA_12V_SW
LAYOUT NOTE: Keep the 220 uF electrolytic on MODEM_3V3_SW, after the AP22814, physically near the mPCIe modem connector. It supplies RF burst current locally while leaving the buck’s control-loop capacitor bank ceramic and within TI’s recommended range.
Layout Example
USB_VBUS_SW
LCD_1V8_SW
