mibs510/OpenXTCM5-Head-Unit/pcb/rear_io.kicad_sch

## KiCad design pcb/rear_io.kicad_sch (2026-10-04)

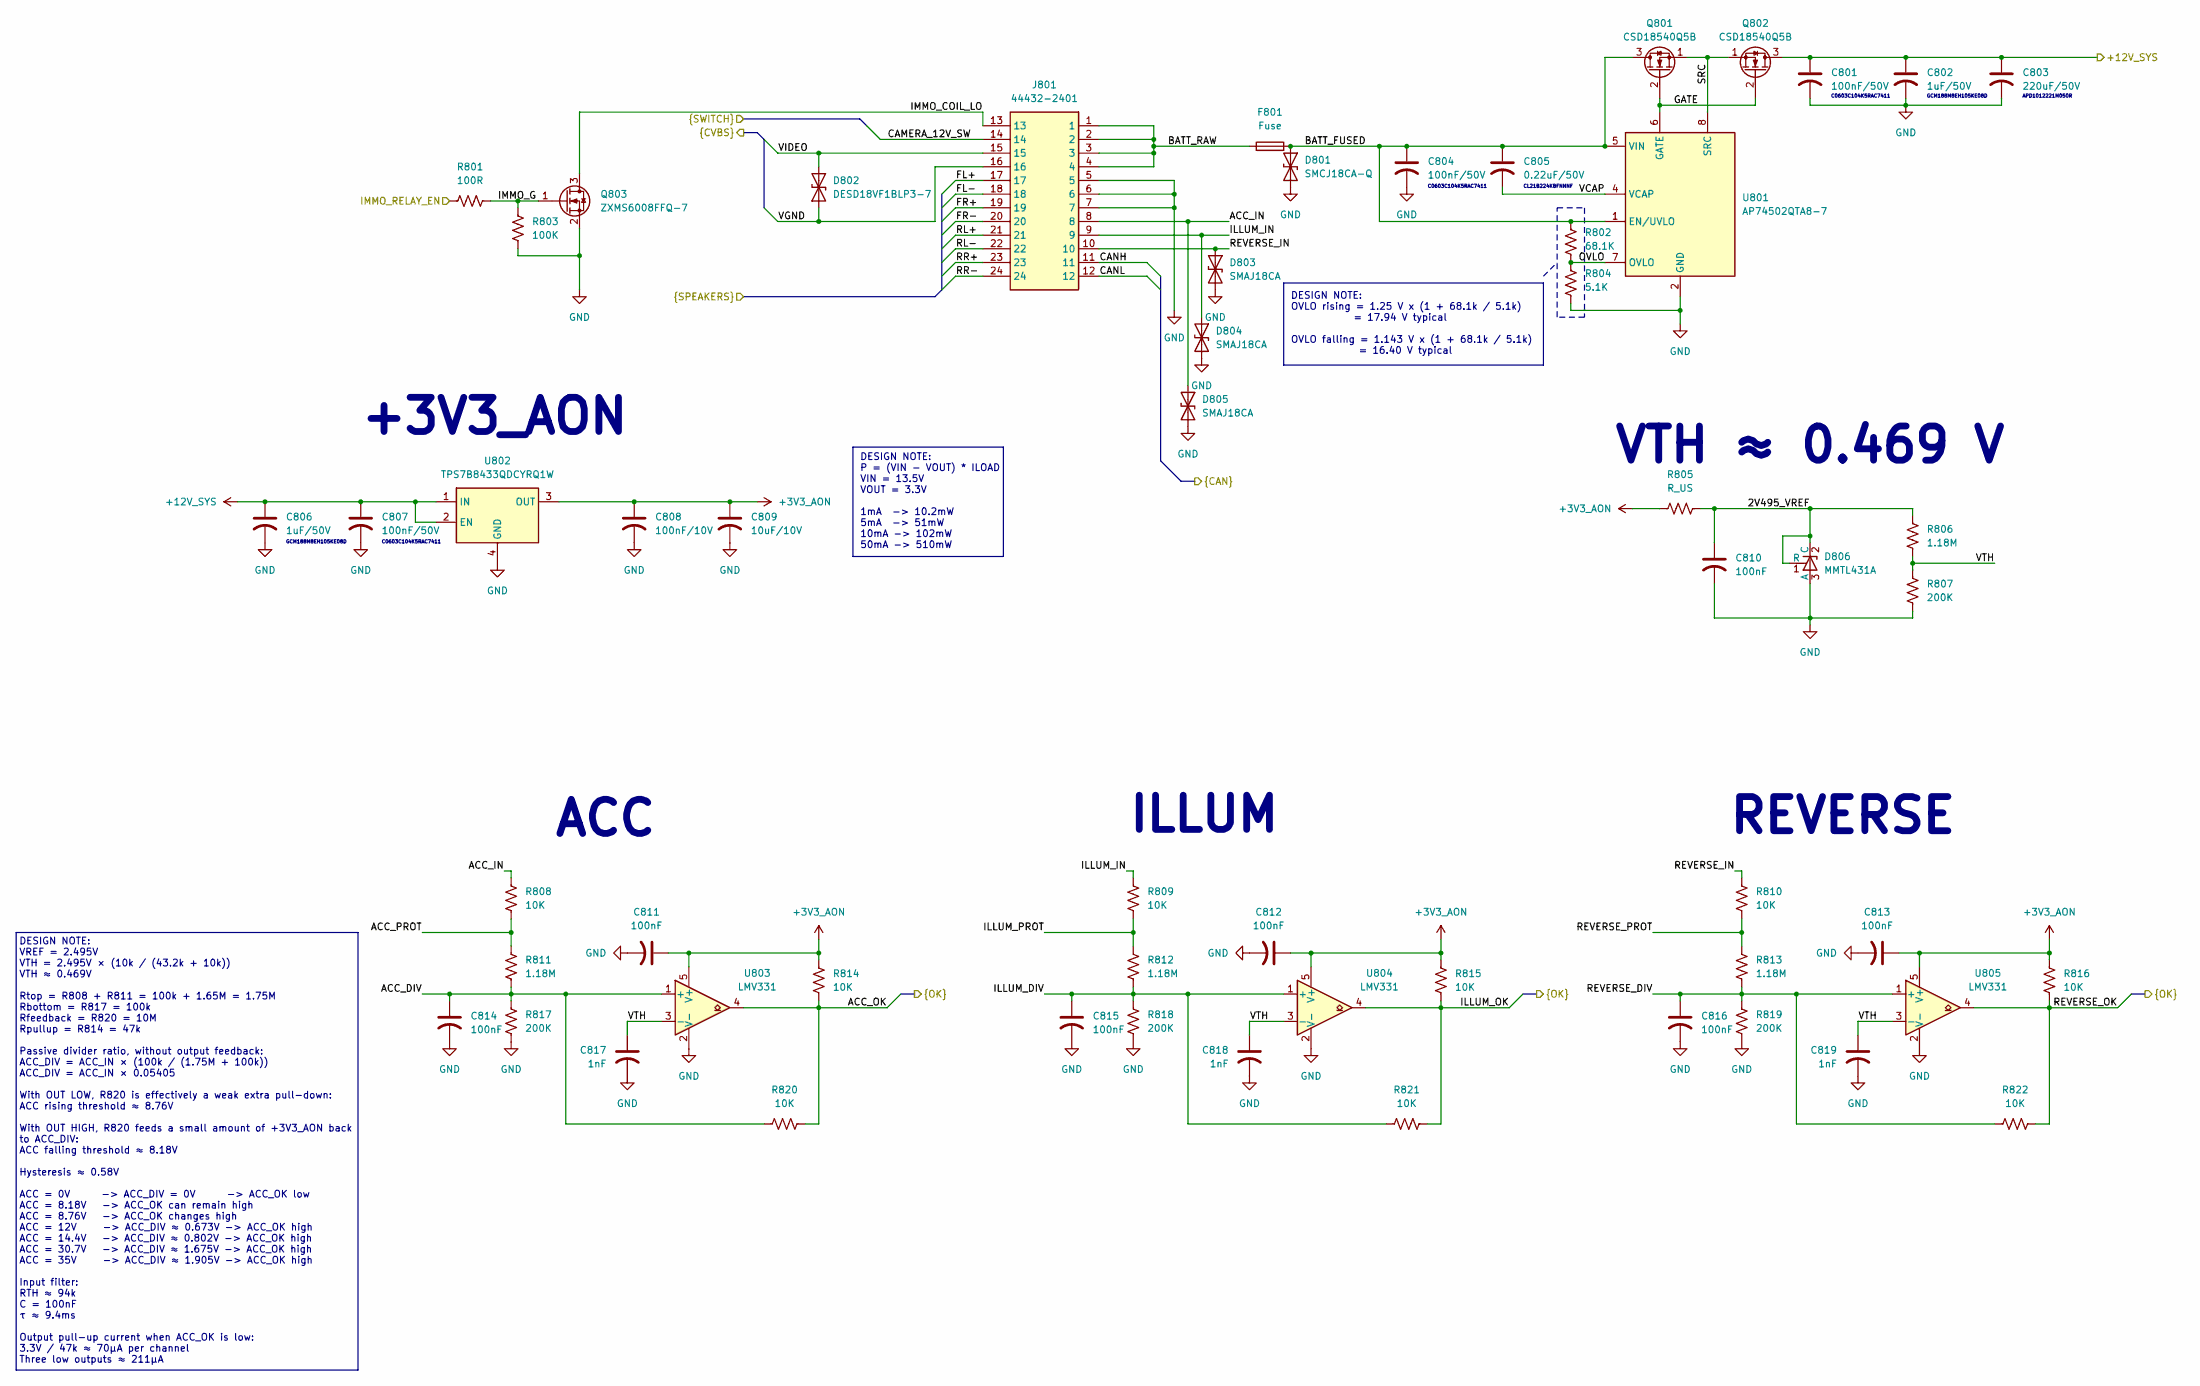
[picture p16: schematic rear_io.kicad_sch]

Parts:
C801, C804, C807: 100nF/50V; C_0603_1608Metric
C802, C806: 1uF/50V; C_0603_1608Metric
C803: 220uF/50V; CP_Elec_8x10.5
C805: 0.22uF/50V; C_0603_1608Metric
C808: 100nF/10V; C_0603_1608Metric
C809: 10uF/10V; C_0805_2012Metric
C810, C811, C812, C813, C814, C815, C816: 100nF; C_0603_1608Metric
C817, C818, C819: 1nF; C_0603_1608Metric
D801: SMCJ18CA-Q; D_SMA
D802: DESD18VF1BLP3-7; DESD18VF1BLP37
D803, D804, D805: SMAJ18CA; D_SMA
D806: MMTL431A; SOT-23
F801: Fuse; Fuseholder_Blade_Mini_Keystone_3568
J801: 44432-2401; 44432-24_01,02,03_; Mouser Part Number 538-44432-2401
Q801, Q802: CSD18540Q5B
Q803: ZXMS6008FFQ-7; ZXMS6008FFQ7
R801: 100R; R_0603_1608Metric
R802: 68.1K; R_0603_1608Metric
R803: 100K; R_0603_1608Metric
R804: 5.1K; R_0603_1608Metric
R805: R_US
R806, R811, R812, R813: 1.18M; R_0603_1608Metric
R807, R817, R818, R819: 200K; R_0603_1608Metric
R808, R809, R810, R814, R815, R816, R820, R821, R822: 10K; R_0603_1608Metric
U801: AP74502QTA8-7; SOT65P280X110-8N; Manufacturer_Part_Number AP74502QTA8-7
U802: TPS7B8433QDCYRQ1W; SOT230P700X180-4N; Mouser Part Number 595-TPS7B8433QDCYQ1W
U803, U804, U805: LMV331; SOT-353_SC-70-5

Connections:
2V495_VREF: C810.1, D806.1 (R), D806.2 (C), R805.2, R806.1
+3V3_AON: C808.1, C809.1, C811.1, C812.1, C813.1, R805.1, R814.1, R815.1, R816.1, U802.3 (OUT), U803.5 (V+), U804.5 (V+), U805.5 (V+)
+12V_SYS: C801.1, C802.1, C803.1, C806.1, C807.1, Q802.3 (D), U802.1 (IN), U802.2 (EN)
ACC_DIV: C814.1, R811.2, R817.1, R820.1, U803.1 (+)
ACC_IN: D805.1 (A1), J801.8, R808.1
ACC_OK: R814.2, R820.2, U803.4
ACC_PROT: R808.2, R811.1
BATT_FUSED: C804.1, C805.1, D801.1 (A1), F801.2, Q801.3 (D), R802.1, U801.1 (EN/UVLO), U801.5 (VIN)
BATT_RAW: F801.1, J801.1, J801.2, J801.3, J801.4
CAMERA_12V_SW: J801.14
CANH: J801.11
CANL: J801.12
FL+: J801.17
FL-: J801.18
FR+: J801.19
FR-: J801.20
GATE: Q801.2 (G), Q802.2 (G), U801.6 (GATE)
GND: C801.2, C802.2, C803.2, C804.2, C806.2, C807.2, C808.2, C809.2, C810.2, C811.2, C812.2, C813.2, C814.2, C815.2, C816.2, C817.2, C818.2, C819.2, D801.2 (A2), D803.2 (A2), D804.2 (A2), D805.2 (A2), D806.3 (A), J801.5, J801.6, J801.7, Q803.2 (S), R803.1, R804.2, R807.2, R817.2, R818.2, R819.2, U801.2 (GND), U802.4 (GND), U803.2 (V-), U804.2 (V-), U805.2 (V-)
ILLUM_DIV: C815.1, R812.2, R818.1, R821.1, U804.1 (+)
ILLUM_IN: D804.1 (A1), J801.9, R809.1
ILLUM_OK: R815.2, R821.2, U804.4
ILLUM_PROT: R809.2, R812.1
IMMO_COIL_LO: J801.13, Q803.3 (D)
IMMO_G: Q803.1 (G), R801.2, R803.2
IMMO_RELAY_EN: R801.1
OVLO: R802.2, R804.1, U801.7 (OVLO)
REVERSE_DIV: C816.1, R813.2, R819.1, R822.1, U805.1 (+)
REVERSE_IN: D803.1 (A1), J801.10, R810.1
REVERSE_OK: R816.2, R822.2, U805.4
REVERSE_PROT: R810.2, R813.1
RL+: J801.21
RL-: J801.22
RR+: J801.23
RR-: J801.24
SRC: Q801.1 (S), Q802.1 (S), U801.8 (SRC)
VCAP: C805.2, U801.4 (VCAP)
VGND: D802.1 (A1), J801.16
VIDEO: D802.2 (A2), J801.15
VTH: C817.1, C818.1, C819.1, R806.2, R807.1, U803.3 (-), U804.3 (-), U805.3 (-)

Notes on the sheet:
DESIGN NOTE: VREF = 2.495V VTH = 2.495V × (10k / (43.2k + 10k)) VTH ≈ 0.469V Rtop = R808 + R811 = 100k + 1.65M = 1.75M Rbottom = R817 = 100k Rfeedback = R820 = 10M Rpullup = R814 = 47k Passive divider ratio, without output feedback: ACC_DIV = ACC_IN × (100k / (1.75M + 100k)) ACC_DIV = ACC_IN × 0.05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
VTH ≈ 0.469 V
C0603C104K5RAC7411
DESIGN NOTE: P = (VIN - VOUT) * ILOAD VIN = 13.5V VOUT = 3.3V 1mA -> 10.2mW 5mA -> 51mW 10mA -> 102mW 50mA -> 510mW
+3V3_AON
DESIGN NOTE: OVLO rising = 1.25 V x (1 + 68.1k / 5.1k) = 17.94 V typical OVLO falling = 1.143 V x (1 + 68.1k / 5.1k) = 16.40 V typical
ILLUM
ACC
APD1012221M050R
GCM188M8EH105KE08D
CL21B224KBFNNNF
REVERSE
