mibs510/OpenXTCM5-Head-Unit/pcb/reverse_camera_capture.kicad_sch

## KiCad design pcb/reverse_camera_capture.kicad_sch (2026-10-04)

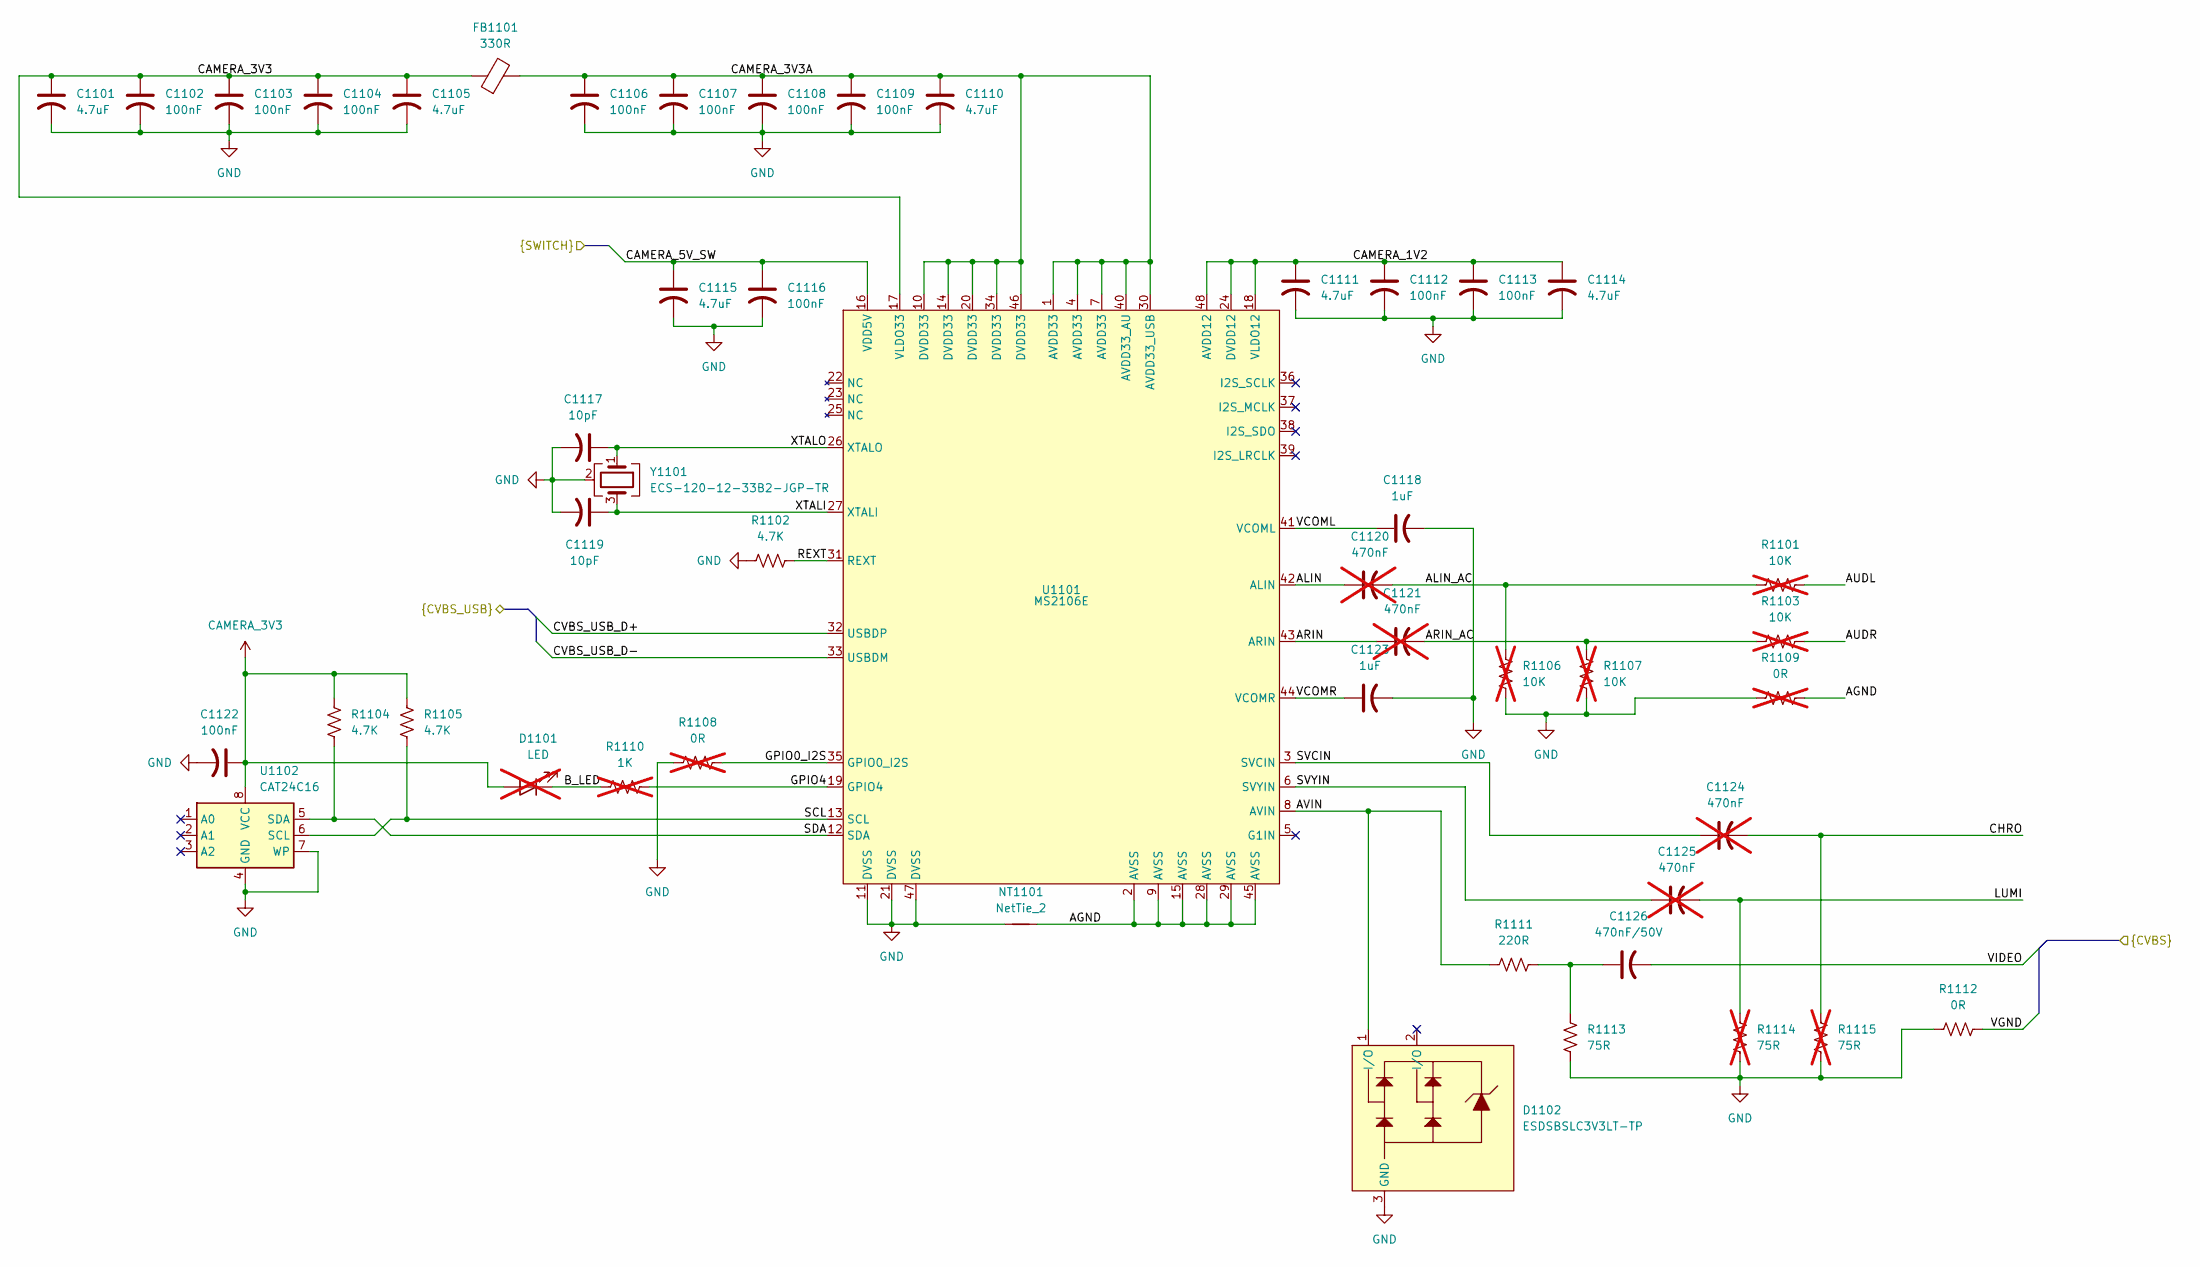
[picture p17: schematic reverse_camera_capture.kicad_sch]

Parts:
C1101, C1105, C1110, C1111, C1114, C1115: 4.7uF; C_0603_1608Metric
C1102, C1103, C1104, C1106, C1107, C1108, C1109, C1112, C1113, C1116, C1122: 100nF; C_0603_1608Metric
C1117, C1119: 10pF; C_0603_1608Metric
C1118, C1123: 1uF; C_0603_1608Metric
C1120, C1121, C1124, C1125: 470nF; C_0603_1608Metric; not fitted
C1126: 470nF/50V; C_0603_1608Metric
D1101: LED; LED_0805_2012Metric; not fitted
D1102: ESDSBSLC3V3LT-TP; ESDSBSLC3V3LTTP; Mouser Part Number 833-ESDSBSLC3V3LT-TP
FB1101: 330R; L_0805_2012Metric
NT1101: NetTie_2; NetTie-2_THT_Pad0.3mm
R1101, R1103, R1106, R1107: 10K; R_0603_1608Metric; not fitted
R1102, R1104, R1105: 4.7K; R_0603_1608Metric
R1108, R1109: 0R; R_0603_1608Metric; not fitted
R1110: 1K; R_0603_1608Metric; not fitted
R1111: 220R; R_0603_1608Metric
R1112: 0R; R_0603_1608Metric
R1113: 75R; R_0603_1608Metric
R1114, R1115: 75R; R_0603_1608Metric; not fitted
U1101: MS2106E; LQFP-48_7x7mm_P0.5mm
U1102: CAT24C16; TSSOP-8_4.4x3mm_P0.65mm
Y1101: ECS-120-12-33B2-JGP-TR; Crystal_SMD_3225-4Pin_3.2x2.5mm

Connections:
AGND: NT1101.2, R1109.2, U1101.2 (AVSS), U1101.9 (AVSS), U1101.15 (AVSS), U1101.28 (AVSS), U1101.29 (AVSS), U1101.45 (AVSS)
ALIN: C1120.1, U1101.42 (ALIN)
ALIN_AC: C1120.2, R1101.1, R1106.1
ARIN: C1121.1, U1101.43 (ARIN)
ARIN_AC: C1121.2, R1103.1, R1107.1
AUDL: R1101.2
AUDR: R1103.2
AVIN: D1102.1 (I/O), R1111.1, U1101.8 (AVIN)
B_LED: D1101.1 (K), R1110.1
CAMERA_1V2: C1111.1, C1112.1, C1113.1, C1114.1, U1101.18 (VLDO12), U1101.24 (DVDD12), U1101.48 (AVDD12)
CAMERA_3V3: C1101.1, C1102.1, C1103.1, C1104.1, C1105.1, C1122.1, D1101.2 (A), FB1101.1, R1104.1, R1105.1, U1101.17 (VLDO33), U1102.8 (VCC)
CAMERA_3V3A: C1106.1, C1107.1, C1108.1, C1109.1, C1110.1, FB1101.2, U1101.1 (AVDD33), U1101.4 (AVDD33), U1101.7 (AVDD33), U1101.10 (DVDD33), U1101.14 (DVDD33), U1101.20 (DVDD33), U1101.30 (AVDD33_USB), U1101.34 (DVDD33), U1101.40 (AVDD33_AU), U1101.46 (DVDD33)
CAMERA_5V_SW: C1115.1, C1116.1, U1101.16 (VDD5V)
CHRO: C1124.2, R1115.1
CVBS_USB_D+: U1101.32 (USBDP)
CVBS_USB_D-: U1101.33 (USBDM)
GND: C1101.2, C1102.2, C1103.2, C1104.2, C1105.2, C1106.2, C1107.2, C1108.2, C1109.2, C1110.2, C1111.2, C1112.2, C1113.2, C1114.2, C1115.2, C1116.2, C1117.2, C1118.2, C1119.2, C1122.2, C1123.2, D1102.3 (GND), NT1101.1, R1102.1, R1106.2, R1107.2, R1108.1, R1109.1, R1112.1, R1113.2, R1114.2, R1115.2, U1101.11 (DVSS), U1101.21 (DVSS), U1101.47 (DVSS), U1102.4 (GND), U1102.7 (WP), Y1101.2 (G), Y1101.4 (G)
GPIO0_I2S: R1108.2, U1101.35 (GPIO0_I2S)
GPIO4: R1110.2, U1101.19 (GPIO4)
LUMI: C1125.2, R1114.1
unnamed: C1126.1, R1111.2, R1113.1
REXT: R1102.2, U1101.31 (REXT)
SCL: R1105.2, U1101.13 (SCL), U1102.6 (SCL)
SDA: R1104.2, U1101.12 (SDA), U1102.5 (SDA)
SVCIN: C1124.1, U1101.3 (SVCIN)
SVYIN: C1125.1, U1101.6 (SVYIN)
VCOML: C1118.1, U1101.41 (VCOML)
VCOMR: C1123.1, U1101.44 (VCOMR)
VGND: R1112.2
VIDEO: C1126.2
XTALI: C1119.1, U1101.27 (XTALI), Y1101.3
XTALO: C1117.1, U1101.26 (XTALO), Y1101.1
