mibs510/OpenXTCM5-Head-Unit/pcb/rp2350.kicad_sch

## KiCad design pcb/rp2350.kicad_sch (2026-10-04)

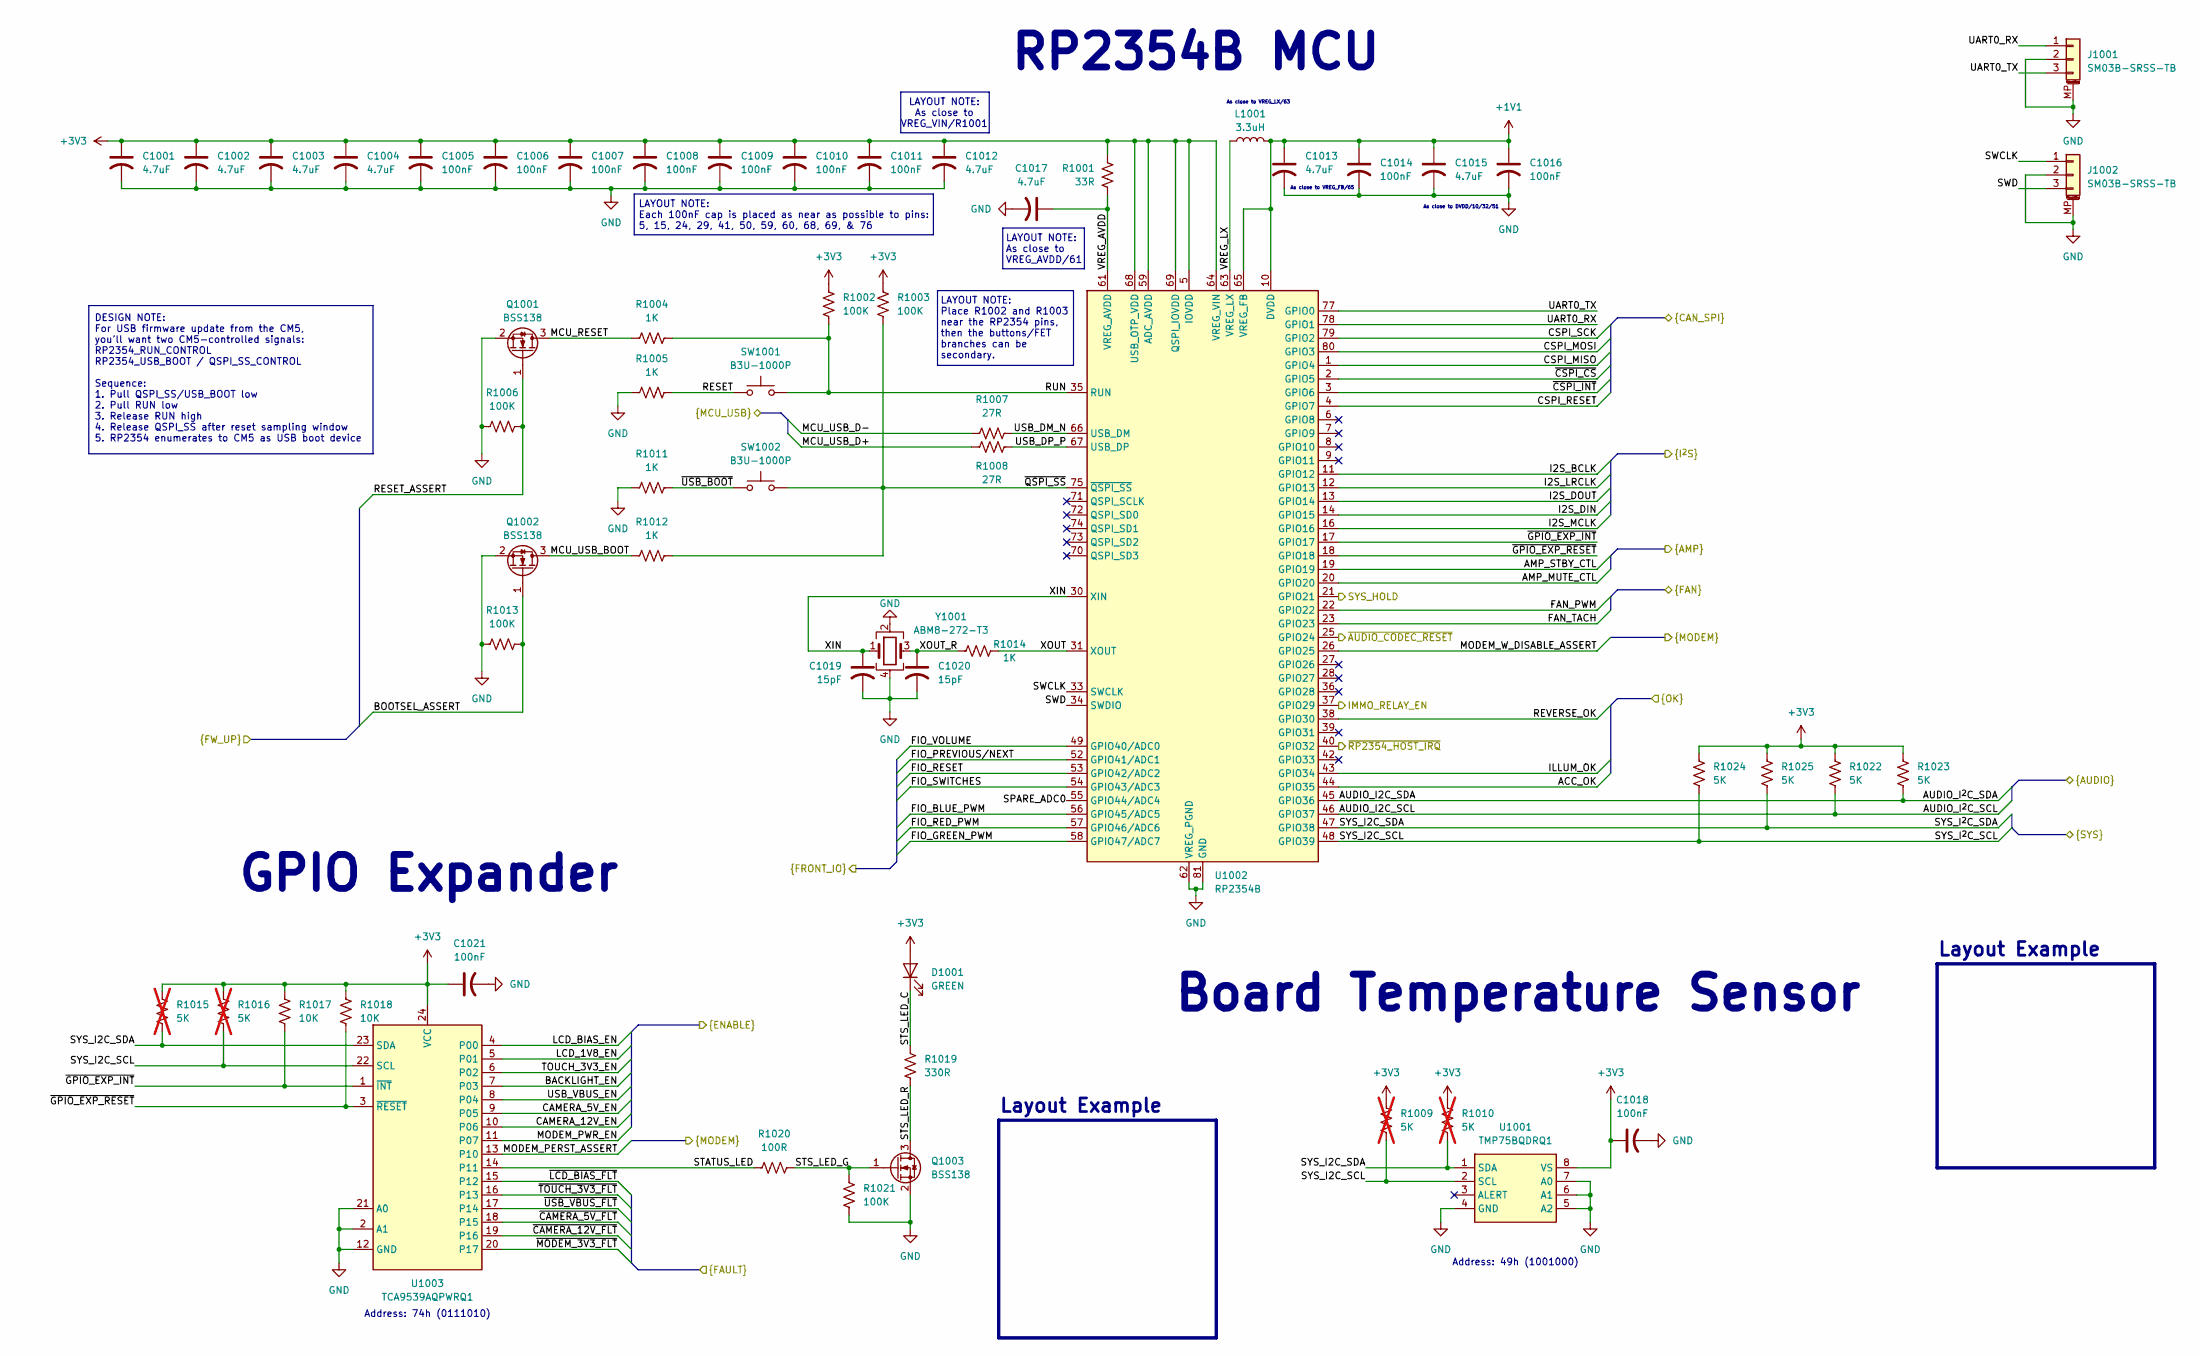
[picture p18: schematic rp2350.kicad_sch]

Parts:
C1001, C1002, C1003, C1004, C1012, C1013, C1015, C1017: 4.7uF; C_0603_1608Metric
C1005, C1006, C1007, C1008, C1009, C1010, C1011, C1014, C1016, C1018, C1021: 100nF; C_0603_1608Metric
C1019, C1020: 15pF; C_0603_1608Metric
D1001: GREEN; LED_0805_2012Metric
J1001, J1002: SM03B-SRSS-TB; JST_SH_SM03B-SRSS-TB_1x03-1MP_P1.00mm_Horizontal
L1001: 3.3uH; L_0805_2012Metric
Q1001, Q1002: BSS138; SOT-23-3
Q1003: BSS138; SOT-23
R1001: 33R; R_0603_1608Metric
R1002, R1003, R1006, R1013, R1021: 100K; R_0603_1608Metric
R1004, R1005, R1011, R1012, R1014: 1K; R_0603_1608Metric
R1007, R1008: 27R; R_0603_1608Metric
R1009, R1010, R1015, R1016: 5K; R_0603_1608Metric; not fitted
R1017, R1018: 10K; R_0603_1608Metric
R1019: 330R; R_0603_1608Metric
R1020: 100R; R_0603_1608Metric
R1022, R1023, R1024, R1025: 5K; R_0603_1608Metric
SW1001, SW1002: B3U-1000P; SW_SPST_B3U-1000P
U1001: TMP75BQDRQ1; SOIC127P600X175-8N; Mouser Part Number 595-TMP75BQDRQ1
U1002: RP2354B; QFN-80-1EP_10x10mm_P0.4mm_EP3.4x3.4mm
U1003: TCA9539AQPWRQ1; SOP65P640X120-24N; Manufacturer_Part_Number TCA9539AQPWRQ1
Y1001: ABM8-272-T3; Crystal_SMD_Abracon_ABM8AIG-4Pin_3.2x2.5mm

Connections:
+1V1: C1013.1, C1014.1, C1015.1, C1016.1, L1001.2, U1002.10 (DVDD), U1002.32 (DVDD), U1002.51 (DVDD), U1002.65 (VREG_FB)
+3V3: C1001.1, C1002.1, C1003.1, C1004.1, C1005.1, C1006.1, C1007.1, C1008.1, C1009.1, C1010.1, C1011.1, C1012.1, C1018.1, C1021.1, D1001.2 (A), R1001.1, R1002.1, R1003.1, R1009.1, R1010.1, R1015.1, R1016.1, R1017.1, R1018.1, R1022.1, R1023.1, R1024.1, R1025.1, U1001.8 (VS), U1002.5 (IOVDD), U1002.15 (IOVDD), U1002.24 (IOVDD), U1002.29 (IOVDD), U1002.41 (IOVDD), U1002.50 (IOVDD), U1002.59 (ADC_AVDD), U1002.60 (IOVDD), U1002.64 (VREG_VIN), U1002.68 (USB_OTP_VDD), U1002.69 (QSPI_IOVDD), U1002.76 (IOVDD), U1003.24 (VCC)
ACC_OK: U1002.44 (GPIO35)
AMP_MUTE_CTL: U1002.20 (GPIO20)
AMP_STBY_CTL: U1002.19 (GPIO19)
AUDIO_I2C_SCL: R1022.2, U1002.46 (GPIO37)
AUDIO_I2C_SDA: R1023.2, U1002.45 (GPIO36)
BACKLIGHT_EN: U1003.7 (P03)
BOOTSEL_ASSERT: Q1002.1 (G), R1013.2
CAMERA_5V_EN: U1003.9 (P05)
CAMERA_12V_EN: U1003.10 (P06)
CSPI_MISO: U1002.1 (GPIO4)
CSPI_MOSI: U1002.80 (GPIO3)
CSPI_RESET: U1002.4 (GPIO7)
CSPI_SCK: U1002.79 (GPIO2)
FAN_PWM: U1002.22 (GPIO22)
FAN_TACH: U1002.23 (GPIO23)
FIO_BLUE_PWM: U1002.56 (GPIO45/ADC5)
FIO_GREEN_PWM: U1002.58 (GPIO47/ADC7)
FIO_PREVIOUS/NEXT: U1002.52 (GPIO41/ADC1)
FIO_RED_PWM: U1002.57 (GPIO46/ADC6)
FIO_RESET: U1002.53 (GPIO42/ADC2)
FIO_SWITCHES: U1002.54 (GPIO43/ADC3)
FIO_VOLUME: U1002.49 (GPIO40/ADC0)
GND: C1001.2, C1002.2, C1003.2, C1004.2, C1005.2, C1006.2, C1007.2, C1008.2, C1009.2, C1010.2, C1011.2, C1012.2, C1013.2, C1014.2, C1015.2, C1016.2, C1017.2, C1018.2, C1019.2, C1020.2, C1021.2, J1001.2, J1001.MP (MountPin), J1002.2, J1002.MP (MountPin), Q1001.2 (S), Q1002.2 (S), Q1003.2 (S), R1005.1, R1006.1, R1011.1, R1013.1, R1021.2, U1001.4 (GND), U1001.5 (A2), U1001.6 (A1), U1001.7 (A0), U1002.62 (VREG_PGND), U1002.81 (GND), U1003.2 (A1), U1003.12 (GND), U1003.21 (A0), Y1001.2, Y1001.4
I2S_BCLK: U1002.11 (GPIO12)
I2S_DIN: U1002.14 (GPIO15)
I2S_DOUT: U1002.13 (GPIO14)
I2S_LRCLK: U1002.12 (GPIO13)
I2S_MCLK: U1002.16 (GPIO16)
ILLUM_OK: U1002.43 (GPIO34)
IMMO_RELAY_EN: U1002.37 (GPIO29)
LCD_1V8_EN: U1003.5 (P01)
LCD_BIAS_EN: U1003.4 (P00)
MCU_RESET: Q1001.3 (D), R1004.1
MCU_USB_BOOT: Q1002.3 (D), R1012.1
MCU_USB_D+: R1008.1
MCU_USB_D-: R1007.1
MODEM_PERST_ASSERT: U1003.13 (P10)
MODEM_PWR_EN: U1003.11 (P07)
MODEM_W_DISABLE_ASSERT: U1002.26 (GPIO25)
RESET: R1005.2, SW1001.1
RESET_ASSERT: Q1001.1 (G), R1006.2
REVERSE_OK: U1002.38 (GPIO30)
RUN: R1002.2, R1004.2, SW1001.2, U1002.35 (RUN)
SPARE_ADC0: U1002.55 (GPIO44/ADC4)
STATUS_LED: R1020.1, U1003.14 (P11)
STS_LED_C: D1001.1 (K), R1019.1
STS_LED_G: Q1003.1 (G), R1020.2, R1021.1
STS_LED_R: Q1003.3 (D), R1019.2
SWCLK: J1002.1, U1002.33 (SWCLK)
SWD: J1002.3, U1002.34 (SWDIO)
SYS_HOLD: U1002.21 (GPIO21)
SYS_I2C_SCL: R1009.2, R1016.2, R1024.2, U1001.2 (SCL), U1002.48 (GPIO39), U1003.22 (SCL)
SYS_I2C_SDA: R1010.2, R1015.2, R1025.2, U1001.1 (SDA), U1002.47 (GPIO38), U1003.23 (SDA)
TOUCH_3V3_EN: U1003.6 (P02)
UART0_RX: J1001.1, U1002.78 (GPIO1)
UART0_TX: J1001.3, U1002.77 (GPIO0)
USB_DM_N: R1007.2, U1002.66 (USB_DM)
USB_DP_P: R1008.2, U1002.67 (USB_DP)
USB_VBUS_EN: U1003.8 (P04)
VREG_AVDD: C1017.1, R1001.2, U1002.61 (VREG_AVDD)
VREG_LX: L1001.1, U1002.63 (VREG_LX)
XIN: C1019.1, U1002.30 (XIN), Y1001.1
XOUT: R1014.2, U1002.31 (XOUT)
XOUT_R: C1020.1, R1014.1, Y1001.3
~AUDIO_CODEC_RESET: U1002.25 (GPIO24)
~CAMERA_5V_FLT: U1003.18 (P15)
~CAMERA_12V_FLT: U1003.19 (P16)
~CSPI_CS: U1002.2 (GPIO5)
~CSPI_INT: U1002.3 (GPIO6)
~GPIO_EXP_INT: R1017.2, U1002.17 (GPIO17), U1003.1 (~INT)
~GPIO_EXP_RESET: R1018.2, U1002.18 (GPIO18), U1003.3 (~RESET)
~LCD_BIAS_FLT: U1003.15 (P12)
~MODEM_3V3_FLT: U1003.20 (P17)
~QSPI_SS: R1003.2, R1012.2, SW1002.2, U1002.75 (~QSPI_SS)
~RP2354_HOST_IRQ: U1002.40 (GPIO32)
~TOUCH_3V3_FLT: U1003.16 (P13)
~USB_BOOT: R1011.2, SW1002.1
~USB_VBUS_FLT: U1003.17 (P14)

Notes on the sheet:
As close to VREG_FB/65
RP2354B MCU
LAYOUT NOTE: Place R1002 and R1003 near the RP2354 pins, then the buttons/FET branches can be secondary.
Board Temperature Sensor
As close to DVDD/10/32/51
Address: 74h (0111010)
GPIO Expander
As close to VREG_LX/63
LAYOUT NOTE: Each 100nF cap is placed as near as possible to pins: 5, 15, 24, 29, 41, 50, 59, 60, 68, 69, & 76
Layout Example
Address: 49h (1001000)
LAYOUT NOTE: As close to VREG_VIN/R1001
DESIGN NOTE: For USB firmware update from the CM5, you’ll want two CM5-controlled signals: RP2354_RUN_CONTROL RP2354_USB_BOOT / QSPI_SS_CONTROL Sequence: 1. Pull QSPI_SS/USB_BOOT low 2. Pull RUN low 3. Release RUN high 4. Release QSPI_SS after reset sampling window 5. RP2354 enumerates to CM5 as US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
LAYOUT NOTE: As close to VREG_AVDD/61
