mibs510/OpenXTCM5-Head-Unit/pcb/usb.kicad_sch

## KiCad design pcb/usb.kicad_sch (2026-10-04)

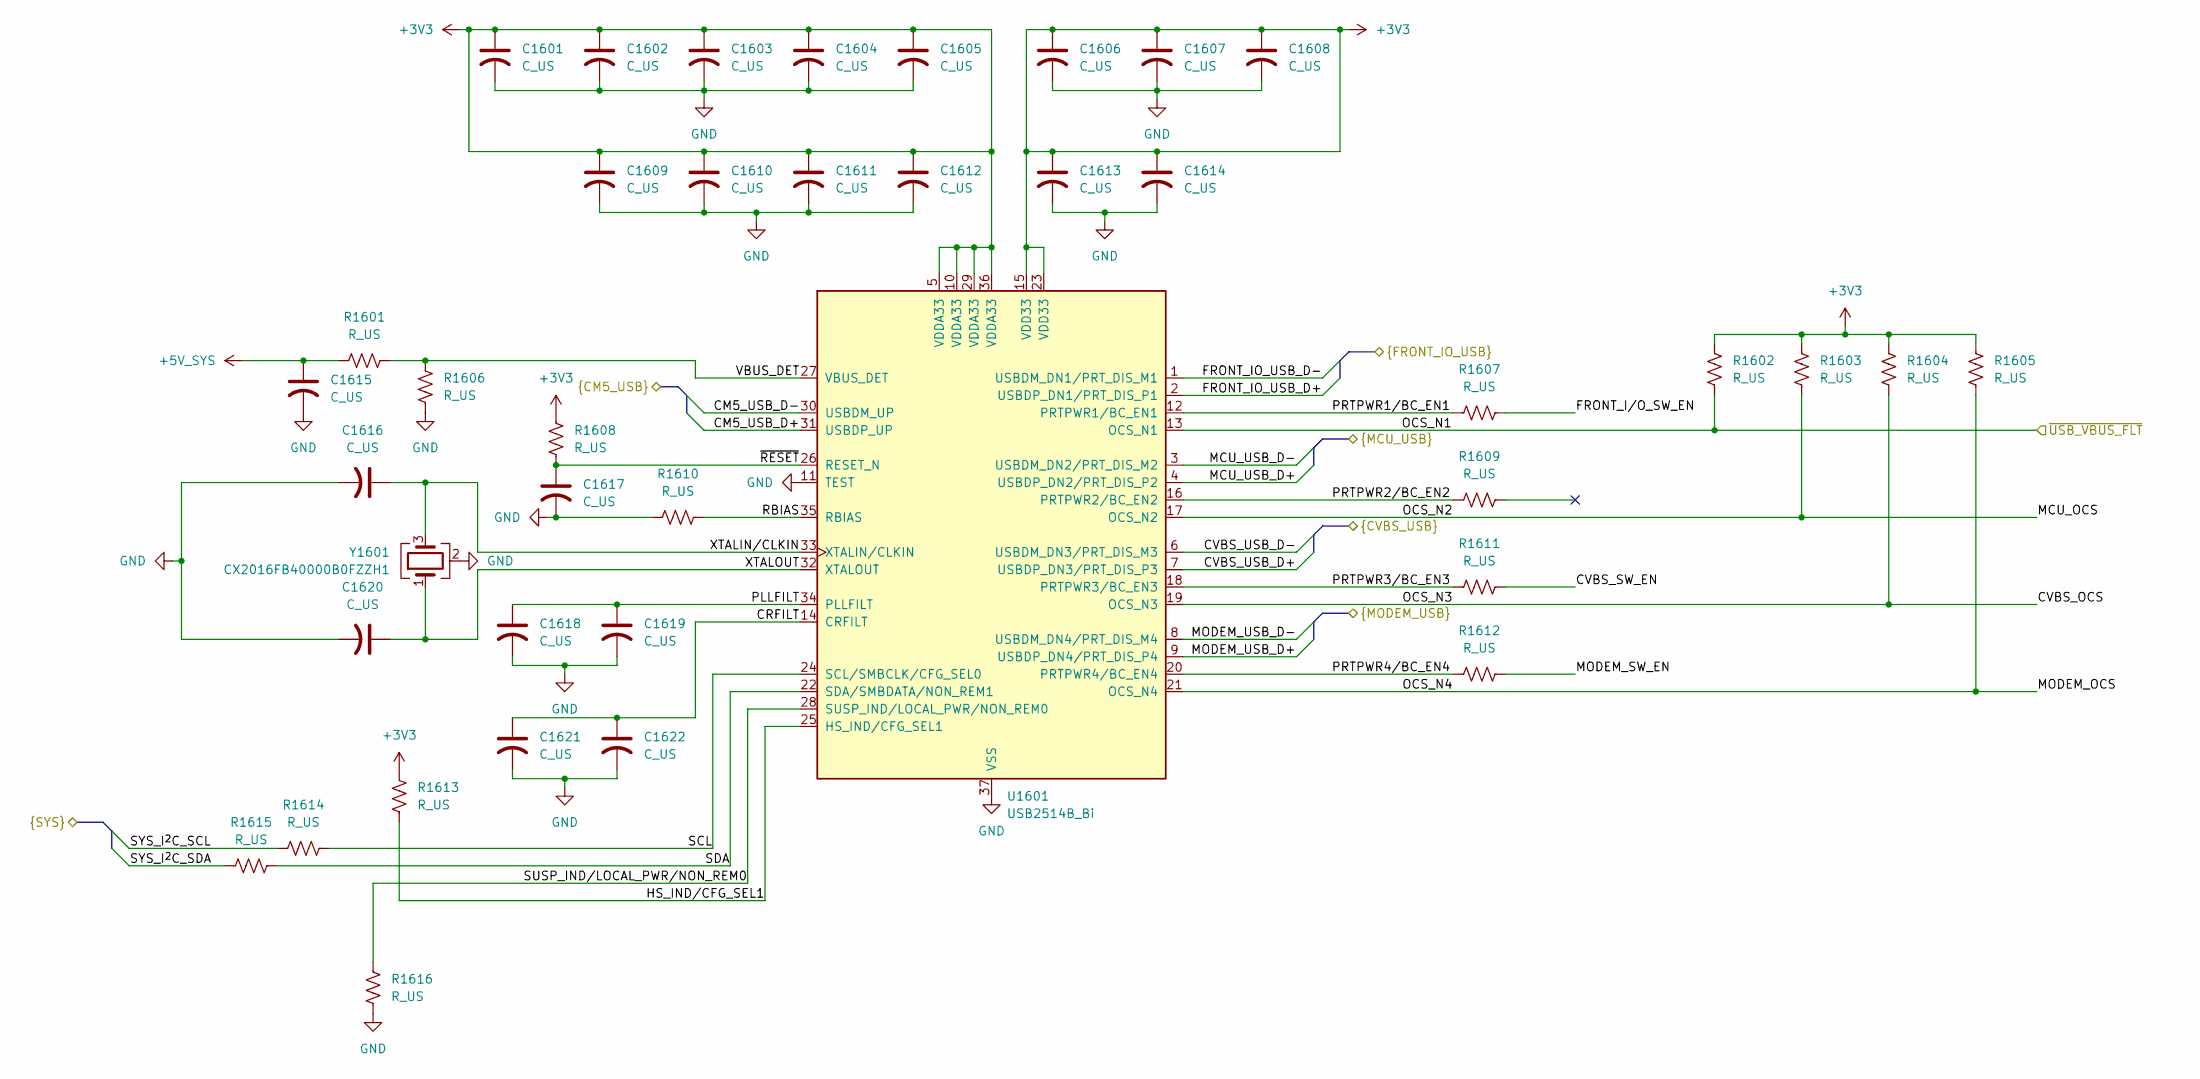
[picture p19: schematic usb.kicad_sch]

Parts:
C1601, C1602, C1603, C1604, C1605, C1606, C1607, C1608, C1609, C1610, C1611, C1612, C1613, C1614, C1615, C1616, C1617, C1618, C1619, C1620, C1621, C1622: C_US; C_0603_1608Metric
R1601, R1602, R1603, R1604, R1605, R1606, R1607, R1608, R1609, R1610, R1611, R1612, R1613, R1614, R1615, R1616: R_US; R_0603_1608Metric
U1601: USB2514B_Bi; QFN-36-1EP_6x6mm_P0.5mm_EP4.1x4.1mm_ThermalVias
Y1601: CX2016FB40000B0FZZH1; Crystal_SMD_2016-4Pin_2.0x1.6mm

Connections:
+3V3: C1601.1, C1602.1, C1603.1, C1604.1, C1605.1, C1606.1, C1607.1, C1608.1, C1609.1, C1610.1, C1611.1, C1612.1, C1613.1, C1614.1, R1602.2, R1603.2, R1604.2, R1605.2, R1608.2, R1613.2, U1601.5 (VDDA33), U1601.10 (VDDA33), U1601.15 (VDD33), U1601.23 (VDD33), U1601.29 (VDDA33), U1601.36 (VDDA33)
+5V_SYS: C1615.1, R1601.2
CM5_USB_D+: U1601.31 (USBDP_UP)
CM5_USB_D-: U1601.30 (USBDM_UP)
CRFILT: C1621.1, C1622.1, U1601.14 (CRFILT)
CVBS_OCS: R1604.1, U1601.19 (OCS_N3)
CVBS_SW_EN: R1611.2
CVBS_USB_D+: U1601.7 (USBDP_DN3/PRT_DIS_P3)
CVBS_USB_D-: U1601.6 (USBDM_DN3/PRT_DIS_M3)
FRONT_I/O_SW_EN: R1607.2
FRONT_IO_USB_D+: U1601.2 (USBDP_DN1/PRT_DIS_P1)
FRONT_IO_USB_D-: U1601.1 (USBDM_DN1/PRT_DIS_M1)
GND: C1601.2, C1602.2, C1603.2, C1604.2, C1605.2, C1606.2, C1607.2, C1608.2, C1609.2, C1610.2, C1611.2, C1612.2, C1613.2, C1614.2, C1615.2, C1616.2, C1617.2, C1618.2, C1619.2, C1620.2, C1621.2, C1622.2, R1606.1, R1610.1, R1616.1, U1601.11 (TEST), U1601.37 (VSS), Y1601.2 (G), Y1601.4 (G)
HS_IND/CFG_SEL1: R1613.1, U1601.25 (HS_IND/CFG_SEL1)
MCU_OCS: R1603.1, U1601.17 (OCS_N2)
MCU_USB_D+: U1601.4 (USBDP_DN2/PRT_DIS_P2)
MCU_USB_D-: U1601.3 (USBDM_DN2/PRT_DIS_M2)
MODEM_OCS: R1605.1, U1601.21 (OCS_N4)
MODEM_SW_EN: R1612.2
MODEM_USB_D+: U1601.9 (USBDP_DN4/PRT_DIS_P4)
MODEM_USB_D-: U1601.8 (USBDM_DN4/PRT_DIS_M4)
OCS_N1: R1602.1, U1601.13 (OCS_N1)
PLLFILT: C1618.1, C1619.1, U1601.34 (PLLFILT)
PRTPWR1/BC_EN1: R1607.1, U1601.12 (PRTPWR1/BC_EN1)
PRTPWR2/BC_EN2: R1609.1, U1601.16 (PRTPWR2/BC_EN2)
PRTPWR3/BC_EN3: R1611.1, U1601.18 (PRTPWR3/BC_EN3)
PRTPWR4/BC_EN4: R1612.1, U1601.20 (PRTPWR4/BC_EN4)
RBIAS: R1610.2, U1601.35 (RBIAS)
SCL: R1614.1, U1601.24 (SCL/SMBCLK/CFG_SEL0)
SDA: R1615.1, U1601.22 (SDA/SMBDATA/NON_REM1)
SUSP_IND/LOCAL_PWR/NON_REM0: R1616.2, U1601.28 (SUSP_IND/LOCAL_PWR/NON_REM0)
SYS_I^{2}C_SCL: R1614.2
SYS_I^{2}C_SDA: R1615.2
VBUS_DET: R1601.1, R1606.2, U1601.27 (VBUS_DET)
XTALIN/CLKIN: C1616.1, U1601.33 (XTALIN/CLKIN), Y1601.3
XTALOUT: C1620.1, U1601.32 (XTALOUT), Y1601.1
~RESET: C1617.1, R1608.1, U1601.26 (RESET_N)
